Seba-SL/TP-Taller-de-Dise-o-de-Circuitos-Electr-nicos-TA138-/Checkpoints/Checkpoint 4/Informe CHK 4/informe.tex

\documentclass[]{article}

\usepackage{graphicx}
\usepackage[margin=1.5cm,top=1.5cm,bottom=1.5cm,a4paper]{geometry}
\usepackage{graphicx} % Required for inserting images
\usepackage{titlesec} % Required for customizing section titles
\usepackage[margin=1.5cm,top=1.5cm, bottom=1.5cm]{geometry} % Ajusta los márgenes aquí
\usepackage{multicol} % Required for multicols environment
\usepackage{parskip}
\usepackage{etoolbox}
\usepackage{tcolorbox}
\usepackage{float}
\usepackage{amsmath}
\usepackage{dingbat}
\usepackage{booktabs} 
\usepackage{caption}
\usepackage[utf8]{inputenc}
\usepackage[T1]{fontenc}
\usepackage{amssymb}
\usepackage[spanish]{babel}
\usepackage{multirow}
\usepackage{siunitx}
\usepackage{circuitikz}
\usepackage{pdflscape}
\usepackage{subcaption}
\usepackage{array}
\usepackage{tcolorbox}
\usepackage{xcolor}
\usepackage{pdfpages}
\usepackage{placeins}

\newif\ifcheckpoint
\checkpointfalse

% función que devuelve color según checkpoint
\newcommand{\checkpointcolor}[1]{%
	\ifcase#1
	yellow%
	\or blue%
	\or green%
	\or red%
	\or orange%
	\else gray%
	\fi
}
\newcommand{\checkpointstart}[1]{%
	\ifcheckpoint
	\edef\tempcolor{\checkpointcolor{#1}}%
	\begin{tcolorbox}[
		colback=\tempcolor!15,
		colframe=\tempcolor!60!black,
		boxrule=0pt,
		arc=0pt,
		width=\textwidth
		]
		\textbf{Inicio checkpoint #1}
	\end{tcolorbox}
	\fi
}

\newcommand{\checkpointend}[1]{%
	\ifcheckpoint
	\edef\tempcolor{\checkpointcolor{#1}}%
	\begin{tcolorbox}[
		colback=\tempcolor!15,
		colframe=\tempcolor!60!black,
		boxrule=0pt,
		arc=0pt,
		width=\textwidth
		]
		\textbf{Fin checkpoint #1}
	\end{tcolorbox}
	\fi
}

\usepackage{tikz}
\usetikzlibrary{arrows.meta, positioning}
\usetikzlibrary{babel}

\usepackage{csquotes}

\usepackage[
backend=biber,
style=apa,
citestyle=apa
]{biblatex}

\addbibresource{referencias.bib}

\begin{document}
	
	\begin{titlepage}
		
		\centering
		{}
		
		\centerline
		
		{\bfseries\LARGE Taller de Diseño de Circuitos Electrónicos   \par}
		
		{\bfseries\LARGE TA138  \par}
		\vspace{.5cm}
		{\scshape\Large Facultad de Ingenier\'ia Universidad de Buenos Aires \par}
		\vspace{1.5cm}
		%{\scshape\Huge Trabajo Pr\'actico \par}
		{\scshape\Huge Diseño de Fuente de Alimentación \par}
		\vspace{2cm}
		{\scshape\Large Checkpoint 4: Diseño y Validación de Conversor \textit{Buck} a Lazo Abierto\par}

		\vspace{2cm}
		
		\begin{tabular}{ p{4cm} p{2cm} p{4cm}}
			\textbf{Alumnos:} & \textbf{Padr\'on:} & \textbf{Mail:} \\
			Lazo, Sebastian Nahuel & 106213 &slazo@fi.uba.ar \\
			Flores, Ahmed Ali & 106238 & aaflores@fi.uba.ar  \\
			Mántaras, Ramiro  & 111510 &rmantaras@fi.uba.ar \\
			
		\end{tabular}

		\vspace{1cm}
		
		\begin{tabular}{ p{6cm} p{6cm} p{6cm}}
			\textbf{Docentes:}  
			\\Teóricas: Julio Zola & Tutor: Sergio Andres Quinteros  
		\end{tabular}
		
	\end{titlepage}

	\newpage

	\tableofcontents \label{Indice}
	\newpage
	\section{Introducción}
	
	En el checkpoint 4 se continúa con el desarrollo de una fuente de alimentación conmutada tipo \textit{buck} destinada a obtener una tensión de salida regulada de 9.5 V a partir de una fuente de alimentación de continua proveniente de una batería. El sistema debe operar de manera eficiente frente a variaciones de tensión de entrada comprendidas entre 12 V y 30 V, permitiendo su utilización en aplicaciones industriales y automotrices destinadas a la alimentación de microcontroladores, sensores y sistemas de comunicación.
	
	En etapas previas del proyecto se desarrolló y verificó el funcionamiento de la conversión de 9,5 V a 5 V, en el apéndice \ref{sec:etapa_previa} se agregaron mediciones extra pedidas y modificaciones de acuerdo a los errores encontrados en el checkpoint previo. En esta instancia se avanza sobre el diseño y validación de la etapa \textit{buck} en lazo abierto, incorporando aspectos vinculados tanto a la simulación funcional como a el diseño circuital del sistema.
	
	Asimismo, se aborda el diseño del circuito generador PWM utilizado para el control de conmutación, el análisis de las características físicas y constructivas del inductor diseñado, y el desarrollo del diseño PCB correspondiente a la fuente \textit{buck} en lazo abierto.
	
	\section{Objetivo}
	Los objetivos del presente checkpoint son:
	
	\begin{itemize}
		\item Verificar mediante simulaciones el correcto funcionamiento de la fuente buck en configuración de lazo abierto.
		
		\item Diseñar e implementar el circuito PWM encargado de generar la señal de conmutación del convertidor.
		
		\item Analizar y definir las características físicas del inductor diseñado para la etapa de potencia.
		
		\item Realizar el diseño PCB de la fuente buck en lazo abierto considerando criterios de implementación electrónica y distribución física.
		
		\item Integrar los distintos bloques desarrollados con el fin de avanzar hacia una implementación funcional del sistema de alimentación switching.
	\end{itemize}

	\section{Desarrollo}
	
	\subsection{Especificaciones del Regulador BUCK}
	El sistema deberá operar con una tensión de entrada comprendida entre \SI{12}{V} y \SI{30}{V} considerándose como tensión típica \SI{24}{V}, entregando una tensión regulada nominal de aproximadamente \SI{9.5}{V}. 
	
	Asimismo, la corriente de salida deberá encontrarse en el rango de \SI{750}{mA} a \SI{1.5}{A}, manteniendo una eficiencia comprendida entre el 85\% y el 95\%, dependiendo de las condiciones de operación.
	
	La frecuencia de conmutación seleccionada para el convertidor será del rango de 
	\SI{120}{kHz} hasta \SI{140}{kHz}.
	
	\renewcommand{\arraystretch}{1.3}
		\begin{table}[H]
		\centering
		\caption{Especificaciones del regulador BUCK}
		\label{tab:spec_buck}
		\begin{tabular}{|c|c|}
			\hline
			Parámetro & Valor \\  \hline \hline
			Tensión de entrada $V_{IN}$ & \SI{12}{V} -- \SI{30}{V} \\ \hline
			Tensión regulada $V_{REG}$ & \SI{9.5}{V} nominal \\ \hline
			Corriente de salida $I_{OUT}$ & \SI{750}{mA} -- \SI{1.5}{A} \\ \hline
			Eficiencia $\eta$ & 85\% -- 95\% \\ \hline
			Frecuencia de conmutación $f_{sw}$ & \SI{120}{kHz} -- \SI{140}{kHz} \\ \hline
		\end{tabular}
	\end{table}
	
	\subsubsection{Convertidor BUCK}
	
	En términos generales, un convertidor \textit{buck} se alimenta de una señal de entrada a a regular, por medio de dos transistores en conmutación, que generan una señal cuadrada que tiene como valor medio la tensión objetivo, la señal cuadrada generada es filtrada por un filtro LC, obteniendo de esta forma una tensión regulada con riple cuadrático. En la figura \ref{fig:buck_schematic}, se observa un circuito \textit{buck} inicial de diseño.
	
	\begin{figure}[H]
		\centering
		\resizebox{0.9\textwidth}{!}{
\begin{tikzpicture}[transform shape]
	% Paths, nodes and wires:
	\node[nigfetd, rotate=90](N1) at (11.77, 11){} node[anchor=south] at (N1.text){$Q_1$};
	\node[nigfetd](N2) at (14, 9.27){} node[anchor=west] at (N2.text){$Q_2$};
	\draw (18, 11) to[capacitor, l={$C_S$}] (18, 8);
	\draw (20, 11) to[american resistor, l={$R_S$}] (20, 8);
	\draw (14, 11) -- (14, 10);
	\draw (18, 8) |- (14, 8) -| (14, 8.46);
	\draw (18, 11) -- (20, 11);
	\draw (20, 8) -- (18, 8);
	\draw (12.039, 10.02) |- (11, 9.5);
	\draw (14, 8.5) -| (14, 8.46);
	\draw (13.02, 9) -| (11, 9);
	\draw (9, 8) to[capacitor, l={$C_E$}] (9, 11);
	\draw (9, 8) -- (14, 8);
	\draw (9, 11) -- (11, 11);
	\draw (12.54, 11) -- (14, 11);
	\draw (14, 11) to[cute inductor, l={$L$}] (18, 11);
	\draw (6, 11) to[battery, l={$V_E$}] (6, 8);
	\node[circ] at (9, 11){};
	\node[circ] at (9, 8){};
	\node[circ](N3) at (11, 9.5){} node[anchor=east] at (N3.text){$H_{ctrl}$};
	\node[circ](N4) at (11, 9){} node[anchor=east] at (N4.text){$L_{ctrl}$};
	\node[circ] at (14, 8){};
	\node[circ](N5) at (14, 11){} node[anchor=south] at (N5.text){$V_S$};
	\node[circ] at (18, 11){};
	\node[circ] at (18, 8){};
	\node[circ](N6) at (20, 11){} node[anchor=south] at (N6.text){$V_o$};
	\node[flowarrow] at (21.25, 11){};
	\draw (20, 11) -- (21, 11);
	\draw (9, 11) -- (6, 11);
	\draw (9, 8) |- (6, 8);
\end{tikzpicture}
		}
		\caption{Circuito \textit{buck}.}
		\label{fig:buck_schematic}
		
	\end{figure}

	Entendiendo la señal de control como una señal periódica cuadrada que alterna entre una tensión suficiente para colocar a los transistores en saturación (\textit{on}) y otra que los lleva a corte (\textit{off}), en dicha señal se define el tiempo $t_{ON}$ como el tiempo que dura la señal que permite la conducción en el transistor en un periodo T. Aquí a su vez se define el ciclo de trabajo D (duty cicle) como $ D = \frac{t_{ON}}{T}$. 
	
	\begin{figure}[H]
		\centering
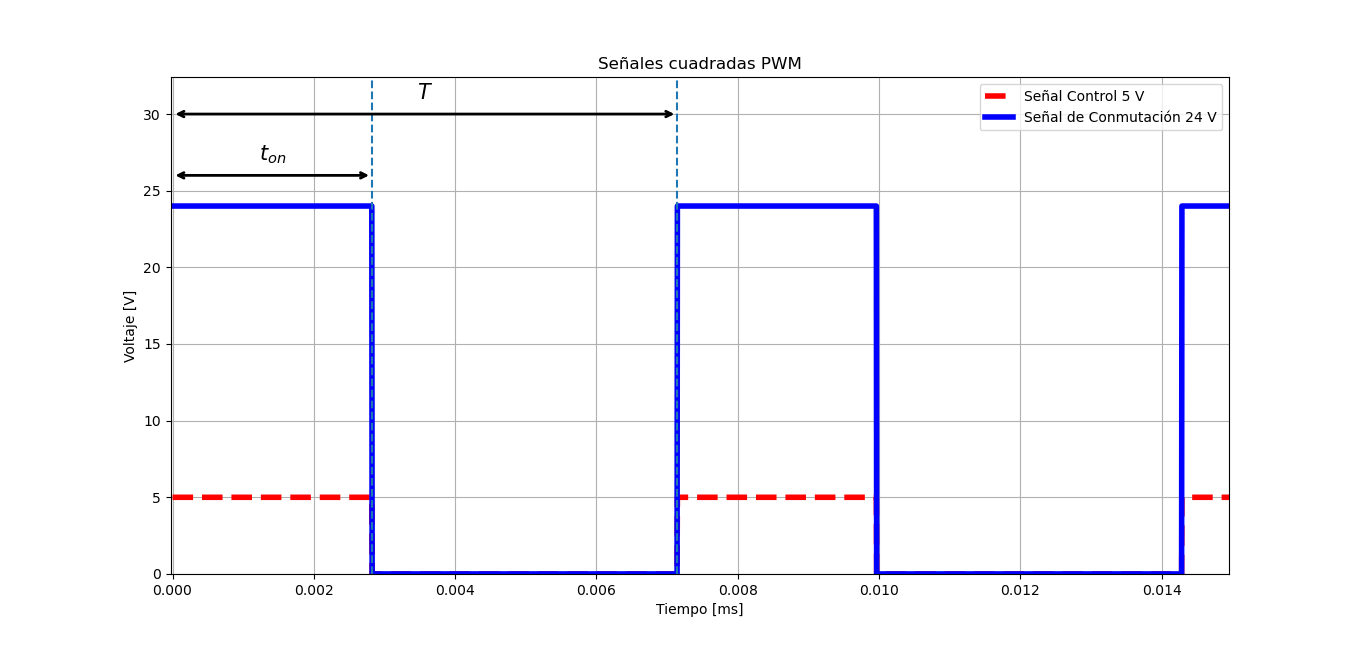
[picture p1: Checkpoints/Checkpoint 4/Informe CHK 4/img/buck/vcontrol.png]
		
		\caption{ Señal de control y señal conmutada lograda en el circuito buck.}
		\label{fig:vcontrol}
		\end{figure}

	Teniendo en cuenta que el transistor permite replicar la señal de control en el nodo que interconecta los transistores y el inductor, pero con una tensión cercana a la tensión de alimentación, dicha señal se define como señal de conmutación o \textit{switching} $V_s$. Tal como se ve en la figura \ref{fig:vcontrol}.

	De esta relación estimando las tensiones de saturación y de caida de tensión en directa del diodo utilizado, se puede dar con una primer aproximación de D. Aproximando la salida del regulador como la componente continua de la señal de conmutación, idealizando el filtro LC.

	\begin{equation}
		V_o \approx V_{s_{\text{prom}}}
		=
		\frac{1}{T}\int_0^T v_s(t)\,dt
	\end{equation}
	
	Considerando que durante el intervalo de conducción del transistor ($t_{on}$) la tensión aplicada al inductor es aproximadamente $(V_E - V_{SAT})$, y durante el intervalo restante ($T-t_{on}$) el diodo conduce imponiendo una tensión aproximada $-V_D$, la señal de conmutación puede modelarse como:
	
	\begin{equation}
		v_s(t)=
		\begin{cases}
			V_E - V_{SAT}, & 0<t<t_{on} \\
			-V_{SAT}, & t_{on}<t<T
		\end{cases}
	\end{equation}
	
	Por lo tanto, el valor promedio resulta:
	
	\begin{equation}
		V_o \approx
		\frac{1}{T}
		\left[
		\int_0^{t_{on}} (V_E - V_{SAT})\,dt
		+
		\int_{t_{on}}^T (-V_{SAT})\,dt
		\right]
	\end{equation}
	
	Resolviendo las integrales:
	
	\begin{equation}
		V_o \approx
		\frac{1}{T}
		\left[
		(V_E - V_{SAT})t_{on}
		-
		V_{SAT}(T-t_{on})
		\right]
	\end{equation}
	
	Reordenando:
	
	\begin{equation}
		V_o \approx
		\frac{t_{on}}{T}(V_E - V_{SAT})
		-
		\frac{T-t_{on}}{T}V_{SAT}
	\end{equation}
	
	Definiendo el ciclo de trabajo como:
	
	\begin{equation}
		D = \frac{t_{on}}{T}
	\end{equation}
	
	y teniendo en cuenta que:
	
	\begin{equation}
		1-D = \frac{T-t_{on}}{T}
	\end{equation}
	
	se obtiene finalmente:
	
	\begin{equation}
		V_o \approx D(V_E - V_{SAT}) - (1-D)V_{SAT}
	\end{equation}

	Aproximando las caídas de tensión de los transistores en conducción a cero:
	
	\begin{equation}
		V_{SAT} \approx 0
	\end{equation}
	
	la expresión obtenida previamente se simplifica a:
	
	\begin{equation}
		V_o \approx D \cdot V_E
	\end{equation}
	
	Despejando el ciclo de trabajo:
	
	\begin{equation}
		D \approx \frac{V_o}{V_E}
	\end{equation}
	
	Reemplazando con los valores de diseño:
	
	\begin{equation}
		D \approx \frac{9.5\,V}{24\,V}
	\end{equation}
	
	\begin{equation}
		D \approx 0.396
	\end{equation}
	
	Por lo tanto, el ciclo de trabajo requerido resulta aproximadamente:
	
	\begin{equation}
		D \approx 39.6\%
	\end{equation}

	El principio de funcionamiento del regulador se basa en la transferencia periódica de energía desde la fuente de entrada hacia la carga mediante la conmutación controlada de los dispositivos electrónicos de potencia. La tensión media de salida se regula variando el ciclo de trabajo $D$ de la señal PWM aplicada a las llaves de conmutación.

	Asimismo, se analizará el regulador operando en modo de conducción continua (CCM, \textit{Continuous Conduction Mode}), condición en la cual la corriente del inductor nunca se anula ni invierte su sentido. Bajo esta hipótesis, la corriente del inductor presenta una forma aproximadamente triangular con un valor medio distinto de cero, mientras que el capacitor forma una tensión integrando dicha tensión menos la corriente de salida, dado que la integral de una señal lineal que alterna entre pendiente positiva y negativa la tensión del capacitor sera una señal cuadrática tal como se observa en la figura \ref{fig:corrienteilriplevo}.
	
	A partir de estas consideraciones será posible determinar posteriormente los valores adecuados del inductor $L$ y del capacitor $C$, de forma tal de garantizar un funcionamiento estable en conducción continua y un rizado acotado en corriente y tensión.

	\begin{figure}[H]
	\centering
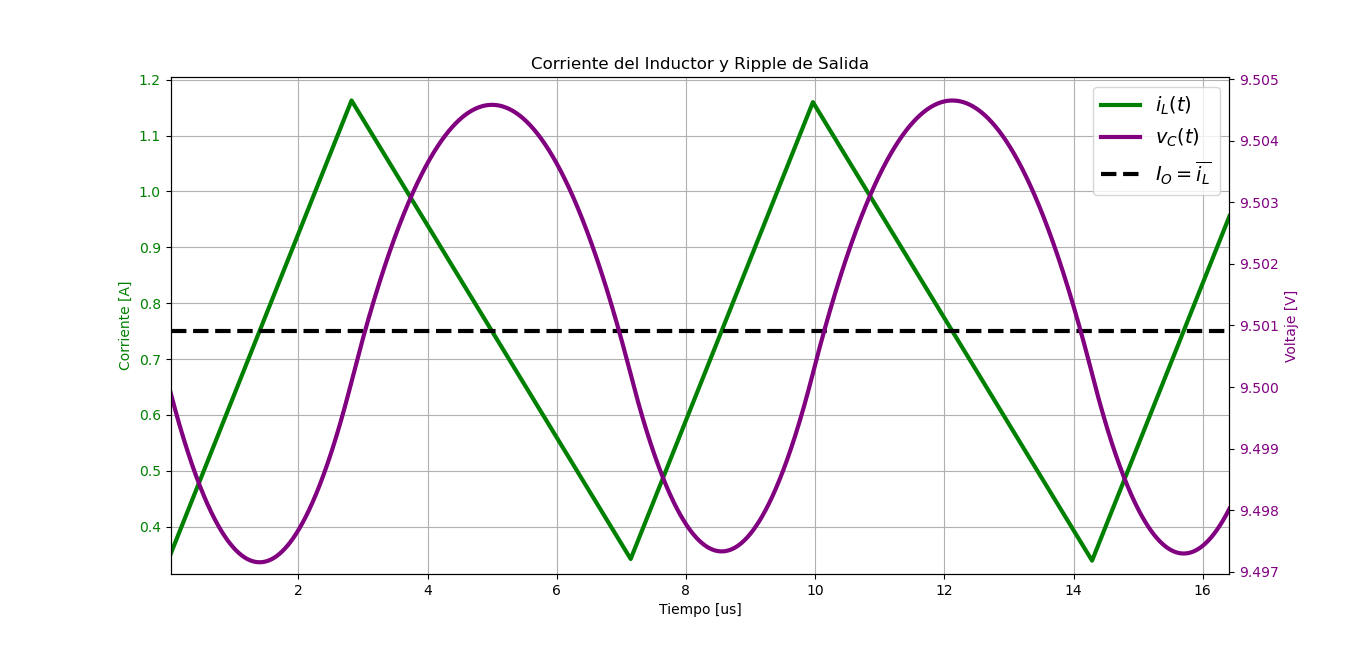
[picture p2: Checkpoints/Checkpoint 4/Informe CHK 4/img/buck/corriente_iL_riple_Vo.png]
	
	\caption{Forma de la señal de corriente en el inductor y tensión en el capacitor del regulador.}
	\label{fig:corrienteilriplevo}
	\end{figure}

	La corriente de salida se puede aproximar a la corriente media en el inductor, justamente para que la corriente no se vuelva discontinua la corriente de salida debe ser mayor a cero, es por eso que se fija un resistor de salida para que la corriente de salida no llegue a ser nula. 
	
	\begin{equation}
		I_O \approx \frac{I_{L\text{MAX}} + I_{L\text{MIN}}}{2}
	\end{equation}

	\subsection{Elección de elementos esenciales $L$ , $C_S$ , $C_E$ y $Q$}
	
	\subsubsection{Inductor $L$ y capacitor $C_S$}
	
	Teniendo en cuenta que para el ciclo \textit{off} la tensión de salida corresponde con aproximadamente la tensión en el inductor:
	
	\begin{equation}
		V_o \approx L \frac{d i_L }{dt} = L \frac{ {I_{min}} - {I_{max}} }{  T - t_{on}}
	\end{equation} 
	
	Despejando el valor de inductancia:
	
	\begin{equation}
		L \approx V_o  \frac{  T - t_{on}}{ {I_{min}} - {I_{max}} }
	\end{equation} 
	
	Sacando como factor común T de la expresión e ingresando D.

	\begin{equation}
	L \approx V_o  \frac{  T - t_{on}}{ {I_{min}} - {I_{max}} } =  V_o  T \frac{  (1 - \frac{t_{on}}{T})}{ {I_{min}} - {I_{max}} } 
	\end{equation} 

	\begin{equation}
		L \approx  V_o  T \frac{  1 - D} {   I_{min} - {I_{max}}    } 
	\end{equation} 
	
	Ahora sabiendo que $I_o = \frac{(I_{min} - I_{max})}{2}$ y despejando $ I_{min} = 2I_o - I_{max}$, se reemplaza:
	
	\begin{equation}
		L \approx  V_o \cdot T \frac{  1 - D} {   (2I_o - I_{max}) - {I_{max}}    } 
	\end{equation} 

	\begin{equation}
		L \approx  V_o \cdot T \frac{  1 - D} {   (2I_o - 2I_{max})   }  = V_o \cdot T \frac{  1 - D} {   2(I_o - I_{max})   }
	\end{equation} 

	\begin{equation}
		L \approx  V_o \cdot T \frac{  1 - D} {   (2I_o - 2I_{max})   }  = V_o  \frac{T}{2} \frac{  1 - D} {   (I_o - I_{max})   }
	\end{equation} 

	Reemplazando $T = \frac{1}{f}$ se obtiene finalmente la expresión:
	
	\begin{equation}
		L =
		\frac{1}{2f}
		\left(
		\frac{(1-D)V_S}{I_{L\text{MAX}} - I_o}
		\right)
	\end{equation}

	De esta forma se puede estimar un valor de inductancia 
	Partiendo de:
	
	\begin{equation}
		L = \frac{1}{2f}\,\frac{(1-D)V_o}{(I_{L\text{MAX}} - I_o)}
	\end{equation}
	
	y siendo para el modo crítico:
	
	\begin{equation}
		I_o = I_{o\text{MIN}}
	\end{equation}
	
	Resulta:
	
	\begin{equation}
		I_{L\text{MAX}} = 2I_{o\text{MIN}}
	\end{equation}
	
	\begin{equation}
		L = \frac{(1-D)V_o}{2f\,I_{o\text{MIN}}}
	\end{equation}
	
	Llamando \(R_{\text{MAX}}\) al valor máximo de \(R_c\):
	
	\begin{equation}
		R_{\text{MAX}} = \frac{V_o}{I_{o\text{MIN}}}
	\end{equation}
	
	se obtiene el valor crítico de \(L\) (\(L_{cr}\)) que permite continuar operando en modo continuo con una corriente de carga mínima o “carga mínima”:
	
	\begin{equation}
		L_{cr} = \frac{(1-D)R_{\text{MAX}}}{2f}
	\end{equation}
	
	Debe ser:
	
	\begin{equation}
		L > L_{cr}
	\end{equation}
	
	para operación en modo continuo.
	
	También puede encontrarse el valor crítico de la resistencia de carga que asegura el funcionamiento en modo continuo para un valor dado de \(L\):
	
	\begin{equation}
		R_{cr} = \frac{2fL}{(1-D)}
	\end{equation}
	
	Debe cumplirse:
	
	\begin{equation}
		R < R_{cr}
	\end{equation}
	
	para operación en modo continuo.
	
	Contemplando la frecuencia mayor brindada por las especificación con el objetivo de minimizar el riple en la salida, ya que el filtro pasa bajos LC atenuara mucho mas las frecuencias altas y también nos dará valores de L y C mas bajos para el mismo filtro.
	
	Reemplazando en las expresiones con los valores de frecuencia elegida $f = 140 \, kHz$, ciclo de trabajo $D = 0,395$, $I_{min} = 750 \, mA$, $I_{max} = 1,5 \,A$ y rimple de $\Delta V_o = 400 \, mV$, llegando a los valores críticos: 
	
	\renewcommand{\arraystretch}{1.5}
	\begin{table}[H]
		\centering
		\caption{Valores críticos para conservar la conducción continua}
		\renewcommand{\arraystretch}{1.5}
		\begin{tabular}{|c|c|c|}
			\hline
			\textbf{Parámetro crítico} & \textbf{Expresión utilizada} & \textbf{Condición para MCC} \\
			\hline
			
			Inductancia crítica \(L_{cr}\) &
			\(
			L_{cr}= \frac{(1-D)V_o}{2f\,I_{o\text{MIN}}}
			\)
			&
			\(
			L > L_{cr} \approx 27,37 \, \mu H
			\)
			\\
			
			\hline
			
			Resistencia crítica \(R_{cr}\) &
			\(
			R_{cr}=\dfrac{2fL}{(1-D)}
			\)
			&
			\(
			R < R_{cr} \approx 12,67\, \Omega
			\)
			\\
			
			\hline
			
			Capacitancia crítica \(C_{cr}\) &
			\(
			C_{cr}=\dfrac{1-D}{16Lf^2\left(\dfrac{\Delta V_o}{V_o}\right)}
			\)
			&
			\(
			C > C_{cr} \approx 3,34 \, uF
			\)
			\\
			
			\hline
			
			Corriente mínima de carga \(I_{o\text{MIN}}\) &
			\(
			I_{o\text{MIN}}=\dfrac{(1-D)V_s}{2fL}
			\)
			&
			\(
			I_o >= I_{o\text{MIN}} = 750 \, mA
			\)
			\\
			
			\hline
			
		\end{tabular}
		\label{tab:criticos_mcc}
	\end{table}

	Con los valores hallados en la tabla \ref{tab:criticos_mcc} se obtienen los limites para que el circuito trabaje en modo conducción continua, pero no serán los valores óptimos para regular la tensión, para asegurar que el riple sea minimo se considera un capacitor $100 \, \mu F$ y para que la corriente continua de salida tenga alguna utilidad se coloca un diodo led que indique que el regulador esta encendido para eso se debe calcular un resistor 
	
	\subsubsection{Transistores de conmutación}
	Para la elección de transistores de paso debe hacerce un balance entre resistencia equivalente en conducción $R_{ON}$, sus capacidades parásitas $C_{gs}$, $C_{gd}$ y $C_{ds}$ y el costo.
	El modelo elegido para la aplicación es el transistor N-MOS \textbf{IRF3205}, debido a su costo moderado

	\subsubsection{Frecuencia de oscilador}
	
	Como regla práctica, a fin de maximizar la eficiencia, el periodo mínimo del oscilador debe ser aproximadamente cien veces mayor que el tiempo de conmutación del transistor. Porque así el MOSFET pasa más del 99 \% del tiempo en estados ideales (encendido o apagado) y menos del 1 \% del tiempo en la región de transición donde disipa mucha potencia.

\begin{minipage}[c]{0.35\textwidth}
		\begin{figure}[H]
		\centering
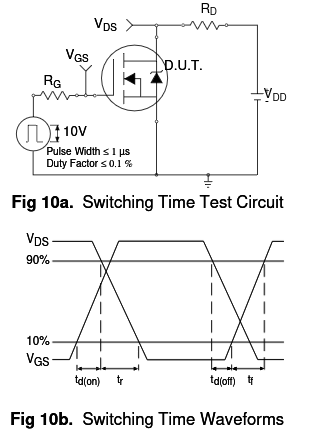
[picture p3: Checkpoints/Checkpoint 4/Informe CHK 4/img/buck/tiempo_conmutacionIRF3205.png]
		
		\caption{Formas de onda de tiempo de conmutación para el IRF3205.}
		\label{fig:tiempoconmutacionirf3205}
	\end{figure}
	
\end{minipage}
\hfill
\begin{minipage}[c]{0.60\textwidth}
	
	\begin{equation}
		T_{sw} = 100\cdot t_{sw}
	\end{equation}

	Cuando se aplica la tensión de entrada base, el transistor no se enciende inmediatamente. Al igual que la respuesta de frecuencia, los tiempos de conmutación de transistores se ven afectados por la capacitancia de la unión y el tiempo de tránsito de los electrones a través de las uniones. El tiempo entre la aplicación del impulso de entrada y el comienzo del flujo de corriente del drenaje se denomina el tiempo de retardo (td), incluso cuando el transistor comienza a encenderse, transcurre un tiempo finito antes de que el CI alcance su nivel máximo. Esto se conoce como el tiempo de subida ($t_{d_{on}}$) y de bajada $t_{d_{off}}$.

El tiempo de subida se especifica como el tiempo requerido para que el CI pase del 10\% al 90\% de su nivel máximo. 

Para el IRF3205 el tiempo de retardo de encendido ($t_{d_{on}}$) es de $14 \, ns$  y el tiempo en que se produce la caída de tensión entre el drain y source es de $t_r = 101 \,ns$ mientras que el tiempo de retardo de apagado ($t_{d_{off}}$) es de $ 50 \, ns$ y el tiempo en que se produce el cambio de tensión en $v_{ds}$ es de $t_f = 65 \, ns $ , por lo tanto se consideran los tiempos de encendidos y de apagado como:

\begin{itemize}
	\item $t_{on} =t_{d_{on}} + t_r =  115 \,ns$
	\item $t_{off} = t_{d_{off}} + t_f = 115 \,ns $	
\end{itemize}

Dando asi el tiempo de conmutación como $t_{sw} = 115 \, ns$

\end{minipage}

Por lo tanto el periodo de oscilación tiene que ser como mínimo T $ \geq   100 \cdot t_{sw} = 11,5 \, \mu s$, siendo así la frecuencia máxima para lograr una eficiencia 86,95 kHz. Por lo tanto al utilizar una frecuencia de 140 kHz se debe considerar una menor eficiencia.

	\begin{table}[H]
		\centering
		\caption{Componentes seleccionados para el convertidor Buck}
		\renewcommand{\arraystretch}{1.5}
		\begin{tabular}{|c|c|c|c|}
			\hline
			\textbf{Componente} & \textbf{Símbolo} & \textbf{Valor / Modelo} & \textbf{Observaciones} \\
			\hline
			
			Inductor de salida & \(L\) & $50 \mu H $&  \\
			\hline
			
			Capacitor de salida & \(C\) & $100 \mu F$ &  \\
			\hline
			
			Capacitor de entrada & \(C_{in}\) & $100 \mu F$ &  \\
			\hline
			
			MOSFET superior & \(Q_1\) & N-MOS IRF3205  &  \\
			\hline
			
			MOSFET inferior & \(Q_2\) & N-MOS IRF3205  &  \\
			\hline
			
			Frecuencia de conmutación & \(f_s\) & 140 kHz&  \\
			\hline
			
			Tensión de entrada & \(V_{in}\) & 24 V &  \\
			\hline
			
			Tensión de salida & \(V_o\) & 9,5 v  &  \\
			\hline
			
			Corriente máxima de salida & \(I_o\) & 1,5 A &  \\
			\hline
			
		\end{tabular}
		\label{tab:componentes_buck}
	\end{table}

	\subsection{Diseño verificado por simulación de la fuente buck a lazo abierto}

	Se simuló mediante el software Ltspice el comportamiento del circuito utilizando el esquematico de la captura \ref{fig:simulacionbucklazoabierto} y los diferentes modelos de componentes a lazo abierto, es decir sin utilizar la realimentación para el control de los transistores si no un generador de pruebas en el transistor que implementaría el $t_{on}$ y un diodo de rapida conmutación en reemplazo del transistor de tiempo $t_{off}$ . 
	
	\begin{figure}[H]
		\centering
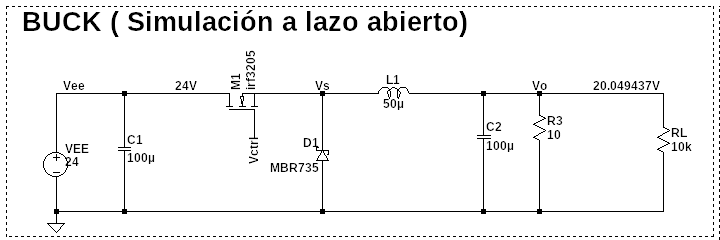
[picture p4: Checkpoints/Checkpoint 4/Informe CHK 4/img/buck/simulacion_buck_lazo_abierto.png]
		
		\caption{Captura esquemático de simulación en ltspice de circuito \textit{buck} a lazo abierto.}
		\label{fig:simulacionbucklazoabierto}
	\end{figure}

	Se puede verificar la correcta regulación luego de un transitorio, graficando los datos de tensión de salida extraidos de la simulación como se muestra en la Fig. \ref{fig:reguladorbucklazoabierto}.

	\begin{figure}[H]
		\centering
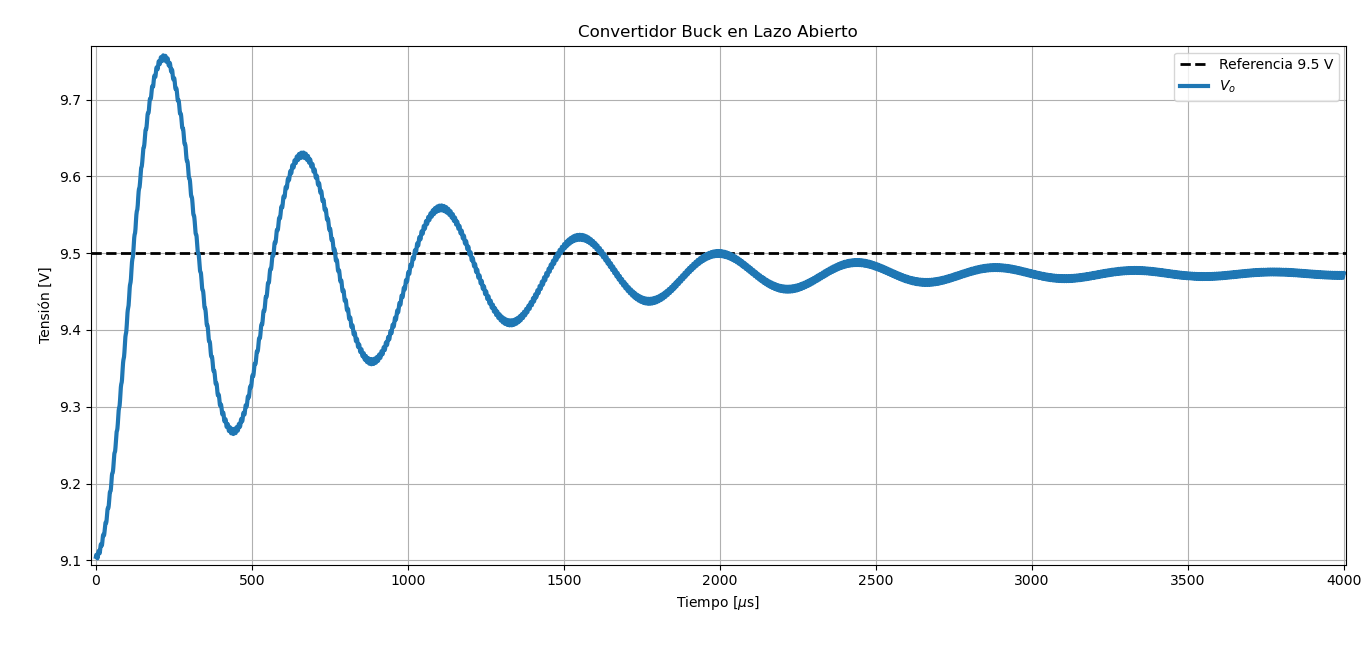
[picture p5: Simulación/BUCK/Datos/regulador_buck_Lazo_abierto.png]
		
		\caption{Datos de tensión de salida extraídos de la simulación del \textit{buck} a lazo abierto.}
		\label{fig:reguladorbucklazoabierto}
	\end{figure}

Mientras que en la Fig. \ref{fig:corrientesiliobucklazoabierto} se verifica que se encuentra trabajando en conducción continua.

\begin{figure}[H]
	\centering
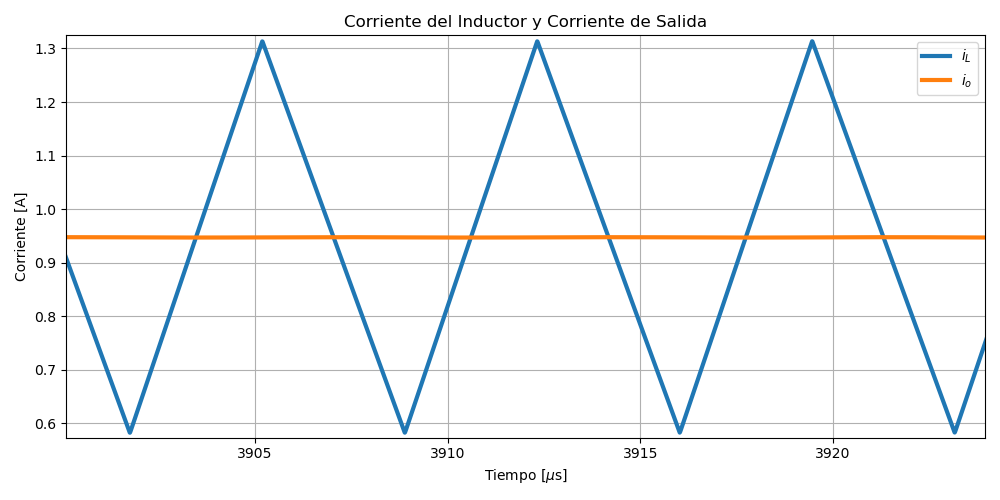
[picture p6: Checkpoints/Checkpoint 4/Informe CHK 4/img/buck/CorrientesIL_Io_buck_lazo_abierto.png]
	
	\caption{Corriente en el inductor y resistor de salida, datos extraídos de la simulación del \textit{buck} a lazo abierto.}
	\label{fig:corrientesiliobucklazoabierto}
\end{figure}

	\subsection{Diseño del lazo realimentador}
	
	Una vez verificado el diseño de la fuente conmutada, se debe diseñar un lazo capaz de regularla. Para cumplir con este requerimiento, se parte de la salida de la fuente (figura \ref{fig:buck_schematic}), y se genera una señal PWM capaz de controlar la conmutación de los transistores. En la figura \ref{fig:bloque_PWM} puede verse la estructura simplificada del lazo.

		\begin{figure}[H]
		\centering
		\begin{tikzpicture}[transform shape]
			% Paths, nodes and wires:
			\draw (9.99, 7.5) to[twoport] (11.99, 7.5);
			\draw (10.99, 7.98) to[american resistor, /tikz/circuitikz/bipoles/length=0.700cm] (10.99, 7);
			\node[plain amp, xscale=-1, yscale=-1] at (8.94, 7){};
			\node[circ](N1) at (12, 6.52){} node[anchor=west] at (N1.text){$v_{ref}$};
			\node[circ](N2) at (11.99, 7.49){} node[anchor=west] at (N2.text){$v_{o}$};
			\draw (10, 6.52) -| (12, 6.5);
			\node[nigfetd, xscale=0.5, yscale=0.5] at (4.48, 6.52){};
			\node[plain amp, xscale=-1, yscale=-1] at (6.43, 6.52){};
			\node[shape=rectangle, minimum width=1.465cm, minimum height=0.965cm] at (9, 7){} node[anchor=center, align=center, text width=1.077cm, inner sep=6pt] at (9, 7){\tiny Amplificador de error};
			\node[shape=rectangle, minimum width=1.465cm, minimum height=0.965cm] at (6.5, 6.5){} node[anchor=center, align=center, text width=1.077cm, inner sep=6pt] at (6.5, 6.5){\tiny Comparador PWM};
			\node[shape=rectangle, draw, line width=1pt, minimum width=0.965cm, minimum height=0.965cm] at (4.25, 6.5){};
			\draw (5.24, 6.52) -| (4.75, 6.5);
			\draw (8, 5) |- (7.62, 6.03);
			\draw (8.5, 4.5) |- (8, 4.5) -| (8, 5);
			\node[shape=rectangle, minimum width=1.945cm, minimum height=1.215cm] at (10.01, 4.375){} node[anchor=center, align=center, text width=1.557cm, inner sep=6pt] at (10.01, 4.375){\tiny Generador de señal triangular};
			\node[shape=rectangle, draw, line width=1pt, minimum width=1.945cm, minimum height=1.225cm] at (10.01, 4.38){};
			\draw (9, 4.5) -- (8.5, 4.5);
			\draw (9, 4.5) -| (9.02, 4.51);
			\node[shape=rectangle, minimum width=1.465cm, minimum height=0.965cm] at (11, 8.25){} node[anchor=center, align=center, text width=1.077cm, inner sep=6pt] at (11, 8.25){\small Escalado};
			\node[shape=rectangle, minimum width=1.465cm, minimum height=0.965cm] at (4.25, 7.5){} node[anchor=center, align=center, text width=1.077cm, inner sep=6pt] at (4.25, 7.5){\small Gate Driver};
			\node[shape=rectangle, draw, line width=1pt, minimum width=0.945cm, minimum height=0.965cm] at (4.26, 4.5){};
			\draw (4.26, 4) to[empty Schottky diode, /tikz/circuitikz/bipoles/length=0.840cm] (4.26, 5);
			\draw (4.26, 5) |- (4.25, 5.25);
			\draw (4.26, 4) |- (4.25, 3.75);
			\node[tlground] at (4.25, 3.75){};
			\node[circ](N3) at (4.26, 5.25){} node[anchor=south] at (N3.text){$V_{E}$};
			\draw (4.75, 4.5) -- (5, 4.5);
			\node[circ](N4) at (5, 4.5){} node[anchor=west] at (N4.text){$V_{5V}$};
			\draw (10, 5) |- (9.99, 5.25);
			\draw (10.01, 3.75) |- (10, 3.5);
			\node[tlground] at (10, 3.5){};
			\node[circ](N5) at (10, 5.25){} node[anchor=south] at (N5.text){$V_{5V}$};
			\draw (9, 7.75) |- (8.99, 8);
			\draw (9, 6.5) |- (8.99, 6.25);
			\node[tlground] at (8.99, 6.25){};
			\node[circ](N6) at (9, 8){} node[anchor=south] at (N6.text){$V_{5V}$};
			\draw (9, 7.75) -- (9, 7.5);
			\draw (6.51, 7.25) |- (6.5, 7.5);
			\draw (6.51, 6) |- (6.5, 5.75);
			\node[tlground] at (6.5, 5.75){};
			\node[circ](N7) at (6.51, 7.5){} node[anchor=south] at (N7.text){$V_{5V}$};
			\draw (6.51, 7.25) -- (6.51, 7);
			\draw (7.75, 7) |- (7.62, 7.01);
		\end{tikzpicture}
		\caption{Diagrama de bloques del lazo realimentador.}
		\label{fig:bloque_PWM}
	\end{figure}
	
	Se sensa la señal de salida y se obtiene el error respecto de una referencia. Luego, se compara el error con una señal triangular, cuyo objetivo es aumentar el duty si el error es negativo (tensión de salida baja) y disminuirlo si es positivo.
	
		\subsubsection{Escalador de señal de salida}
	
	Se busca comparar la señal de salida con una tensión de referencia más baja. Para ello debe escalarse $V_o$ de tal modo que, si $V_o$ tiene el valor deseado, $v_{med} = V_o \cdot escalado$. Se elige una combinación de resistores tal que $\SI{9.5}{V} \cdot escalado = v_{med} =\SI{2.5}{V} \to escalado = 0.263$. La figura \ref{fig:escalado} muestra su topología.
	
	\begin{figure}[H]
		\centering
		\begin{tikzpicture}[transform shape]
			% Paths, nodes and wires:
			\draw (8, 8) to[american resistor, /tikz/circuitikz/bipoles/length=0.840cm, l={$R_1$}] (8, 6);
			\draw (9, 8) to[american resistor, /tikz/circuitikz/bipoles/length=0.840cm, l={$R_2$}] (9, 6);
			\draw (8, 6) to[american resistor, /tikz/circuitikz/bipoles/length=0.840cm, l={$R_3$}] (8, 4.5);
			\node[ground] at (8, 4.5){};
			\draw (8, 6) -- (9, 6);
			\draw (9, 8) -- (8, 8);
			\draw (8, 8) -| (8, 8.5);
			\node[circ](N1) at (8, 8.5){} node[anchor=south] at (N1.text){$V_o$};
			\node[circ] at (8, 8){};
			\node[circ] at (8, 6){};
			\draw (8, 6) -- (7, 6);
			\node[flowarrow, xscale=-1, yscale=-1](N2) at (7, 6){} node[anchor=east] at ([xshift=-0.3cm]N2.text){$v_{sense}$};
		\end{tikzpicture}
		\caption{Bloque de escalado.}
		\label{fig:escalado}
	\end{figure}
	
	Se eligen dos resistores de valor $R_{1-2} = \SI{56}{\kilo\ohm}$ y otro de valor $R_3 = \SI{10}{\kilo\ohm}$:
	
	\begin{equation}
		escalado = \frac{R_3}{R_1 // R_2 + R_3} = 0.263
	\end{equation}
\subsubsection{Alimentación del lazo y tensión de referencia}
	Para el correcto funcionamiento del lazo, se busca que su tensión de alimentación sea independiente de la entrada $V_{E}$, por dos motivos: para proteger los comparadores y amplificadores de sobretensión, y para reducir el ruido del lazo. Asimismo, y con el objetivo de aumentar al máximo la excursión simétrica, se fija la tensión de referencia en la mitad de la tensión de alimentación.
	
	En la figura \ref{fig:regulador_431} puede verse el circuito de alimentación del lazo realimentador. Se implementa mediante el uso de un regulador ajustable \textbf{TL431} con el agregado de un transistor como fuente de corriente.
	
	Se busca, por limitación de los comparadores y amplificadores elegidos, una tensión de alimentación de \SI{5}{V}, y por ende una tensión de referencia de \SI{2.5}{V}
	
	\begin{figure}[H]
	\centering
	\begin{tikzpicture}[transform shape]
		% Paths, nodes and wires:
		\draw (6, 4.75) to[empty Schottky diode, l={$TL431$}] (6, 7.25);
		\draw (6, 8.25) to[american resistor, /tikz/circuitikz/bipoles/length=0.840cm, l={$R_1$}] (6, 9.75);
		\draw (8, 6) to[american resistor, /tikz/circuitikz/bipoles/length=0.840cm, l={$R_2$}] (8, 7.5);
		\draw (8, 4.5) to[american resistor, /tikz/circuitikz/bipoles/length=0.840cm, l={$R_3$}] (8, 6);
		\draw (10, 6) to[american resistor, /tikz/circuitikz/bipoles/length=0.840cm, l={$R_4$}] (10, 7.5);
		\draw (10, 4.5) to[american resistor, /tikz/circuitikz/bipoles/length=0.840cm, l={$R_5$}] (10, 6);
		\node[npn](N1) at (8, 8.27){} node[anchor=west] at (N1.text){$Q_1$};
		\draw (8, 9.04) -| (8, 10) |- (6, 10);
		\draw (6, 9.75) -| (6, 10);
		\draw (6, 8.25) -| (6, 7);
		\draw (7.16, 8.27) -| (6, 8.25);
		\draw (8, 7.5) -- (10, 7.5);
		\draw (10, 4.5) -- (6, 4.5);
		\draw (6, 4.5) -| (6, 4.75);
		\draw (8, 6) |- (6.25, 6);
		\draw (10, 6) -- (11, 6);
		\node[circ] at (6, 8.25){};
		\node[circ] at (8, 6){};
		\node[circ] at (10, 6){};
		\node[circ] at (8, 7.5){};
		\node[circ] at (8, 4.5){};
		\node[rground, xscale=-1, yscale=-1](N2) at (7, 10){} node[anchor=south] at ([yshift=0.32cm]N2.text){$V_E$};
		\node[circ](N3) at (11, 6){} node[anchor=west] at (N3.text){$V_{med}$};
		\draw (10, 7.5) -- (11, 7.5);
		\node[circ] at (10, 7.5){};
		\node[circ](N4) at (11, 7.5){} node[anchor=west] at (N4.text){$V_{5V}$};
		\node[tlground] at (8, 4){};
		\draw (8, 4) -| (8, 4.5);
		\node[circ] at (7, 10){};
	\end{tikzpicture}
	\caption{Esquemático de circuito de alimentación del lazo realimentador.}
	\label{fig:regulador_431}
\end{figure}
	
	El resistor $R_1$ es el responsable de suministrar corriente al integrado. Se debe asegurar que provea al menos \SI{1}{mA} para todo el rango de operación de la fuente. Para asegurar no desperdiciar energía, se fija un valor lo más alto posible:
	
	\begin{equation}
		I_{TL} = \frac{V_E - (V_{5V} + vbe_{on})}{R_1} = \frac{\SI{12}{V} - (\SI{5}{V} + \SI{0.7}{V})}{R_1} \to R_1 \approx \SI{5.6}{\kilo\ohm}.
	\end{equation}
	Y de este modo se asegura que, para tensiones de entrada más altas, no se superen los \SI{100}{mA}, la corriente admitida máxima.
	
	Las resistencias $R_{2-5}$ se fijan en \SI{10}{\kilo\ohm}. Su objetivo será fijar las tensiones de referencia para asegurar $V_{5V} = 5V$ y $V_{med} = 2,5V$. Su valor no debe ser demasiado chico para reducir el consumo pasivo, pero tampoco demasiado grande como para ser afectado fácilmente por el ruido electromagnético.
	
	Notar que $R_4$ y $R_5$ actúan de forma efectiva como divisor de tensión, pues la salida será la entrada de amplificadores y comparadores, de alta impedancia.
	
	\subsubsection{Generador de señal triangular}
	
	Para la generación de la señal triangular, se utiliza un comparador con histéresis en serie con un integrador. El circuito completo se muestra en la figura \ref{fig:triag}.
	
		\begin{figure}[H]
		\centering
		\begin{tikzpicture}[transform shape]
			% Paths, nodes and wires:
			\node[op amp](N1) at (9.19, 6.49){} node[anchor=center] at (N1.text){$TL082$};
			\node[op amp, yscale=-1](N2) at (14.19, 6.49){} node[anchor=center] at (N2.text){$LM319$};
			\draw (16.5, 8) to[american resistor, /tikz/circuitikz/bipoles/length=0.980cm, l={$R_{pu}$}] (16.5, 6.5);
			\draw (13, 6.98) to[american resistor, /tikz/circuitikz/bipoles/length=0.980cm, l_={$R_1$}] (11, 7);
			\draw (15.5, 8.5) to[american resistor, /tikz/circuitikz/bipoles/length=0.980cm, l={$R_2$}] (13, 8.5);
			\draw (13.5, 10) to[american resistor, /tikz/circuitikz/bipoles/length=0.980cm, l={$R_C$}] (12, 10);
			\draw (13, 7) -| (13, 8.5) -- (13.25, 8.5);
			\draw (15.38, 6.49) -| (17.5, 10) -- (13.5, 10);
			\draw (8, 8.25) to[capacitor, /tikz/circuitikz/bipoles/length=1.12cm, l={$C$}] (10, 8.25);
			\draw (10, 8.25) -| (11, 7);
			\draw (7, 8.25) -| (7, 10) -- (12, 10);
			\node[circ] at (11, 7){};
			\node[circ] at (7, 8.25){};
			\draw (8, 6.98) -| (7, 8.25);
			\draw (7, 8.25) -- (8, 8.25);
			\draw (15.5, 8.5) -| (15.5, 6.5);
			\draw (10.38, 6.49) -| (11, 7);
			\node[circ] at (13, 7){};
			\node[circ] at (15.5, 6.5){};
			\node[rground, xscale=-1, yscale=-1](N3) at (9.107, 7.029){} node[anchor=south] at ([yshift=0.33cm]N3.text){$V_{5V}$};
			\node[ground] at (9.107, 5.951){};
			\node[ground] at (14.107, 5.951){};
			\node[rground, xscale=-1, yscale=-1](N4) at (14.107, 7.029){} node[anchor=south] at ([yshift=0.33cm]N4.text){$V_{5V}$};
			\node[circ](N5) at (8, 6){} node[anchor=east] at (N5.text){$V_{med}$};
			\node[circ](N6) at (13, 6){} node[anchor=east] at (N6.text){$V_{med}$};
			\node[circ](N7) at (11.75, 8.25){} node[anchor=west] at (N7.text){$v_{triag}$};
			\node[rground, xscale=-1, yscale=-1](N8) at (16.5, 8){} node[anchor=south] at ([yshift=0.33cm]N8.text){$V_{5V}$};
			\node[circ] at (16.5, 6.5){};
			\draw (11, 8.25) -- (11.75, 8.25);
			\node[circ] at (11, 8.25){};
		\end{tikzpicture}
		\caption{Esquemático del generador de señal triangular.}
		\label{fig:triag}
	\end{figure}
	
	La elección de los integrados \textbf{TL082} y \textbf{LM319} se basa principalmente en la frecuencia de operación objetivo (tabla \ref{tab:spec_buck}), y en su capacidad para operar con fuente simple. Para ello se buscó un slew rate mayor que el requerido para la señal triangular (en este caso, los \SI{20}{V/\micro s} son ideales), y una velocidad de respuesta muy inferior a la requerida para generar la señal cuadrada.
	
	La elección de valores de los componentes de la figura \ref{fig:triag} se hace en base al siguiente criterio:
	
	\begin{itemize}
		\item Los resistores $R_1$ y $R_2$ definen la amplitud de la señal triangular, mediante el ajuste de los puntos de comparación del comparador con histéresis. Del análisis se deduce la siguiente fórmula:
		\begin{equation}
			V_{lim} = v_{med} \cdot \left( 1 \pm \frac{R_1}{R_2} \right)
		\end{equation}
		Teniendo en cuenta los márgenes (Output Voltage Swing) del \textbf{TL082}, la amplitud máxima será de $\approx \SI{2.6}{V}$. Como tal, se fija $R_1 = \SI{33}{\kilo\ohm}$ y $R_2 = \SI{100}{\kilo\ohm}$. La señal triangular se moverá entre los límites $\SI{1.67}{V} < v_{triag} < \SI{3.3}{V}$.
		
		\item La resistencia $R_{pu}$ es necesaria por ser el LM319 \textit{open-collector}. Se fija en $R_{pu} = \SI{1}{\kilo\hertz}$ para no consumir mucha corriente (\SI{5}{mA}), pero no afectar demasiado la carga y descarga de $C$.
		
		\item A continuación debe fijarse la frecuencia de operación. Se fija primero $C = \SI{1}{nF}$, pues es un valor válido para capacitores cerámicos (que funcionan correctamente en el rango $\sim \SI{100}{\kilo\hertz}$).
		
		Analizando la expresión característica de un amplificador integrador, se obtiene que los tiempos de crecimiento y decrecimiento están determinados por:
		\begin{equation}
			\Delta t_c = 2 \cdot \frac{R1}{R2} \cdot (R_C + R_{pu}) \cdot C
		\end{equation}
		\begin{equation}
			\Delta t_d = 2 \cdot \frac{R1}{R2} \cdot R_C \cdot C
		\end{equation}
		
		Se busca una frecuencia de operación de $\sim \SI{130}{\kilo\hertz} \to T = \Delta t_c + \Delta t_d \sim \SI{7.7}{\micro s}$.
		Se fija $R_{C} = \SI{4.7}{\kilo\ohm}$.
		
		\begin{equation}
			t_c = \SI{4.35}{\micro s}, \qquad \Delta t_d = \SI{3.7}{\micro s} \to f_s =\approx \SI{124}{\kilo\hertz}
		\end{equation}
		
		\textit{Observación:} el hecho de que la frecuencia no sea exactamente triangular no afecta de ninguna manera la generación de la señal PWM, solo alterará el movimiento de su fase.
		\textit{Observación:} La salida del generador de señal triangular deberá ser de alta impedancia.
	\end{itemize}
	
	\subsubsection{Amplificador de error y comparador PWM}
	
	Una vez diseñados los bloques que generan la señal triangular, la señal de sensado y la señal de referencia, se las deberá comparar para obtener una señal PWM modulada. Se colocan en serie un amplificador inversor, para amplificar el error al rango de la señal triangular, y luego se compara la salida con la señal triangular. El circuito final se ve en la figura \ref{fig:amp_error}.
	
	\begin{figure}[H]
		\centering
		\begin{tikzpicture}[transform shape]
			% Paths, nodes and wires:
			\node[op amp](N1) at (7.81, 8){} node[anchor=center] at (N1.text){$TL082$};
			\draw (11.5, 9.5) to[american resistor, l={$R_4$}] (14.5, 9.5);
			\draw (11.75, 8) to[american resistor, l={$R_3$}] (9, 8);
			\node[op amp, yscale=-1](N2) at (12.94, 7.51){} node[anchor=center] at (N2.text){$LM319$};
			\draw (6.5, 10) to[american resistor, l={$R_2$}] (9.25, 10);
			\draw (6.5, 8.5) to[american resistor, l={$R_1$}] (3.75, 8.5);
			\draw (11.5, 9.5) -| (11.5, 8);
			\draw (14.13, 7.51) -| (14.5, 9.5);
			\draw (14.5, 7.51) -| (16, 7.5);
			\draw (9.25, 10) -- (9.25, 8);
			\draw (6.5, 10) |- (6.62, 8.49);
			\node[circ] at (11.5, 8){};
			\node[circ] at (14.5, 7.5){};
			\node[circ] at (9.25, 8){};
			\node[circ] at (6.5, 8.49){};
			\node[circ](N3) at (16, 7.5){} node[anchor=west] at ([xshift=-0.02cm]N3.text){$PWM$};
			\node[inputarrow](N4) at (6.62, 7.51){} node[anchor=east] at ([xshift=-0.07cm]N4.text){$v_{med}$};
			\node[inputarrow](N5) at (3, 8.5){} node[anchor=east] at ([xshift=-0.09cm]N5.text){$v_{sense}$};
			\node[inputarrow](N6) at (11.75, 7.02){} node[anchor=east] at ([xshift=-0.07cm]N6.text){$v_{triag}$};
			\node[ground] at (7.727, 7.461){};
			\node[ground] at (12.857, 6.971){};
			\node[rground, xscale=-1, yscale=-1](N7) at (7.727, 8.539){} node[anchor=south] at ([yshift=0.32cm]N7.text){$V_{5V}$};
			\node[rground, xscale=-1, yscale=-1](N8) at (12.857, 8.049){} node[anchor=south] at ([yshift=0.32cm]N8.text){$V_{5V}$};
			\draw (15.25, 9.5) to[american resistor, l={$R_{pu}$}] (15.25, 7.5);
			\node[rground, xscale=-1, yscale=-1](N9) at (15.25, 9.5){} node[anchor=south] at ([yshift=0.32cm]N9.text){$V_{5V}$};
			\node[circ] at (15.25, 7.5){};
			\draw (3.75, 7) to[empty ZZener diode, /tikz/circuitikz/bipoles/length=0.980cm, l={$D_1$}] (3.75, 8.5);
			\draw (3, 8.5) -- (3.75, 8.5);
			\node[circ] at (3.75, 8.5){};
			\node[tlground] at (3.75, 7){};
		\end{tikzpicture}
		\caption{Esquemático del amplificador de error y comparador PWM.}
		\label{fig:amp_error}
	\end{figure}
	
	La elección de los valores sigue el siguiente criterio:
	\begin{itemize}
		\item Se coloca un diodo Zener con $V_z = \SI{5.2}{V}$ para proteger la entrada de sobrepicos de tensión ocasionados por el transitorio de la fuente switching, para proteger al lazo realimentador.
		
		\item Para el amplificador inversor, se busca que, para el rango de regulación máximo, el valor del error se encuentre justo en el límite del valor pico de la señal triangular. Se fija este rango como $\pm \SI{1}{V}$ respecto del valor de $V_o$ esperado. Para encontrar el valor de $A_v = R_2 / R_1$, se debe evaluar considerando el escalado:
		
		\begin{equation}
			\SI{1.5}{V} \cdot escalado \cdot A_v = \SI{0.8}{V} \to A_v \approx 3.
		\end{equation}
		
		Se fija, con este propósito, $R_1 = \SI{10}{\kilo\ohm}$ y $R_2 = \SI{33}{\kilo\ohm}$.
		
		\item Los resistores del comparador con histéresis cumplen la función de hacer la transición entre estados del PWM limpia, y por lo tanto la histéresis será muy pequeña y tendrá valor $R_3/R_4$. Se fijan valores $R_3 = \SI{1}{\kilo\ohm}$ y $R_4 = \SI{10}{\kilo\ohm}$ para una histéresis del 10\%. Debido a que el error estacionario debe ser 0, su valor no afecta en gran medida al consumo pasivo de corriente.
		
		\item El valor del resistor $R_{pu}$ se fija en $R_{pu} = \SI{10}{\kilo\ohm}$. De este modo la corriente de consumo pasivo será $\sim \SI{500}{\micro\ampere}$. Dado que la entrada del gate driver es de alta impedancia, este valor no es crítico para el funcionamiento.
	\end{itemize}
	
	\subsection{Elección y diseño del \textit{Gate Driver}}
	Para el manejo de los transistores de conmutación, se utiliza un \textit{gate driver} que asegure la conmutación de la fuente de forma segura. Dado que se trata de una fuente sincrónica, además de implementar un control por \textit{High-Side}, deberá tenerse en cuenta el tiempo muerto.
	
	Por simplicidad, se elige el driver \textbf{IR2111}. Este módulo tiene integrado ambos controles (\textit{High-Side} y \textit{Low-Side}), además del control del tiempo muerto.
	
	El circuito de control tiene la forma de la figura \ref{fig:gatedriver}.
	
	\begin{figure}[H]
		\centering
		\begin{tikzpicture}[transform shape]
			% Paths, nodes and wires:
			\draw (8.5, 11) to[full Schottky diode, /tikz/circuitikz/bipoles/length=0.840cm, l={$D$}] (11, 11);
			\node[shape=rectangle, draw, line width=1pt, minimum width=1.465cm, minimum height=1.965cm] at (9.75, 9.25){};
			\draw (11.75, 11) to[capacitor, /tikz/circuitikz/bipoles/length=0.840cm, l={$C$}] (11.75, 9);
			\draw (11, 11) -- (11.75, 11);
			\draw (10.5, 10) -| (11, 11);
			\draw (10.5, 8.5) -- (12.5, 8.5);
			\draw (10.5, 9) -- (11.75, 9) -- (12.5, 9);
			\draw (10.5, 9.5) -- (12.5, 9.5);
			\node[circ] at (11, 11){};
			\node[circ] at (11.75, 9){};
			\draw (8.5, 11) -| (8.5, 9.75) -- (9, 9.75);
			\draw (9, 9) -- (7.75, 9);
			\draw (9, 8.5) -- (8.5, 8.5) -| (8.5, 8.25);
			\node[tlground] at (8.5, 8.25){};
			\node[trarrow](N1) at (7.638, 9){} node[anchor=east] at (N1.text){$PWM$};
			\node[trarrow](N2) at (12.5, 8.5){} node[anchor=west] at (N2.text){$L_{ctrl}$};
			\node[trarrow](N3) at (12.5, 9){} node[anchor=west] at (N3.text){$V_s$};
			\node[trarrow](N4) at (12.5, 9.5){} node[anchor=west] at (N4.text){$H_{ctrl}$};
			\node[shape=rectangle, minimum width=0.34cm, minimum height=0.34cm] at (9.063, 9.75){} node[anchor=center, align=center, text width=-0.048cm, inner sep=6pt] at (9.063, 9.75){\small $V_{cc}$};
			\node[shape=rectangle, minimum width=0.34cm, minimum height=0.34cm] at (9.062, 8.5){} node[anchor=center, align=center, text width=-0.048cm, inner sep=6pt] at (9.062, 8.5){\small GND};
			\node[shape=rectangle, minimum width=0.402cm, minimum height=0.34cm] at (9.125, 9){} node[anchor=center, align=center, text width=0.014cm, inner sep=6pt] at (9.125, 9){\small IN};
			\node[shape=rectangle, minimum width=0.34cm, minimum height=0.34cm] at (10, 9.937){} node[anchor=center, align=center, text width=-0.048cm, inner sep=6pt] at (10, 9.937){\small $V_B$};
			\node[shape=rectangle, minimum width=0.34cm, minimum height=0.34cm] at (10, 9.437){} node[anchor=center, align=center, text width=-0.048cm, inner sep=6pt] at (10, 9.437){\small $H_o$};
			\node[shape=rectangle, minimum width=0.34cm, minimum height=0.34cm] at (10, 8.5){} node[anchor=center, align=center, text width=-0.048cm, inner sep=6pt] at (10, 8.5){\small $L_o$};
			\node[shape=rectangle, minimum width=0.34cm, minimum height=0.34cm] at (10, 9){} node[anchor=center, align=center, text width=-0.048cm, inner sep=6pt] at (10, 9){\small $V_s$};
			\node[shape=rectangle, minimum width=1.59cm, minimum height=0.527cm] at (9.625, 8.031){} node[anchor=north west, align=left, text width=1.202cm, inner sep=6pt] at (8.813, 8.312){IR2111};
		\end{tikzpicture}
		\caption{Esquemático del \textit{gate-driver}.}
		\label{fig:gatedriver}
	\end{figure}
	
	\subsection{Simulaciones del lazo de realimentación}
	
	Se realizan diferentes simulaciones sobre el archivo de la figura \ref{fig:sim_pwm}. Será de interés la triangular resultante, la señal pwm generada y su interacción con el valor medido. Para la medición a lazo abierto, se simula una entrada senoidal de valor medio \SI{9.5}{V}, con una amplitud de \SI{1.5}{V}.
	
	La señal triangular resultante puede verse en la figura \ref{fig:sim_triag}, y su interacción con la señal de salida PWM puede verse en la figura \ref{fig:sim_pwm2}.
	
		\begin{figure}[H]
		\centering
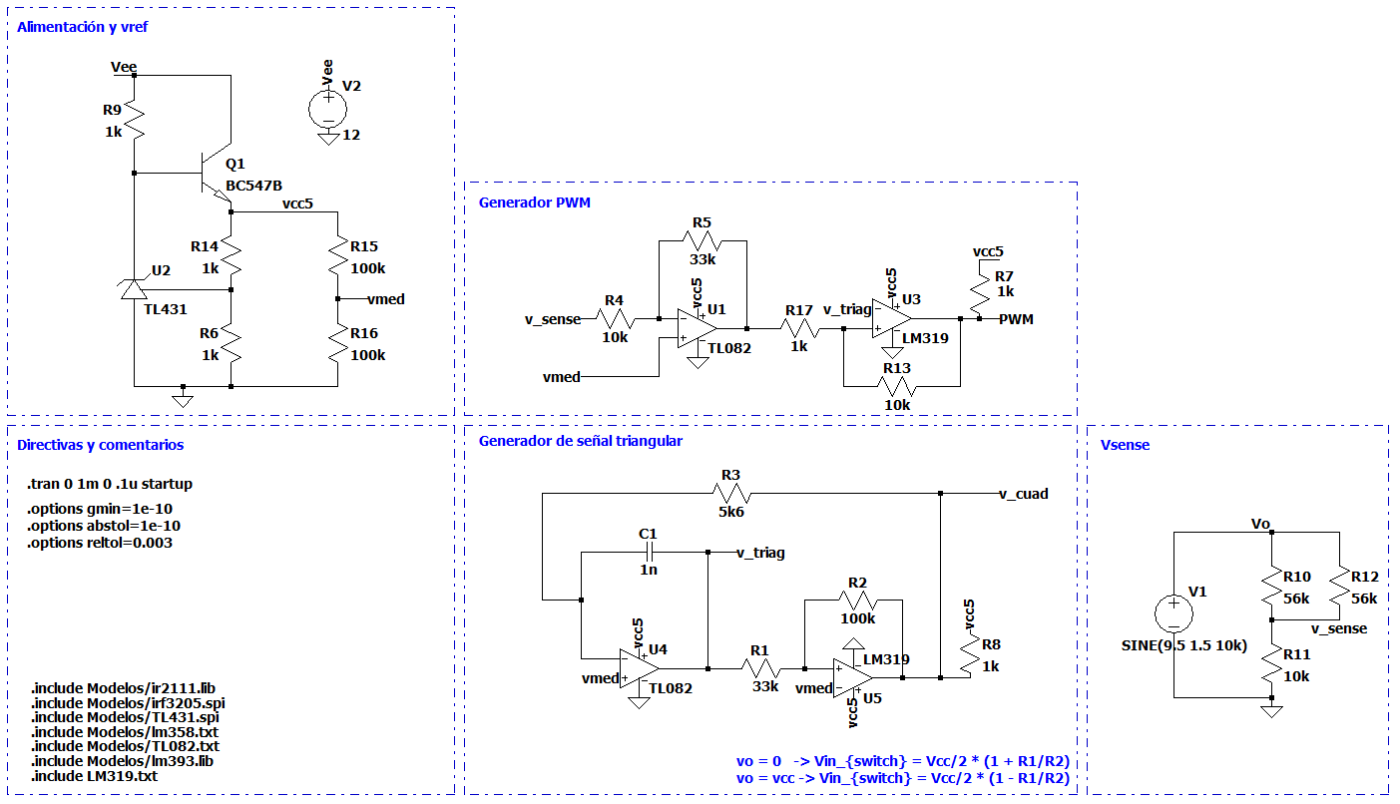
[picture p7: Checkpoints/Checkpoint 4/Informe CHK 4/img/BUCK/simulacion_pwm_lazo_abierto.png]
		
		\caption{Archivo de simulación del circuito PWM a lazo abierto.}
		\label{fig:sim_pwm}
	\end{figure}
	
	\begin{figure}[H]
		\centering
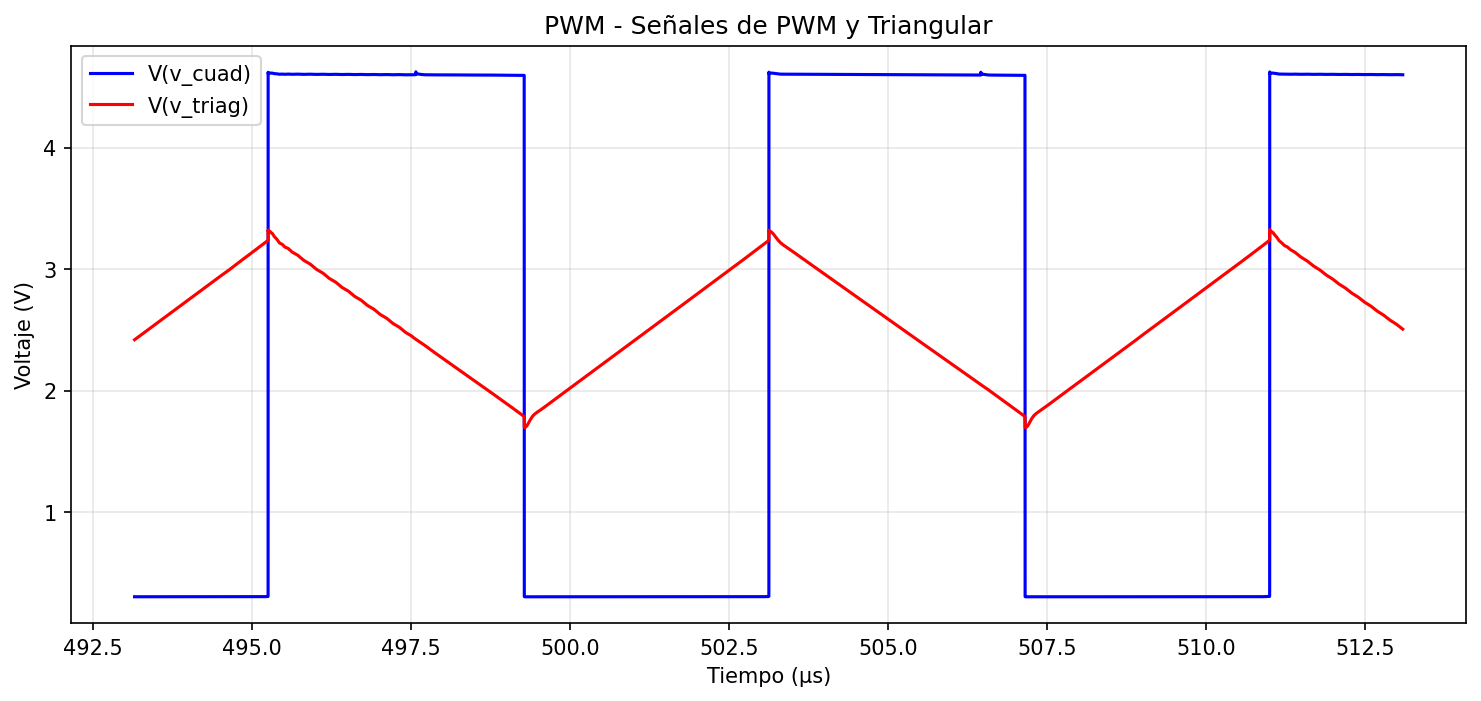
[picture p8: Simulación/BUCK/Datos/grafico_pwm.png]
		
		\caption{Señal triangular simulada.}
		\label{fig:sim_triag}
	\end{figure}
	
		\begin{figure}[H]
		\centering
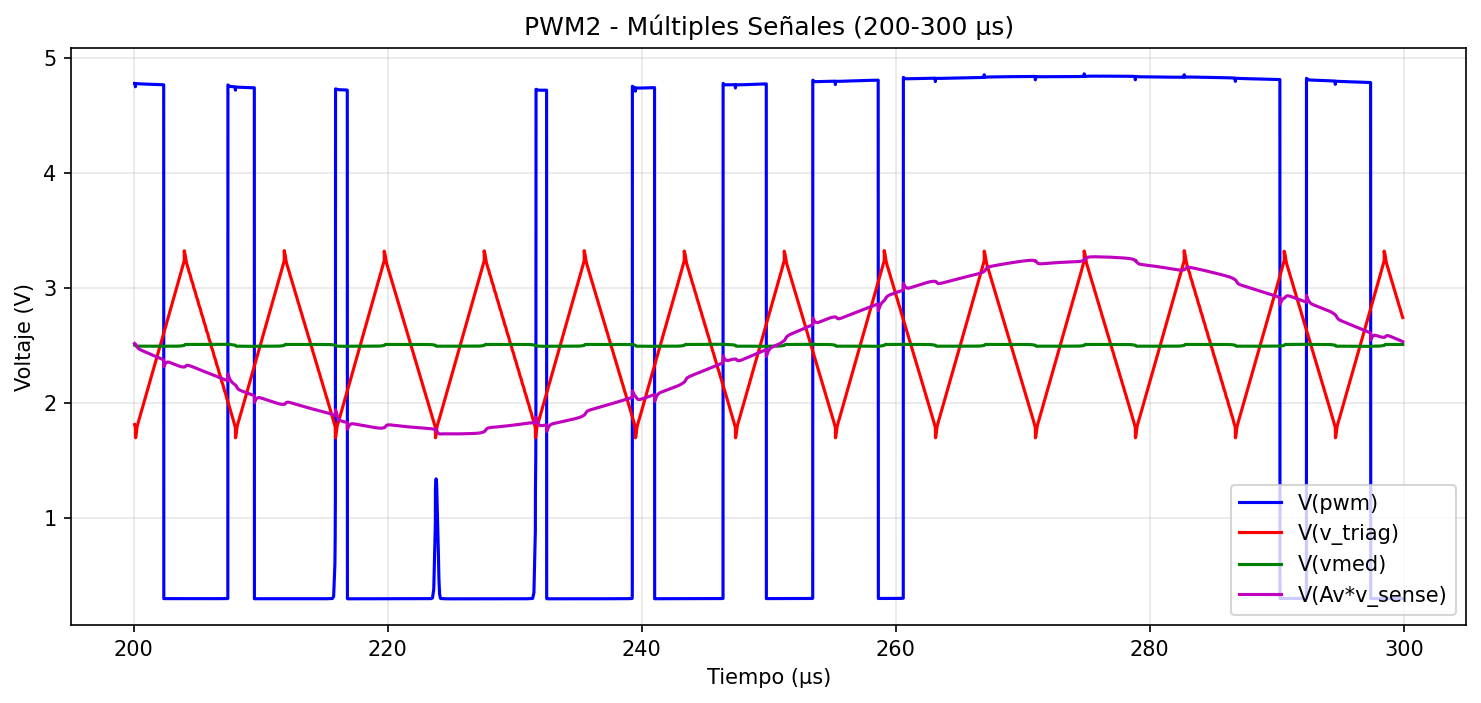
[picture p9: Simulación/BUCK/Datos/grafico_pwm2.png]
		
		\caption{Señal PWM resultante.}
		\label{fig:sim_pwm2}
	\end{figure}
	
	Se observa que el comportamiento es coherente con los resultados calculados, con la salvedad de la frecuencia de oscilación, que es un poco más alta $f_s = \SI{128}{\kilo\hertz}$.
	\subsection{Implementación de circuito PWM (PCB)}

	Se implementa el circuito en placa impresa. Notar que se deja espacio para el cálculo e implementación de la compensación del lazo realimentador (ver $C_4$ y $C_2$ en la figura \ref{sec:apendice_PCB}), para el futuro cierre del lazo. Se realizo un diseño simple faz a modo prototipo con ciertas conexiones cableadas en la capa superior y \textit{jumpers} para testeo como se aprecia en la figura \ref{fig:pwmpcb}, luego se implemento mediante transferencia térmica y corrosión de cobre sobrante de la placa con el uso de percloruro férrico obteniendo la placa Fig. \ref{fig:pcbpwmplaca}.
		
	\begin{figure}[H]
		\centering
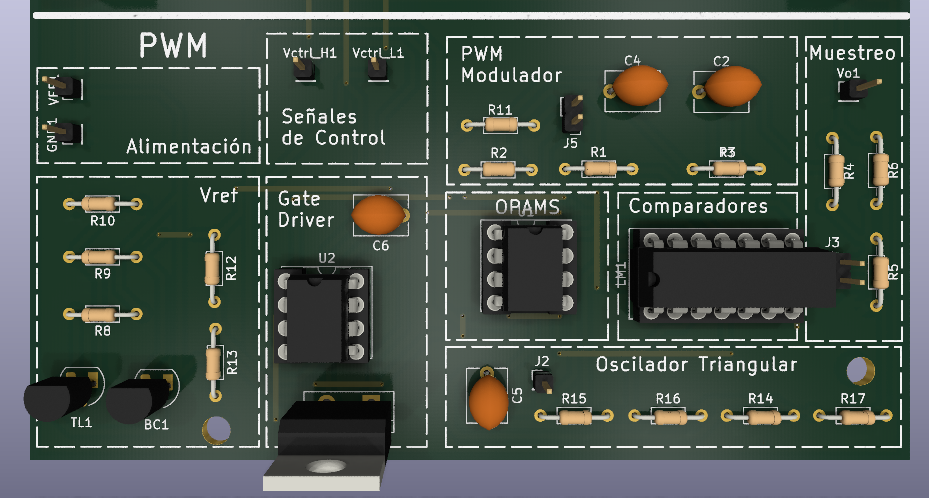
[picture p10: Checkpoints/Checkpoint 4/Informe CHK 4/img/buck/pwm_pcb.png]
		
		\caption{Modelo 3D del PWM en circuito impreso.}
		\label{fig:pwmpcb}
	\end{figure}
	
	\begin{figure}[H]
		\centering
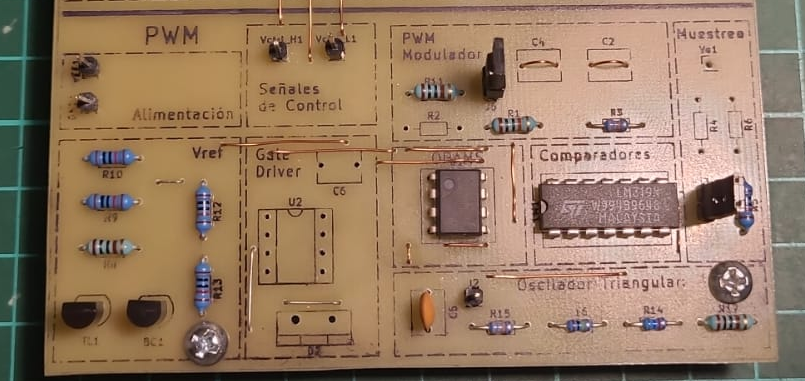
[picture p11: Checkpoints/Checkpoint 4/Informe CHK 4/img/buck/pcb_pwm_placa.png]
		
		\caption{Placa terminada y montada.}
		\label{fig:pcbpwmplaca}
	\end{figure}

	\subsubsection{Mediciones de la placa}

	Ya en el laboratorio se verifica el funcionamiento del PWM, alimentando el circuito con fuentes de laboratorio y utilizando un osciloscopio para observar y medir la señal como se puede ver en la figura \ref{fig:bancopruebaspwm}. Para verificar la modulación del ancho de pulso se coloco una fuente a la terminal de muestreo y se vario la tensión levemente.
	
	\begin{figure}[H]
		\centering
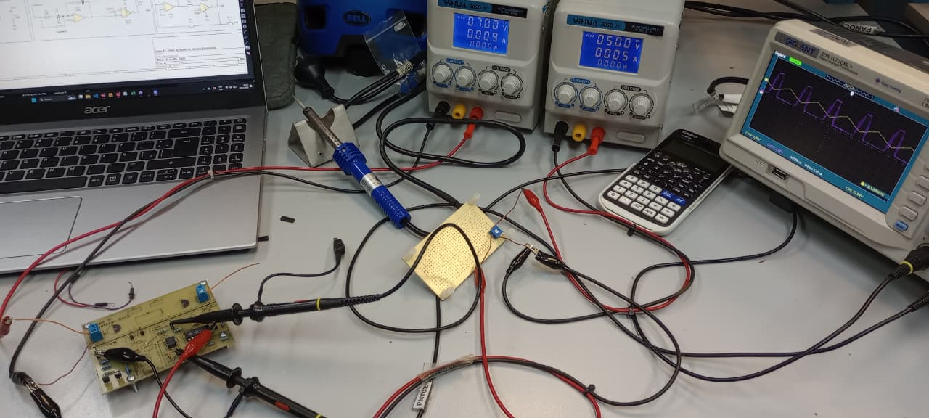
[picture p12: Checkpoints/Checkpoint 4/Informe CHK 4/img/buck/banco_pruebas_pwm.png]
		
		\caption{Banco de pruebas.}
		\label{fig:bancopruebaspwm}
	\end{figure}

	Se puede observar la señal triangular y el pulso modulado en la figura \ref{fig:capturasoscpwm}
	
	\begin{figure}[H]
		\centering
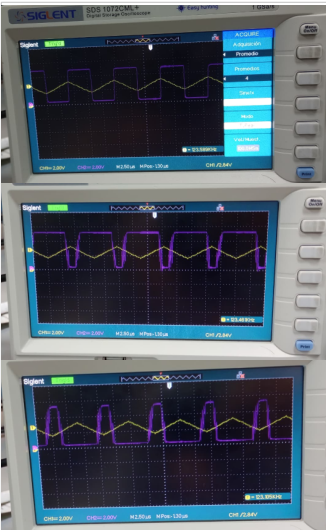
[picture p13: Checkpoints/Checkpoint 4/Informe CHK 4/img/buck/capturas_osc_pwm.png]
		
		\caption{Capturas del osciloscopio midiendo el pulso modulado y la señal triangular del oscilador.}
		\label{fig:capturasoscpwm}
	\end{figure}
	
	Notar que, según el esquemático de la imagen \ref{sec:apendice_PCB}, el comparador con histéresis de la imagen \ref{fig:amp_error} no se encuentra implementado. Esto hace el flanco de conmutación muy ruidoso, debido a la naturaleza también ruidosa de la señal de entrada $v_{sense}$.
		
	\subsection{Características físicas del inductor diseñado}
	
Especificaciones:

\begin{itemize}
	\item $L = \SI{50}{\micro\henry}$: Inductancia requerida.
	\item $I_{L,\mathrm{DC}} = \SI{750}{\milli\ampere}$: Corriente media del inductor.
	\item $f_{SW} = \SI{140}{\kilo\hertz}$: Frecuencia de conmutación.
	\item $I_{L,\mathrm{MAX}} = \SI{1.5}{\ampere}$: Corriente máxima del inductor.
	\item $P_{CU,\mathrm{MAX}} = \SI{1}{\watt}$: Pérdidas máximas permitidas en el cobre.
\end{itemize}

A partir de las especificaciones del diseño, se utilizaron los métodos de Erickson y Tacca para el dimensionamiento del inductor. Para ello, se desarrolló un código en Python que permite obtener parámetros de diseño tales como:

\begin{itemize}
	\item Material del núcleo.
	\item Tipo de núcleo.
	\item Entrehierro necesario.
	\item Número de vueltas.
	\item Tipo de alambre.
\end{itemize}

El método implementado se encuentra limitado al uso de núcleos del tipo EE. Sin embargo, también es posible realizar diseños utilizando otros tipos de núcleos, como toroides o solenoides, mediante procedimientos de cálculo equivalentes.

\subsection*{Método de Erickson}

El procedimiento de diseño empleado consta de las siguientes etapas:

\begin{enumerate}
	
	\item Cálculo de la resistencia máxima admisible del conductor:
	$R_{cu,\mathrm{max}}$ [$\si{\ohm}$].
	\begin{align*}
		\boxed{R_{cu,\mathrm{max}} = \SI{1.77}{\ohm}}
	\end{align*}
	
	\item Selección del material del núcleo en función de la frecuencia de conmutación.
	
	Dado que la frecuencia de conmutación es
	\begin{align*}
		f_{SW} = \SI{140}{\kilo\hertz}
	\end{align*}
	
	se selecciona un material de ferrita tipo N87, adecuado para aplicaciones de electrónica de potencia en este rango de frecuencias.
	\begin{align*}
		\boxed{\text{Material} = \mathrm{N87}}
	\end{align*}
	
	\item Cálculo de la constante geométrica mínima requerida del núcleo:
	$K_g$ [$\si{\centi\meter^5}$].
	\begin{align*}
		\boxed{K_{g,\mathrm{min}} = \SI{0.0183e-3}{\centi\meter^5}}
	\end{align*}
	
	Se selecciona un núcleo tipo EE16, cuya constante geométrica satisface la condición requerida:
	\begin{align*}
		\boxed{\text{Tipo de núcleo} = \mathrm{EE16}}
		\qquad
		\boxed{K_g = \SI{2.02e-3}{\centi\meter^5}}
	\end{align*}
	
	\begin{figure}[H]
		\centering
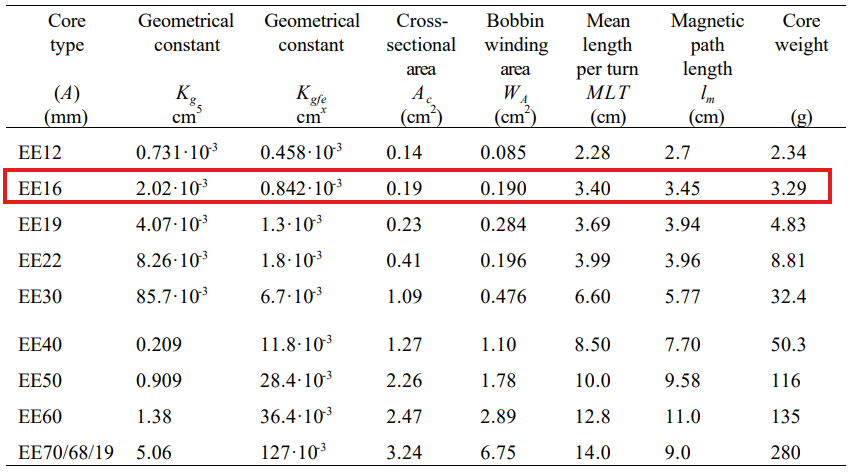
[picture p14: Checkpoints/Checkpoint 4/Informe CHK 4/img/diseño_inductor/tipos-de-nucleos.png]
		
		\caption{Tipos de núcleos}
		\label{fig:tipos-de-nucleo}
	\end{figure}
	
	\item Cálculo del entrehierro requerido:
	$l_g$ [$\si{\meter}$].
	\begin{align*}
		\boxed{l_g = \SI{8.267e-5}{\meter}}
	\end{align*}
	
	\item Cálculo del número de vueltas.
	\begin{align*}
		\boxed{n_l = 13.15 \approx 13}
	\end{align*}
	
	\item Cálculo de la sección máxima permitida para el conductor:
	$A_w$ [$\si{\centi\meter^2}$].
	\begin{align*}
		\boxed{A_{w,\mathrm{max}} = \SI{4.82e-3}{\centi\meter^2}}
	\end{align*}
	
	Se selecciona un conductor AWG20, cuya sección transversal cumple con el requisito establecido:
	\begin{align*}
		\boxed{\text{Tipo de alambre} = \mathrm{AWG20}}
		\qquad
		\boxed{A_w = \SI{3.243e-3}{\centi\meter^2}}
	\end{align*}
	
	\begin{figure}[H]
		\centering
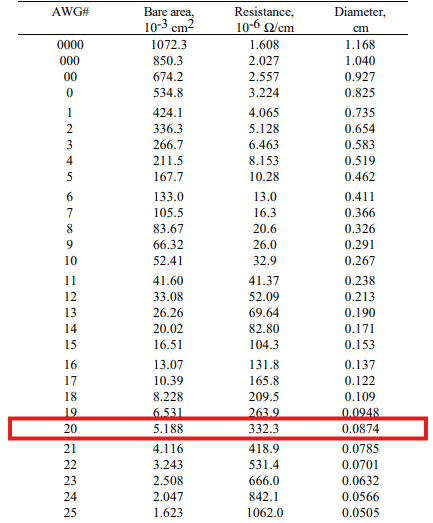
[picture p15: Checkpoints/Checkpoint 4/Informe CHK 4/img/diseño_inductor/tipos-de-alambre.png]
		
		\caption{Tipos de alambre de cobre}
		\label{fig:tipos-de-alambre}
	\end{figure}
	
	\item Verificación de la resistencia del conductor.
	\begin{align*}
		\boxed{
			R_{cu} = \SI{0.0234}{\ohm}
			<
			R_{cu,\mathrm{max}} = \SI{1.77}{\ohm}
		}
	\end{align*}
	
	Por lo tanto, la condición de pérdidas en cobre se satisface.
	
	\item Verificación de la densidad de corriente.
	\begin{align*}
		\boxed{
			\sigma_{I_L}
			=
			\SI{4.625}{\ampere\per\milli\meter^2}
			<
			\sigma_{I_{L,\mathrm{max}}}
			=
			\SI{5}{\ampere\per\milli\meter^2}
		}
	\end{align*}
	
	Por lo tanto, la densidad de corriente se encuentra dentro de los límites admisibles.
	
	\item Verificación de saturación del núcleo.
	\begin{align*}
		\boxed{B = \SI{0.31}{\milli\tesla} < B_{\max} = \SI{300}{\milli\tesla}}
	\end{align*}
	
	El núcleo elegido no entra en saturación. Cumple esta condición.
	
	\item Verificación del efecto pelicular.
	\begin{align*}
		\boxed{\delta = \SI{0.02}{\centi\meter}}
		\qquad
		\boxed{\dfrac{d_{AWG20}}{2} = \SI{0.035}{\centi\meter}}
	\end{align*}
	
	Dado que
	\[
	\delta < \frac{d_{AWG20}}{2}
	\]
	
	el efecto pelicular no puede despreciarse para el conductor seleccionado.
	
\end{enumerate}

Resumiendo, el diseño del inductor nos queda de la siguiente forma:

\begin{table}[H]
	\centering
	\renewcommand{\arraystretch}{1.3}
	\begin{tabular}{|l|c|}
		\hline
		\multicolumn{2}{|c|}{\textbf{Diseño del Inductor}} \\
		\hline
		\textbf{Parámetro} & \textbf{Valor} \\
		\hline
		Tipo de material & N87 \\
		\hline
		Tipo de núcleo & EE16 \\
		\hline
		Entrehierro (gap) & $l_g=\SI{0.082}{\milli\meter}$ \\
		\hline
		Número de vueltas & $n_l=13$ \\
		\hline
		Tipo de alambre & AWG\#20 \\
		\hline
	\end{tabular}
	\caption{Parámetros de diseño del inductor de $L=\SI{50}{\micro\henry}$}
	\label{tab:diseno_inductor}
\end{table}

\begin{table}[H]
	\centering
	\renewcommand{\arraystretch}{1.3}
	\begin{tabular}{|p{4cm}|p{4cm}|p{3cm}|c|}
		\hline
		\textbf{Verificación} &
		\textbf{Valores} &
		\textbf{Condición} &
		\textbf{Resultado} \\
		\hline
		
		Resistencia del cobre &
		$R_{CU}=\SI{0.023}{\ohm}$
		
		$R_{CU,\max}=\SI{1.77}{\ohm}$ &
		$R_{CU}<R_{CU,\max}$ &
		Cumple \\
		\hline
		
		Densidad de corriente &
		$\Sigma_{I_L}=\SI{4.62}{\ampere\per\milli\meter^2}$
		
		$\Sigma_{I_{L,\max}}=\SI{5}{\ampere\per\milli\meter^2}$ &
		$\Sigma_{I_L}<\Sigma_{I_{L,\max}}$ &
		Cumple \\
		\hline
		
		Saturación del núcleo &
		$B=\SI{0.31}{\milli\tesla}$
		
		$B_{\max}=\SI{300}{\milli\tesla}$ &
		$B<B_{\max}$ &
		Cumple \\
		\hline
		
		Efecto pelicular &
		$\delta=\SI{0.02}{\centi\meter}$
		
		$\dfrac{d_{AWG20}}{2}=\SI{0.035}{\centi\meter}$ &
		$\delta>\dfrac{d}{2}$ &
		No cumple \\
		\hline
		
	\end{tabular}
	\caption{Verificaciones de diseño del inductor}
	\label{tab:verificaciones_inductor}
\end{table}

Se observa que la última condición no se cumple, por lo que el conductor seleccionado presenta efecto pelicular. Una posible solución consistiría en utilizar un alambre de menor diámetro, de manera que la profundidad de penetración sea mayor que el radio del conductor y el efecto pelicular pueda despreciarse. Sin embargo, al reducir el diámetro del alambre también disminuye su sección transversal, lo que incrementa la densidad de corriente y podría llevar a superar el límite de diseño establecido.

Otra alternativa consiste en emplear un conductor multifilar, compuesto por pequeños hilos de cobre conectadas en paralelo. De esta manera, cada hilo puede cumplir individualmente con la condición de profundidad de penetración, reduciendo las pérdidas asociadas al efecto pelicular sin incrementar significativamente la densidad de corriente total del conductor.

Cabe destacar que los resultados obtenidos corresponden a un diseño teórico o ideal del inductor. En la práctica, el diseño final se encuentra condicionado por la disponibilidad de materiales y componentes en el mercado. Por este motivo, suele ser necesario adaptar los parámetros calculados a los materiales que pueden conseguirse en el mercado.
	
	\subsection{Diseño PCB de la buck en lazo abierto}
	
	Se diseño el circuito \textit{buck} de forma que se pueda utilizar a lazo abierto modularizando la placa, en la figura \ref{fig:bucksolopcb} se puede observar el modelo en tres dimensiones del sector de la placa correspondiente al circuito \textit{buck}. 
	
	\begin{figure}[H]
		\centering
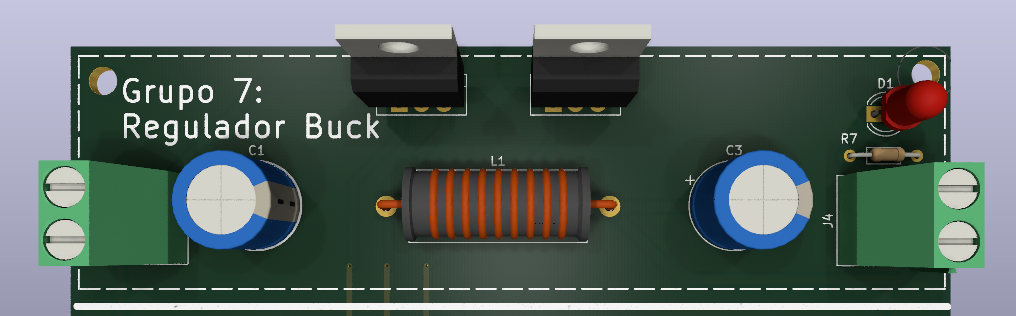
[picture p16: Checkpoints/Checkpoint 4/Informe CHK 4/img/buck/buck_solo_pcb.png]
		
		\caption{Diseño del PCB del circuito buck.}
		\label{fig:bucksolopcb}
	\end{figure}

	\subsection{Diseño PCB Completo}
	
	\begin{figure}[H]
		\centering
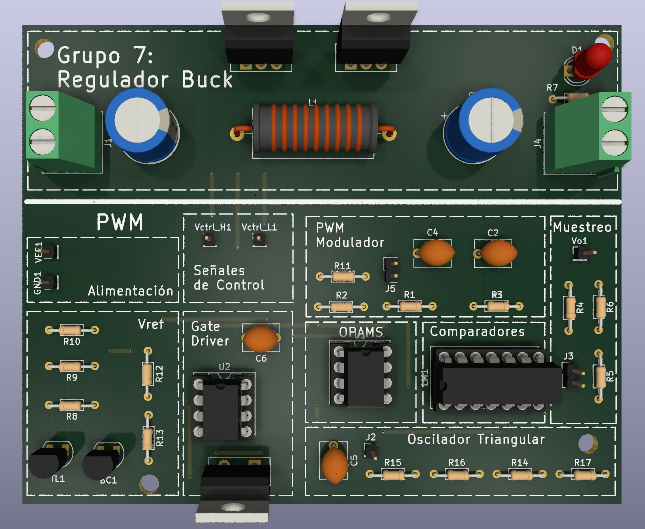
[picture p17: Checkpoints/Checkpoint 4/Informe CHK 4/img/buck/PCB_frente.png]
		
		\caption{}
		\label{fig:pcbfrente}
	\end{figure}

\begin{figure}[H]
	\centering
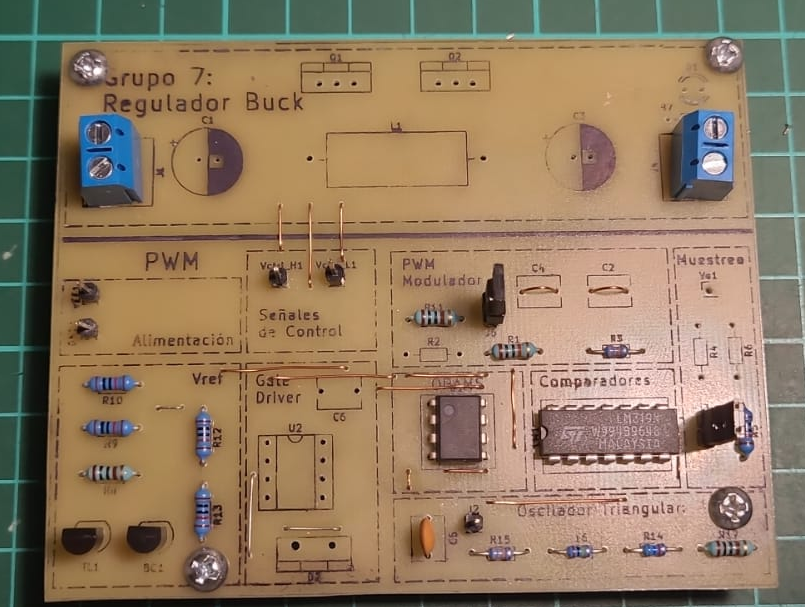
[picture p18: Checkpoints/Checkpoint 4/Informe CHK 4/img/buck/pcb_BUCK.png]
	
	\caption{}
	\label{fig:pcbbuck}
\end{figure}

\begin{table}[H]
	\centering
	\caption{Estadísticas de la PCB}
	\label{tab:estadisticas_pcb}
		
		\begin{tabular}{|l|c|}
		\hline
		\textbf{Parámetro} & \textbf{Valor} \\
		\hline
		
		\multicolumn{2}{|c|}{\textbf{Componentes}} \\
		\hline
		THT & 38 \\
		SMD & 0 \\
		No especificado & 0 \\
		Total de componentes & 38 \\
		\hline
		
		\multicolumn{2}{|c|}{\textbf{Pads}} \\
		\hline
		Agujeros pasantes & 93 \\
		SMD & 0 \\
		Conector & 5 \\
		Total de pads & 93 \\
		\hline
		
		\multicolumn{2}{|c|}{\textbf{Placa}} \\
		\hline
		Dimensiones & $100 \times 80 \,\mathrm{mm}$ \\
		Área & $8000 \,\mathrm{mm}^2$ \\
		Área de cobre frontal & $467.218 \,\mathrm{mm}^2$ \\
		Área de cobre trasera & $6481.32 \,\mathrm{mm}^2$ \\
		Margen mínimo de pista & $1.0 \,\mathrm{mm}$ \\
		Ancho mínimo de pista & $0.2 \,\mathrm{mm}$ \\
		Diámetro mínimo de taladro & $0.7 \,\mathrm{mm}$ \\
		Espesor de la placa & $1.6 \,\mathrm{mm}$ \\
		Área de huellas frontal & $1714.185 \,\mathrm{mm}^2$ \\
		Densidad de huellas frontal & $21.43\%$ \\
		Área de huellas posterior & $313.202 \,\mathrm{mm}^2$ \\
		Densidad de huellas posterior & $3.92\%$ \\
		\hline
	\end{tabular}
	\end{table}

\begin{table}[H]
	\centering
	\caption{Presupuesto estimado de componentes}
	\label{tab:presupuesto_componentes}
	
	\begin{tabular}{|c|l|c|c|}
		\hline
		\textbf{Ítem} & \textbf{Componente} & \textbf{Cantidad} & \textbf{Observaciones} \\
		\hline
		
		1  & BC546                          & 1  & Transistor NPN TO-92 \\
		2  & Capacitor electrolítico 100\,uF & 2  & Radial \\
		3  & Capacitor 10\,uF               & 1  & Cerámico/disco \\
		4  & Capacitor 1\,nF                & 2  & Cerámico \\
		5  & Capacitor 10\,nF               & 1  & Cerámico \\
		6  & LED indicador                  & 1  & 4\,mm \\
		7  & Diodo Schottky MBR735          & 1  & TO-220 \\
		8  & Pin header 1x1                 & 4  & Señales/GND \\
		9  & Bornera 2 vías                 & 2  & Entrada y salida \\
		10 & Inductor 50\,uH                & 1  & Potencia \\
		11 & LM319                          & 2  & Comparador DIP-8 \\
		12 & IRF540N                        & 2  & MOSFET canal N \\
		13 & Resistencia 10\,k$\Omega$      & 3  & 1/4 W \\
		14 & Resistencia 1\,k$\Omega$       & 4  & 1/4 W \\
		15 & Resistencia 33\,k$\Omega$      & 1  & 1/4 W \\
		16 & Resistencia 100\,k$\Omega$     & 3  & 1/4 W \\
		17 & Resistencia 5.6\,k$\Omega$     & 1  & 1/4 W \\
		18 & Resistencia 22\,k$\Omega$      & 1  & 1/4 W \\
		19 & Resistencia 100\,$\Omega$      & 1  & 1/4 W \\
		20 & Resistencia 30\,k$\Omega$      & 1  & 1/4 W \\
		21 & TL082                          & 2  & Amplificador operacional DIP-8 \\
		22 & TL431                          & 1  & Referencia programable \\
		23 & IR2111                         & 1  & Driver half-bridge \\
		\hline
		
		\multicolumn{2}{|r|}{\textbf{Total de componentes}} & \textbf{38} & \\
		\hline
		
	\end{tabular}
\end{table}
	
	\section{Conclusiones}
	
	Se pudo asegurar el funcionamiento del lazo de realimentación, mediante simulaciones y mediciones. Mientras que el funcionamiento de la fuente a lazo abierto se verificó por simulación.
	
	Para el funcionamiento íntegro de la fuente switching, resta la fabricación del bobinado y la compensación del lazo realimentador.
	
	Asimismo, se deben agregar algunas instancias de protección, tanto para la fuente como para la carga, y de este modo asegurar la calidad de la fuente en su estado final.

	{\footnotesize
		\printbibliography
	}

	\newpage
	\appendix

\includepdf[
pages=1,
angle=90,
fitpaper=true,
pagecommand={\section{Apéndice I: PCB}\label{sec:apendice_PCB}\subsection{Esquematico.}}
]{img/buck/esquematico_buck.pdf}

\let\clearpage\relax

\includepdf[
pages=1,
pagecommand={\subsection{Pistas}}
]{img/buck/pistas_buck.pdf}

\end{document}
