Seba-SL/TP-Taller-de-Dise-o-de-Circuitos-Electr-nicos-TA138-/Checkpoints/Checkpoint 4/Informe CHK 4/build/informe.pdf

### Taller de Diseño de Circuitos Electrónicos

TA138

Facultad de Ingeniería Universidad de Buenos Aires

# Diseño de Fuente de Alimentación

Checkpoint 2: Compensación de lazos y análisis térmico.

Alumnos: | Padrón: | Mail:
Lazo, Sebastian Nahuel | 106213 | slazo@.uba.ar
Flores, Ahmed Ali | 106238 | aaores@.uba.ar
Mántaras, Ramiro | 111510 | rmantaras@.uba.ar

Docentes:
Teóricas: Julio Zola | Tutor: Sergio Andres Quinteros

## Índice

1. Objetivo | 2
2. Desarrollo | 2
3. Simulaciones | 15
4. Conclusiones | 23
A. Apéndice I: Simulaciones | 24
B. Apéndice II: Esquemáticos | 25
C. Apéndice III: PCB | 26

Inicio checkpoint 1

## 1. Objetivo

Se propone el diseño e implementación de un sistema electrónico capaz de generar una tensión regulada de 5 V a partir de una fuente de alimentación proveniente de una batería cuya tensión puede variar en un amplio rango comprendido entre 12 V y 30 V. Además de garantizar una salida estable, el sistema debe ser energéticamente eciente, ya que en aplicaciones reales la eciencia de conversión es un aspecto fundamental para reducir pérdidas de potencia, calentamiento y consumo energético.

El diseño resultante tiene como objetivo combinar alta eciencia energética, estabilidad de la tensión de salida y conabilidad operativa, características fundamentales en sistemas de alimentación destinados a cargas como micro-procesadores, sensores y transceptores de comunicación, tanto para aplicaciones automotrices como industriales.

En total, el dispositivo debe contar con las siguientes especicaciones:

Característica | Símbolo | Condiciones de prueba | Min. | Tip. | Max. | Unidades

Especicaciones Generales

Rango de operación tensión de entrada | VIN | | 12 | 24 | 30 | V
VIN UVLO arranque | VIN_UVLO_START | VIN creciendo | | | | V
VIN UVLO apagado | VIN_UVLO_STOP | VIN decreciendo | | | | V
VIN UVLO histéresis | VIN_UVLO_HYST | | | | | V
Corriente de alimentación inactivo | IQ | VIN=12V | | | | mA
| IQ_Sleep | ENABLE=0 | | | | mA

Cuadro 1: Especicaciones Generales.

## 2. Desarrollo

La construcción del dispositivo se divide en dos secciones:

Fuente Switching: Encargada de regular la tensión de forma eciente desde la fuente de energía hacia el regulador lineal.

Regulador Lineal: Sacrica eciencia a cambio de precisión y control. Interactúa de forma directa con la carga.

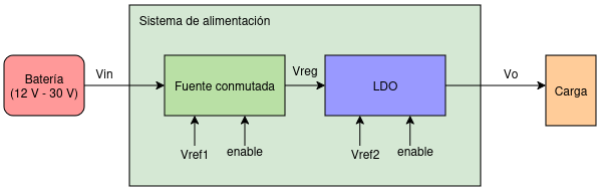
[picture p19: figure]

Figura 1: Esquema general del dispositivo.

2.1. Fuente de alimentación conmutada
2.2. Regulador de baja caída (LDO,Low Dropout Regulator)
2.2.1. Especicaciones e implementación

El propósito de esta etapa es regular la tensión de salida de la fuente conmutada de forma precisa, sacricando la eciencia. Se espera de esta etapa las especicaciones de la tabla 2.

Característica | Símbolo | Condiciones de prueba | Min. | Tip. | Max. | Unidades

Especicaciones regulador lineal Vo

Vo exactitud y re-gulación de carga | Vo | 100 mA < Iout < 1,5 A V REG = 9,5 V | 4,9 | 5 | 5,1 | V
Vo rango de capaci-dad de carga | COUT(Vo) | | 1,0 | 2,2 | 15,0 | µF
Io corriente límite | ILIM(Vo) | | | 1,5 | | A
Corriente de fold-back | IFBK | | | 400 | | mA
Vo startup time | t(start) | C = 2,2 µF, I = 100 mA | | | | ms
| t(start) | C = 2,2 µF, I = 100 mA | | | | ms

Cuadro 2: Especicaciones del regulador lineal LDO.

Para la implementación, se utilizará un transistor de paso, responsable de disipar la potencia de recorte, realimentado por tensión y corriente, de acuerdo a la gura 2.

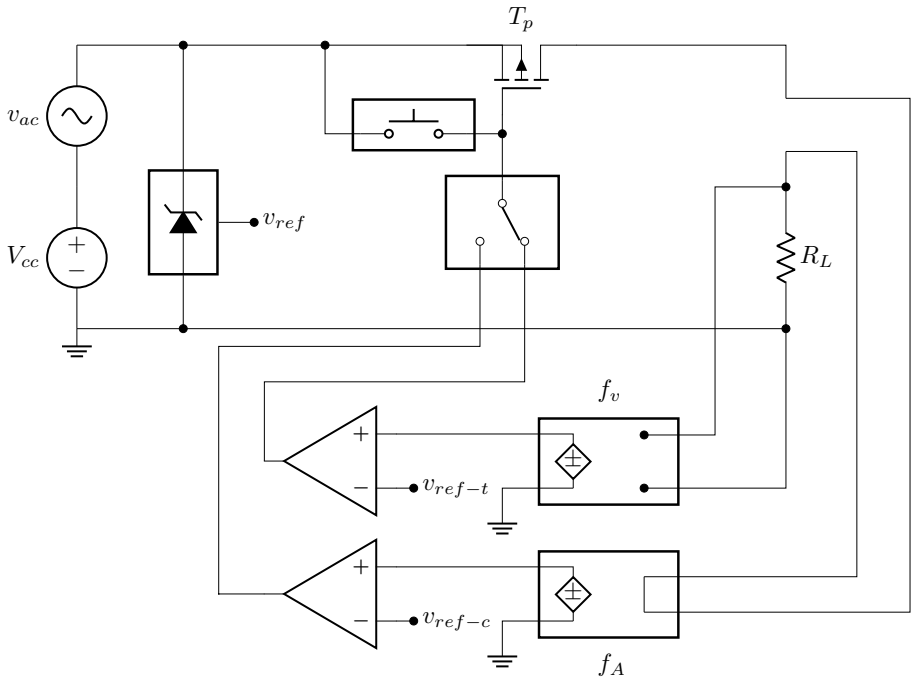
[picture p20: figure]
vac; vref; vref−t; vref−c

Figura 2: Circuito simplicado del circuito regulador LDO.

2.2.2. El transistor de paso (Tipo MOS)

La elección del transistor de paso es el primer paso de diseño, y para su elección deben tenerse en cuenta los siguientes puntos:

Canal

El canal del transistor determinará sobre dónde se efectúa el control.

vs | vd
vg | vg
vd | vs

Figura 3: Transitor de paso tipo MOS canal N y canal P.

Se conoce que la eciencia de un transistor canal N es superior a la que exhibe un canal P. Sin embargo, no necesa-riamente esto lo hace una elección atractiva para la implementación.
En este caso, al tratarse de una fuente controlada LDO, se espera que la alimentación de la fuente sea tan solo VDO mayor a Vo para que comience a regular, y por ende se espera que el circuito de control opere con tensiones menores o lo más cercanas posibles a Vo.

En este caso, de la observación de la gura 3, se observa que para el control efectivo del transistor canal N, vg deberá ser al menos vo + Vth para polarizarlo en modo triodo y poder hacer un control de tensión y corriente. Esto implica que el circuito de control requerirá al menos de una tensión de alimentación de vo + Vth. Esto signica VDO > Vth. Para valores comerciales, esto signica más de 4 V.

En consecuencia, el canal debe ser P, para simplicar el circuito y hacer posible un VDO < 1 V.

Modelo

La elección del modelo, en este caso, no es complicada debido a la escasa oferta de transistores PMOS disponibles, que a su vez cuentan con un modelo de spice para su fácil simulación.

Fundamental es que las tensiones y corrientes de operación se encuentren en el rango operativo del regulador, es decir

VDSmax = 32 V IDSmax = 1,5 A.

Además, debe operar dentro de la zona de operación segura SOA.

Con estas cosas en mente, se escoge el modelo IRF4905. Es un transistor que no sobredimensiona en gran medida la capacidad del regulador, normalmente pensado para switching pero aun así apto para la tarea.

Una de las complicaciones de elegir este tipo de canal es que ∥Vth∥ puede tomar valores de hasta vo + VDO sin afectar en gran medida el diseño circuital, pero los valores comerciales rondan Vth ≈ 4 V. Esto puede perjudicar VDO, pues Vth ≈ Vreg, sin embargo, es un compromiso de diseño que debe hacerse, pues no hay modelos de fácil acceso con otro valor Vth.

2.2.3. Lazo de Tensión

Cuando se tiene como objetivo estabilizar un valor de tensión es necesario utilizar un sistema con realimentación negativa, que muestree la señal de salida y ante cambios en la misma, se sume a la señal de control un incremento opuesto al cambio. Como primer aproximación tenemos el esquema de la gura 4, allí se observa que la señal de control viene dada por la salida de un operacional: Vctrl = ao(V

+ − V

−) = ao(V Ref − VF ) , dicha señal de controla un transistor de paso el cual brinda la corriente necesaria para obtener la tensión que se busca establecer, dicha tensión de salida Vo se muestreara mediante un divisor resistivo formado de tal modo que idealmente Vo

R1
R1+R2

= Vo · f.

−

+ VRef

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
Vref−t
Vctrl

Figura 4: Diagrama simplicado del lazo regulador de tensión.

Siendo ao la ganancia del operacional y siguiendo el esquema, se puede llegar a la siguiente condición de utilidad:

Vo = ao(VRef − f · Vo) | (1)

A =

Vo

VRef

=

ao(VRef − f · Vo)

VRef

(2)

A =

Vo

VRef

= ao − ao · f · A | (3)
A + ao · f · A = ao | (4)
A(1 + ao · f) = ao | (5)

A =

ao
(1 + ao · f)

(6)

Si se cumple que ao · f ≫ 1

A =

1
f

=

R4 + R5
R5

(7)

De esta forma la tensión de salida se puede regular mediante los resistores.

V o = A · VRef | (8)

En nuestro caso Vo = 5 V , de allí debemos encontrar valores de resistencias y de tensión de referencia adecuados.

Finalmente, se diseña el amplicador diferencial. El diseño nal puede verse en la gura 5.

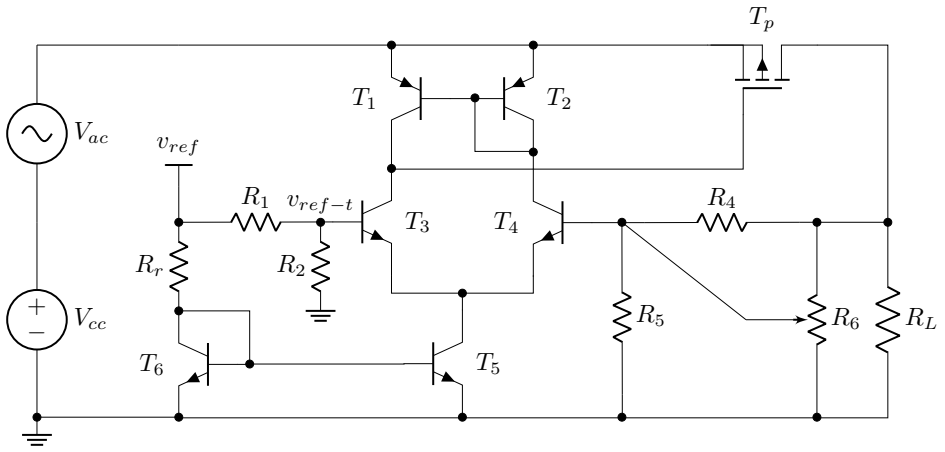
[picture p21: figure]
vref; Vcc; Vac; vref−t

Figura 5: Diseño nal de lazo de tensión.

Rápidamente, las ecuaciones que denen la ganancia de la etapa son las siguientes:

Avd = gm3/4(

ro1/2
4
) | (9)

Avc =

gm4 · 1/gm2
1 + 2gm3 · ro5

(10)

Es fácil de ver que, para resistencias ro > 100 kΩ, siempre se dará ao ≫ 1.

Algunas consideraciones de diseño:

Rango de rechazo de modo común
Se espera un rango de rechazo de modo común de

RTMC⁺ = Vcc − vbeon − vceon + vbeon ≈ Vcc − 0,3 V

RTMC⁻ = 0V + vceon + vbeon ≈ 1 V.

Notar que esto limita el valor de VDO ≥ 0,3 V.

Fuentes de corriente
El amplicador diferencial cuenta con una fuente de corriente espejo como carga activa, y una fuente de corriente espejo simple que regula la alimentación general. La implementación de cargas activas es fundamental tanto para conservar un rango de rechazo de modo común aceptable como para mejorar enormemente la ganancia ao y el rechazo de modo común RRMC.

Alimentación del par diferencial
La alimentación puede colocarse directamente sobre vcc, pues las variaciones se ven reejadas a la entrada como tension común.

Elección de transistores
Se utilizan los modelos BC547 y BC557, por ser modelos aptos para la operación con los valores de tensión de trabajo y tener alta ganancia, ideal para los pares diferenciales.

Mejora de VDO
La tensión de referencia vref deberá ser lo más baja posible para asegurar una tensión VDO lo más chica posible. Esto se debe a que, para una Vth = 4 V y una tensión de alimentación Vcc ∼ 5 V, se corre el riesgo de subir demasiado la tensión vce5 = vreg − vbeon por encima de Vcc − Vth, saturando el par diferencial. Para una tensión de referencia de Vreg−t = 2,5 V la mínima alcanzable con un TL431 , la tensión vce5 ≈ 1,8 V. Esto limita nuevamente la tensión VDO = (vce5 + Vth) − Vreg = 800 mV.
Para solucionar este problema, se usa el divisor resistivo R1 = R2, para obtner una vref−t = 1,25 V.

Esto sólo es válido pues, según el modelo pi, la resistencia vista hacia la base del transistor T3 ≈ rπ +βro(T5). O, visto de otra forma, la corriente de base ib3 ≪ vref /(R1 + R2).

Elección de Rr
Se ja Rr en un valor estándar que aporte una corriente de operación normal ∼ 1 mA. En este caso Rr = 1 kΩ, esto da una corriente de operación de 1,8 mA para una tensión de referencia Vref = 2,5 V, lo que es 900 mA para cada transistor del par diferencial.

Agregado de R6 El agregado de R6 tiene como propósito la sencilla modicación de fv =

R5
R5+R6

, de forma lineal.
Esto lo hace modicando ambos valores de resistencia simultáneamente. Notar que si se colocara sobre R5 o R6, se corre el riesgo de variar enormemente fv con pequeñas variaciones mecánicas.
2.2.4. Tensión de referencia VRef

Para obtener una tensión de referencia se utiliza un circuito basado en un diodo zener en polarización inversa, el cual ja una tensión de acuerdo a la conguración de un divisor resistivo. En este caso se optó por el circuito integrado TL431, el cuál es un regulador de derivación ajustables de tres terminales, con estabilidad térmica especicada en rangos de temperatura aplicables para aplicaciones automotrices y comerciales. La tensión de salida puede ajustarse a cualquier valor entre 2,5 V y 36 V, con dos resistencias externas tal como se observa en el diagrama de la gura 6.

R2

R1

T L431

T1

Rs

Vcc

Vref

Figura 6: Diagrama simplicado del circuito de tensión de referencia para regular tensión.

El transistor T1 sirve a la función de entregar corriente, manteniendo la tensión de referencia ja. Este elemento es fundamental para alimentar las fuentes de corriente de los pares diferenciales del lazo de tensión (gura 5) y del lazo de corriente.

De la hoja de datos, se obtiene la siguiente fórmula para esta topología:

Vref = 2,5 V ·

1 +

R1
R2
(11)

Se busca la menor tensión de referencia posible, entonces se puede asignar R1 = 0 para obtener una tensión de 2,5 V.

La resistencia Rs cumple la función de limitador de corriente, pues

IT L431 =

Vcc − (Vref + vbeon)
Rs
, | (12)

como tal, se utiliza una resistencia Rs = 2,2 kΩ → IT L431 = 2,86 mA. Esto permite que, al variar la entrada fuera de los valores de operación normales Vcc = 9,5 V, el dispositivo siga regulando correctamente: Vcc = 6 V → IT L431 = 1,3 mA, pero que no consuma corriente excesiva.

2.2.5. Lazo de Corriente

Ya conociendo una regulación básica de tensión, la regulación de corriente requiere un muestreo de la misma, el cual se da al medir la tensión en un resistor de bajo valor de resistencia colocado en serie con la carga. Luego se utiliza un amplicador para lograr obtener la muestra de tensión sin afectar la carga y se realimenta negativamente, a menor tensión menor corriente sobre la carga, tal como muestra la gura 7.

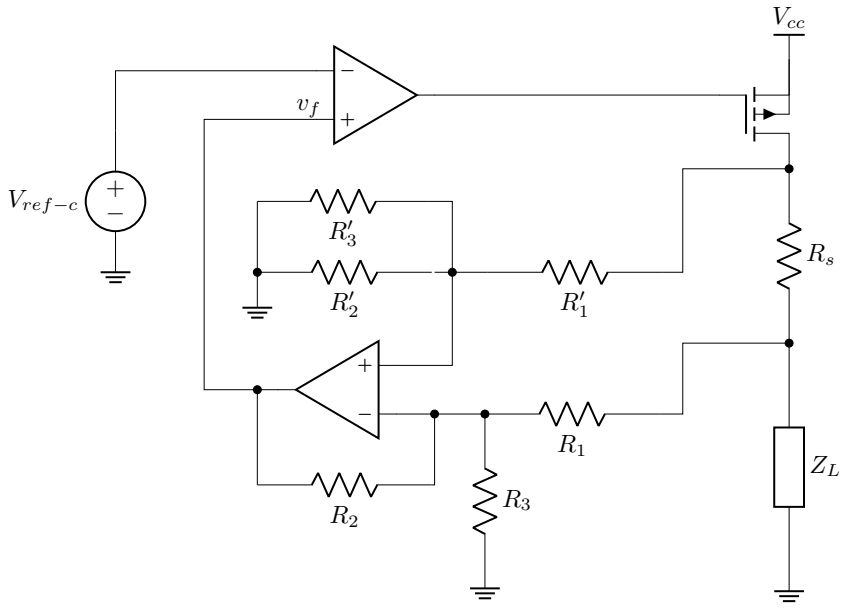
[picture p22: figure]
+ Vref−c; Vcc

Figura 7: Diagrama simplicado del circuito regulador de corriente.

A su vez, se puede lograr limitar la corriente estableciendo un máximo de corriente con el objetivo de proteger la carga de sobre corrientes. Esto se puede establecer dentro de la misma regulación de corriente estableciendo una tensión de referencia que contenga información de la corriente máxima. De allí denotamos VRef−c la tensión de referencia que establece la corriente máxima y VRef−t la tensión de referencia que establece la tensión de salida objetivo.

El objetivo de este circuito es aplicar una protección tipo foldback. Esto quiere decir que una vez se alcanza la máxima corriente otorgable por la fuente, Imax1,5 A, si se sigue reduciendo la carga, entonces la corriente otorgada seguirá disminuyendo. Esto proteje tanto al regulador como a la carga.

Para la implementación de este tipo de fuente, sin embargo, hace falta algo más que una simple referencia, pues la corriente objetivo varía con la salida de tensión, creando una relación I-V lineal.

La elección de resistores se hace en función al compromiso VDO-Efectividad del lazo. En este caso, se asigna Rs = 0,2 Ω. Para una corriente máxima, generará una caída de tensión de VRs = 0,3 V, es decir, VDOmax = 0,3 V.

Antes de continuar, es importante observar que, si bien el diferencial de tensión generado por Rs es muy pequeño, ambos terminales se encuentran muy cercados a V = Vreg. Al alimentar al amplicador, se estará muy cerca de exceder el rango de tensión de modo común RTMC. Para solucionar este problema, se agrega un nuevo divisor resistivo a la entrada del amplicador.

Como se quiere tener control sobre el valor nal de VRs, se realimenta para obtener

vf = (Io · Rs) ·

R2
R1

(13)

Se busca una tensión vf para corriente máxima vfmax < Vreg. A tal efecto se asignan (R2 = 6,8 kΩ, R1 = 1 kΩ) → vfmax = 2,04 V. Es importante que este valor sea bajo para que el par diferencial no sature en tensiones de alimentación Vcc ≈ 5 V, del mismo modo que se hace con vref−t.

Finalmente, el amplicador de control se encargará de asegurar ao · f ≫ 1. Notar que, si I

↑
o → v

↑
f → v

↑
g → I

↓
o

, cerrando
el lazo de realimentación negativa. El valor de Io se estabilizará cuando Vref−c = vf .

Adicionalmente, se debe elegir el modelo de amplicador a utilizar. En este caso se emplea el LM358 (o LM348) por su alimentación simple y operación con bajas tensiones de alimentación.

Para el diseño amplicador diferencial nal, se utiliza la misma topología del lazo de tensión, de la gura 5, con carga activa y fuente espejo.

2.2.6. Tensión de referencia VRef−c

Este circuito genera una referencia modicada que se usa para implementar limitación de corriente tipo foldback. La idea es que el límite de corriente dependa de la tensión de salida Vo

Cuando la salida cae (por ejemplo en un cortocircuito), el circuito reduce aún más la corriente permitida, protegiendo al transistor de paso y la carga.

Para conseguir este tipo de comportamiento, es necesaria una referencia variable, de la siguiente forma:

vref−c = αvref + βvo. | (14)

Comportamiento que puede obtenerse fácilmente con un circuito amplicador sumador, como el de la gura 8. Es necesario agregar circuitos seguidores ya que las fuentes de referencia no son de baja impedancia.

Esto dota al lazo de una parte ja, que determina la corriente mínima absoluta, y una parte variable, que determinará cómo excursiona la referencia a partir de este punto.

En nuestro caso, se esperará una corriente mínima IF BCK = 400 mA y una máxima de Imax = 1,5 A.

Para la corriente mínima, se espera una salida de tensión nula,

vref−c = αvref = vfmin = IF BCK · Rs ·

R2
R1

→ 544 mV,

entonces,

α = 0,218 =

Rα2

Rα1 + Rα2

. | (15)

Del mismo modo, para la corriente máxima, se esperará que vo = Vreg. Como tal

vref−c = αvref + βvo = vfmax = Imax · Rs ·

R2
R1

→ 2,04 V,

que dene

β = 0,3 =

Rβ2
Rβ1 + Rβ2
. | (16)

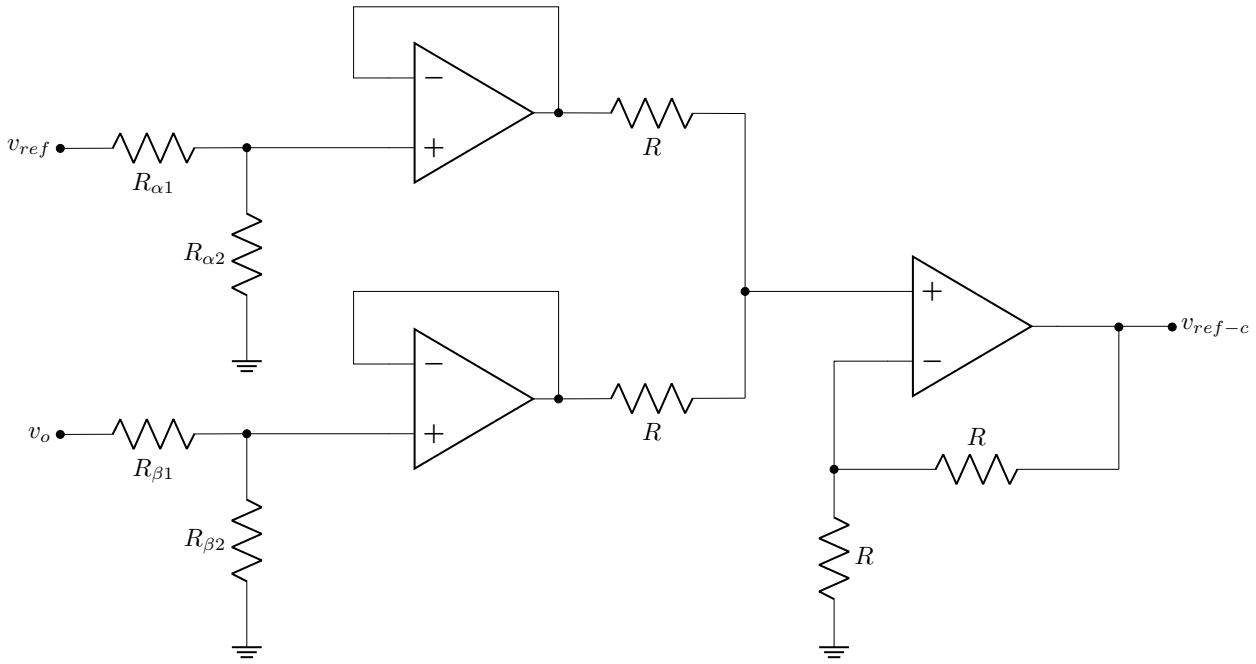
[picture p23: figure]
vref; vref−c

Figura 8: Diagrama simplicado del circuito de tensión de referencia para regular corriente.

2.2.7. Llave electrónica

Sin embargo estas dos implementaciones no podrían actuar en simultáneo, es por eso que se debe implementar un conmutador que establezca el accionamiento de uno de los reguladores según las condiciones lo requieran. Esta idea se presenta de forma simplicada en el diagrama 9.

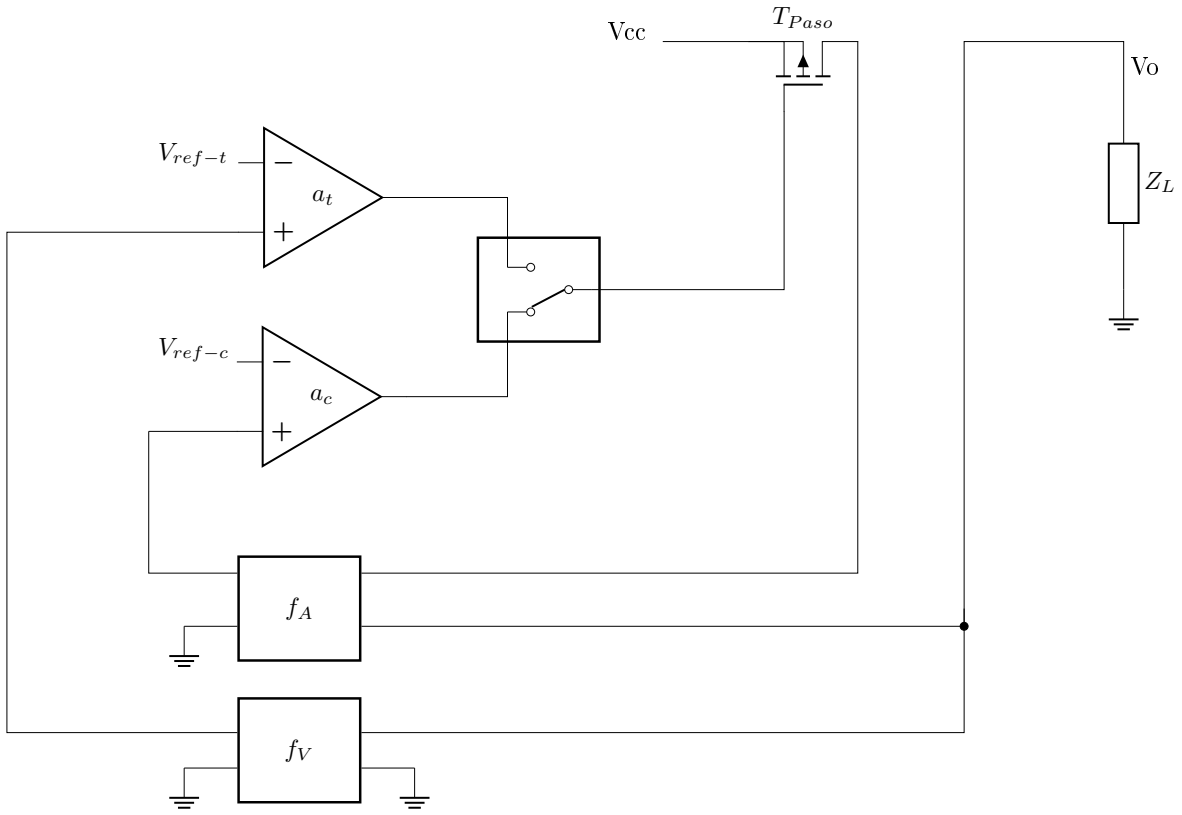
[picture p24: figure]
TP aso; Vcc; Vref−t; Vref−c

Figura 9: Diagrama simplicado del circuito regulador de corriente y tensión con conmutador.

Deben combinarse ambas señales de control, pero solo la más dominante, es decir, la que más limite al transistor de paso, será la que controle.

En este caso, ya que el transistor P-MOS reduce su corriente al aumentar vg, se esperará que el lazo dominante sea aquél con mayor tensión a la salida.

Una forma de obtener este resultado es utilizando el circuito de la gura 10.

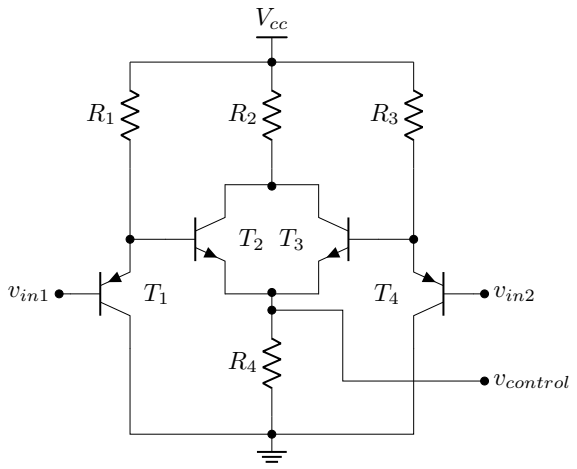
[picture p25: figure]
Vcc; vin2; vcontrol; vin1

Figura 10: Circuito llave electrónica implementado

Su función es la misma que la de dos diodos con cátodo común, pero con una caída de tensión mínima, al poner dos junturas en serie, es decir,

vcontrol = max {vin1, vin2} . | (17)

La polarización de este circuito es sencilla. Se espera a la entrada una tensión nominal de Vcc = 9,5 V, por ende

Ic1/4 ≈

Vcc − vbeon

R1/3

, | (18)

y para valores de lazo de control esperables de ∼ 5 V, se puede obtener una corriente de polarización

Ic1/4 ≈ 1 mA → R1/3 = 10 kΩ. | (19)

Para los resistores R2/4, se buscará polarizar fuertemente el transistor que conduce, para ello, se busca una corriente alta IR4. Nuevamente, para valores de control vcontrol ≈ 5 V, se obtiene

IR4 ≈ 2 mA → R4 = 10 kΩ, | (20)

pero la caída sobre R2 no debe ser tan alta, para admitir mayor excursión de Vcc, por ello se elije un resistor más chico R2 = 1 kΩ.

2.2.8. Limitador de corriente shunt

El último módulo por analizar es el regulador de corriente shunt. La función que cumple es actuar rápidamente ante variaciones rápidas en la carga, y es especialmente importante para esta implementación, pues el regulador foldback es lento.

La implementación se ve en la gura 11, y su funcionamiento es muy sencillo. Cuando Io · Rs ≈ vbeon, el transistor T2 comienza a conducir y eventualmente satura, lo que toma corriente de la base de T1, que a su vez comienza a conducir, y esto acerca vctrl a vcc.

El resultado nal es que, para Io · Rs ≈ 0,7 V, vgs tiende a reducirse, limitando la corriente de salida.

Para nuestro valor de Rs, Iomax ≈ 3,3 A, aunque en las simulaciones se verá un valor menor, lo cuál es aun mejor (gura 23).

Es importante tener en cuenta que el transistor de paso deberá poder soportar, como máximo, Pmax = (9,5 V − 5 V) · 3,3 A = 14,85W, durante cortos períodos de tiempo. El modelo elegido puede hacerlo.

Fin checkpoint 1

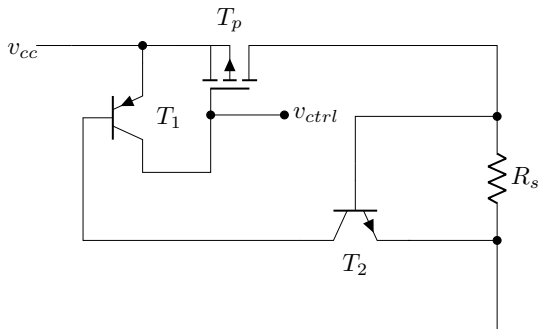
[picture p26: figure]
vctrl; vcc

Figura 11: Implementación nal del regulador shunt.

Inicio checkpoint 2

2.2.9. Compensación de lazos

Para nalizar el anállisis de diseño circuital de esta etapa, se debe evaluar su comportamiento en frecuencia. Para ello, se debe evaluar el peso de los nodos al circular por cada lazo de realimentación, procurando que se cumplan dos condiciones de diseño fundamentales:

|T(jω)| < 1 ∠T(jω) > 30◦
(21)

Estos dos parámetros, el margen de ganancia y el el margen de fase, respectivamente, garantizan que para una señal de frecuencia fh

|T(jω)| = 1, la ganancia de lazo nunca se invertirá, provocando una realimentación negativa.

Debido a que la ganancia de lazo se puede aproximar a un sistema de primer orden, si existe un polo dominante, entonces se puede asegurar que no habrá ningun caso en que el circuito oscile.

Nuestro análisis, entonces, se dividirá en dos partes: la compensación del lazo de tensión, con ganancia Tv, y la compensación del lazo de corriente, con ganancia TA, partiendo de los grácos obtenidos en la sección ??.(Ganancias de Lazo sin compensación), las guras 18 y 20.

Lazo de tensión:

El circuito de lazo de tensión completo incluye el divisor resistivo de ajuste, el amplicador diferencial y la llave electrónica. Teniendo en cuenta el modelo pi para pequeña señal, y la reexión de Miller, se identican los nodos potencialmente dominantes de la gura 12. Notar que la llave electrónica se transforma en dos colectores comunes en serie, con ganancia |Av| ≈ 1.

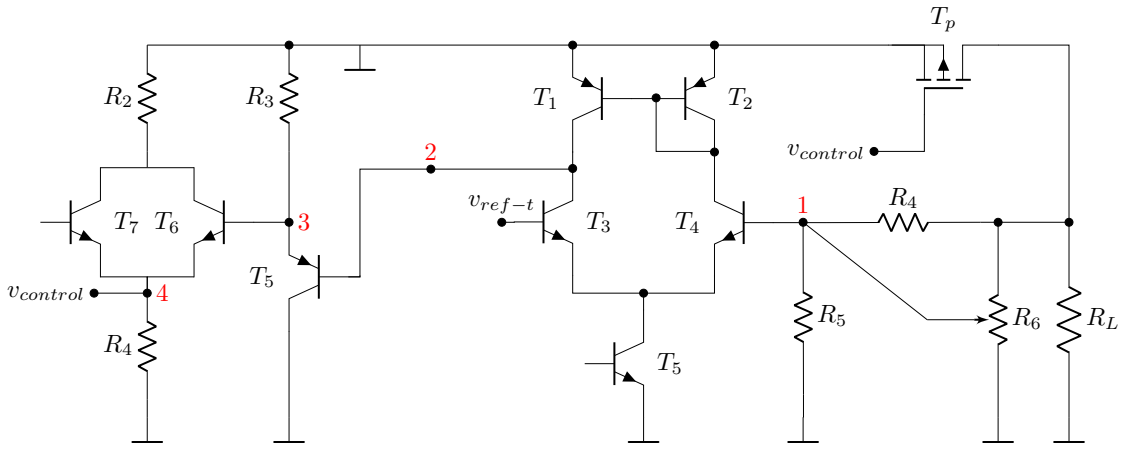
[picture p27: figure]
vref−t; vcontrol

Figura 12: Nodos potencialmente dominantes del lazo de tensión.

Dadas las capacidades Cπ ≈ 10 pF y Cµ ≈ 1,7 pF, extraídas de las hojas de datos, se analizan los nodos cualitativamente para buscar, de haber, un nodo dominante:

1:
Sobre el nodo 1 hay dos capacidades parásitas, C

∗
π y C

∗
µ

, ambas reejadas según Miller:

C

∗ = CA−B · (1 −

vb
va
) | (22)

Al tratarse T4 de un emisor común fuertemente realimentado por T5, con una resistencia de colector equivalente muy chica ≈ 1/gm, se espera que la tensión de colector sea menor que la de base, conservando C

∗
µ ≈ Cµ. Para C
| ∗ π , se
observa una conguración colector común, con ganancia 0 < |Av| < 1. Esto resulta en la casi anulación de la misma C

∗
π → 0.

Como resultado, se espera una frecuencia de corte muy alta, despreciable para el análisis.

2:
En el nodo 2 participan cuatro capacidades, C

∗
π5

, Cµ5, C

∗
µ3 y C

∗
µ1

C

∗
π5

se encuentra entre los nodos b y c de un seguidor, por lo tanto C

∗
π5 → 0. C

∗
µ3 y C

∗
µ1
| se encuentran en conguración
emisor común invertido, por ende, |Av| = 0 → C

∗
µ = Cµ.

Es necesario analizar la resistencia asociada al circuito RC equivalente del nodo 2. Hay tres en paralelo: rb3 ≈ (rπ3 + βR3), roc3 → ∞ y roc1 ≈ ro1, con un valor máximo de 100 kΩ para la corriente de polarización calculada.

El resultado es una constante de tiempo asociada de

τ2 ≈ (3 · 1,7 pF) · (100 kΩ//200 kΩ) = 340 ns → f2 ≈ 468 kHz

3:
En el nodo 3 participan tres capacidades, C

∗
π6

, C

∗
µ6 y C

∗
π5

C

∗
π5

se encuentra en conguración seguidor inveritido, por ello |Av| → 1 y C

∗
π5 → 0. C

∗
π6
| se encuentra en conguración
seguidor realimentado, se espera que la capacidad C

∗
π3 → 0. Finalmente, C

∗
µ6
| se encuentra en conguración emisor
común realimentado, con ganancia |Av| ≈ gm3·R2
1+gm3·R4 ≈ 0,01.

La resistencia sociada al nodo será R3, por ser ambas resistencias rb3 y rb4 muy superiores.

El resultado es una constante de tiempo asociada de

τ3 ≈ (1,7 pF) · (10 kΩ) = 17 ns → f2 ≈ 9 MHz

4:
Finalmente, el nodo 4 tiene cuatro capacidades parásitas asociadas: C

∗
π6

, C

∗
π7

, Cπtp y C

∗
µtp.

C

∗
π6 = C

∗
π7 por simetría de circuito, y se encuentran en conguración seguidor invertido, por lo que tienden a ser nulas.

Cπtp = 3400 pF y Cµtp = 1400 pF se obtienen de la datasheet del transistor de paso. Para reejar Cµtp, se tiene en cuenta que la conguración es source común sin realimentación, y por ende la ganancia dependerá de RL, y será alta.

La resistencia asociada al nodo será R4//(rπ6 + R3)/β//(rπ7 + R3)/β, y la estimaremos (de forma muy aproximada) como R4//R3/2 = 3,3 kΩ.

La constante temporal mínima será, entonces:

τ4 = (3,4 nF + 1,4 nF) · (3,3 kΩ) = 16 µs → f4min = 10 kHz.

Este resultado es congruente con lo simulado en la imagen 18. Se concluye que el nodo 4 es dominante, pues se encontrará al menos una década por encima del siguiente polo.

2.3. Analisis termico

Por el transistor de paso, en el peor de los casis, va a tener una caida de VSD = VCC − VO = 9,5V − 5V = 4,5V , y va a circular una corriente maxima de IL = 1,5A, llegando a tener una PC,MAX = 6,75W. Por ende es necesario realizar un analisis térmico y ver si requiere agregar un disipador en dicho transistor de paso:

Los siguientes datos fueron obtenidos del datasheet y de nuestro circuito:

Rjc = 0,75 ◦CW⁻¹

Rcs = 0,5

◦CW⁻¹

Rja = 62 ◦CW⁻¹

Ta = 50 ◦C

Tj,MAX = 175 ◦C

Pc,MAX = 6,75W

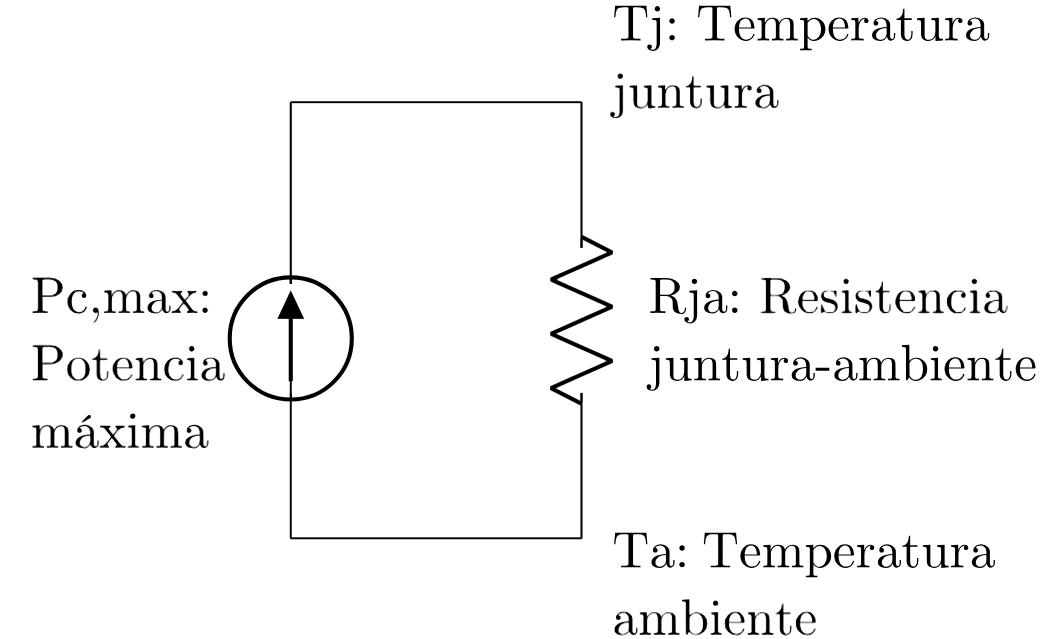
[picture p28: figure]

Figura 13: Modelo térmico sin Rsa

Primero se analizamos si la temperatura máxima que lle-ga Tj , sin el disipador, supera a la temperatura de juntura máxima permitida:

Tj = Tja + Ta
Tj = PC,MAX · Rja + Ta
Tj = 419 ◦C + 50 ◦C
Tj = 469 ◦C
Tj = 469 ◦C ≫ Tj,MAX = 175 ◦C | (23)

Se observa que si no hay un disipador, la temperatura de la juntura supera la máxima permitida.

Ahora se analiza que Rsa máxima es necesaria tal que la temperatura de juntura no supere la máxima permitida.

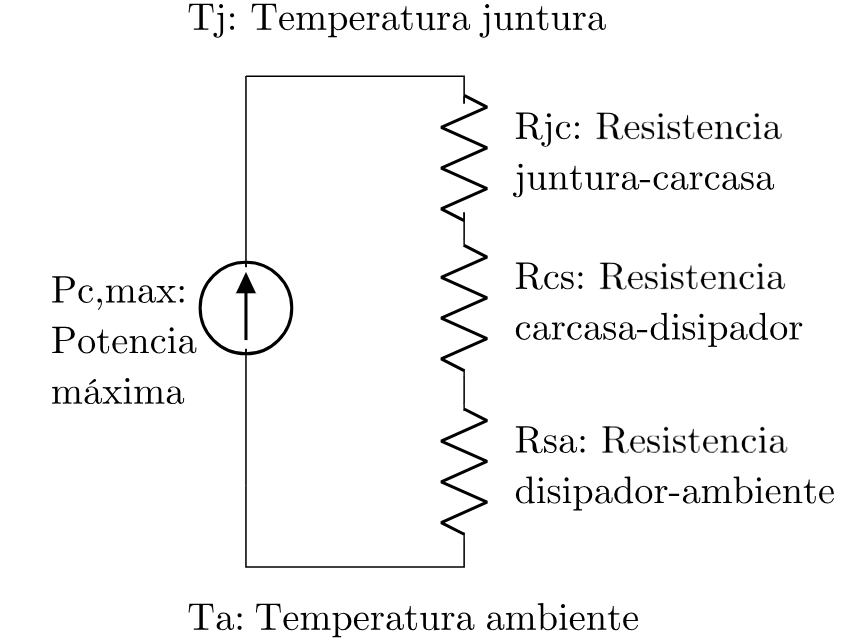
[picture p29: figure]

Figura 14: Modelo térmico con Rsa

Rtotal = Rjc + Rcs + Rsa,MAX

Tj,MAX − Ta

PC,MAX

= Rjc + Rcs + Rsa,MAX

Rsa,MAX =

Tj,MAX − Ta

PC,MAX

− Rjc − Rcs

Rsa,MAX = 17,3

◦CW⁻¹

Rsa ≤ Rsa,MAX = 17,3

◦CW⁻¹
(24)

Se debe elegir un disipador con un Rsa que cumpla esta condicion para que el transistor de paso no se queme.

Se elige el siguiente disipador:

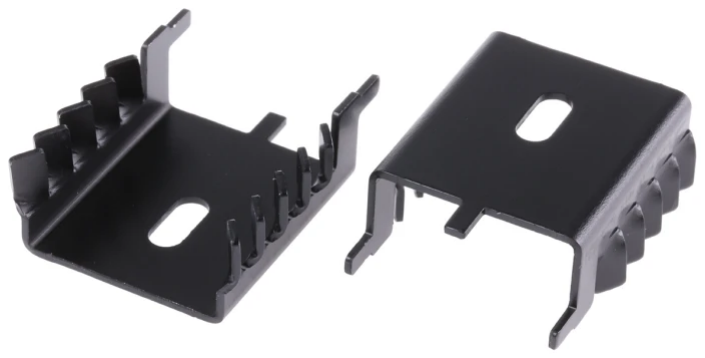
[picture p30: figure]

Figura 15: Disipador

Se selecciona un disipador del fabricante AAVID Thermalloy, diseñado para encapsulados tipo TO-220. Este disipador presenta dimensiones (35 mm Ö 12.3 mm Ö 29 mm).

La elección de este disipador se justica debido a que su resistencia térmica cumple con la condición de diseño requerida:

Rsa = 13 ◦CW⁻¹ < Rsa,MAX = 17,3

◦CW⁻¹
(25)

Por lo tanto, el dispositivo garantiza que la temperatura de juntura del transistor se mantenga dentro de los límites seguros de operación.

2.3.1. Consideraciones de fabricación PCB

Todo diseño presenta desafíos; en este caso, al desarrollar el circuito impreso, el objetivo principal es maximizar el rendimiento, garantizar la robustez y lograr una implementación compacta en una placa adecuada.

Debe poseer un tamaño adecuado para su integración en el sistema completo y contemplar tecnologías que ofrezcan la mejor relación entre rendimiento y costo. El uso de estándares y normas, como la IPC-2222 para placas rígidas, sirve como guía durante el proceso de diseño. Tanto el esquemático como las huellas de los componentes, los modelos 3D y el diseño de la PCB fueron desarrollados utilizando el software KiCad.

Arquitectura general

Una PCB de dos capas (top y bottom), orientada a simplicidad de fabricación y bajo costo.

Selección de materiales y encapsulados Para la placa se utilizó material FR-4 como sustrato de espesor 1,6mm, debido a su disponibilidad, bajo costo y adecuadas propiedades dieléctricas para aplicaciones de baja y media frecuencia. Es un compuesto laminado de tela de bra de vidrio tejida con un aglutinante de resina epoxi, reconocido por ser ignífugo (cumple con la norma UL94V-0), mecánicamente resistente, con excelente aislamiento eléctrico y alta estabilidad dimensional. Dicho sustrato tendrá sobre sus supercies las pistas mediante un laminado de cobre.

Cuadro 3: Límites máximos de temperatura de operación según clase (estandar IPC-2222).

NEMA | IPC-4101 | Espesor dieléctrico (mín) | Temperatura (máx)
FR-4 | 21/24/25/27 | 0.1 mm | 120 ◦C
FR-4 | 21/24/25/27 | 0.4 mm | 130 ◦C

Se seleccionaron los siguientes encapsulados para cada tipo de componente:

TO-92: transistores bipolares discretos y regulador zener programable TL431.

TO-220: transistor PMOS IRF4905.

DIP-8: amplicadores operacionales LM324.

Cabe resaltar que el uso de componentes integrados, como el LM324 que incorpora cuatro amplicadores operacionales en un mismo encapsulado, permite reducir el área de la placa. Asimismo se evitara la selección de encapsulados con pines no conectados (NC, No Internal Connection), como en el caso del TL431, lo cual contribuye a un diseño más eciente. Como mejora se podrían considerar componentes de montaje supercial.

Selección de huellas y modelos 3D

Ancho de pistas El dimensionamiento de las pistas se realizó en función de la corriente máxima esperada (1.5 A) y el aumento de temperatura permitido. Para ello se consideraron normas empíricas asegurando que:

Las pistas de potencia (entrada y salida del LDO) poseen mayor ancho para reducir caída de tensión y disipación.

Las pistas de señal se diseñaron más delgadas, priorizando densidad de ruteo.

La masa o tensión de referencia se implementó mediante rellenos de estaño, intentando maximizar su continuidad.

Disposición de componentes Para este sistema de regulación de tensión con nes académicos se propuso como desafío una placa con una disposición de componentes que respete la modularización del circuito y priorice la identicación de los bloques.

Consideraciones térmicas Se contempló la disipación de potencia del regulador:

Se aumentó el área de cobre asociada al encapsulado para mejorar la disipación térmica.

En la versión multicapa, el plano de masa contribuye a la distribución del calor.

Separación y reglas de diseño Se respetaron distancias mínimas entre pistas según el nivel de tensión del circuito, evitando riesgos de cortocircuito o corrientes parasitas. Asimismo, se denieron reglas de diseño (DRC) acordes al proceso de fabricación.

Fin checkpoint 2

2.3.2. Mejoras:

Aunque el regulador lineal satisface las especicaciones de la tabla 2, hay algunas mejoras que pueden realizarse al circuito para mejorar aun más su desempeño:

Mejora de rechazo al ruido: Se observó que el rechazo al ripple de altas frecuencias (100 kHz) no es bueno (ver gura 21). Algunos elementos que favorecen este comportamiento es la alimentación de varios módulos pertenecientes a lazos de realimentación con la fuente de entrada Vcc. Si se hiciera una relación de compromiso y se limitara Vccmax, podría alimentarse los lazos con fuentes controladas estables.

Adicionalmente, la tensión de control Vgs se ve referida a la fuente de tensión, por lo que, por muy estable que sea vg, seguirá habiendo uctuaciones. Esta es una limitación importante del transistor de paso canal P. Una forma de contrarestarlo sería hacer la respuesta de los lazos más rápida.

Lazo de corriente: El lazo de corriente contiene un máximo de tres etapas amplicadoras, y 5 en total. La implementación más rudimentaria de regulación foldback utiliza tan solo un transistor y tres resistencias. Buscar un modo de reducir la circuitería haría el circuito más rápido, eciente y simple. Una ventaja de mantener la conguración actual es la precisión de regulación estacionaria.

Par darlington: Utilizar un par darlington en los pares diferenciales aumenta enormemente la resistencia Rdif f , así como la ganancia Ad, por mejorar el valor de gm.

## 3. Simulaciones

3.1. Simulaciones del regulador lineal LDO
3.1.1. Modo estático

Para vericar el diseño se realizan simulación en el software LtSpice utilizando los modelos necesarios y las conexiones detalladas en el apéndice A en la captura de la gura 22.

En particular, se evaluaron distintos aspectos fundamentales del desempeño del regulador LDO. En primer lugar, se evaluó la hipótesis ao.f ≫ 1 para ambos lazos. Luego se analizó la estabilización de la tensión de salida frente a variaciones temporales de la tensión de entrada y la regulación de línea, que caracteriza la capacidad del regulador para mantener constante la tensión de salida ante cambios en la tensión de entrada. Asimismo, se evaluó la regulación de carga, analizando la variación de la tensión de salida frente a cambios en la corriente demandada por la carga.

Adicionalmente, se calculó la eciencia del regulador, denida como la relación entre la potencia entregada a la carga y la potencia suministrada por la fuente de entrada. Este análisis permite estimar el rendimiento energético del circuito y las pérdidas asociadas al elemento de paso del regulador.

Se presentan los resultados obtenidos para cada uno de estos casos.

Ganancias de lazo: Se observó para ambos lazos que el componente ao es, escencialmente, el amplicador diferencial al nal de cada uno sumado al circuito source común generado por el PMOS. A continuación, se rompe el lazo y se simula la amplitud de salida, del otro lado del lazo, para obtener valor numérico de |Tt| y |Tc|.

Para tal efecto, se utiliza una estructura como la de la gura 16 para conservar el circuito de contínua, pero romper el lazo en señal.

−

+ vp

L
C

vo

Figura 16: Circuito de prueba para cortar lazo.

Lazo de tensión:
Se anulan ambos lazos de corriente (shunt y foldback), aunque no se encuentren operativos para la resistencia de carga RL = 100 Ω elegida, y se coloca la estructura de la gura 16. Adicionalmente, se agregan las resistencias vistas desde cada lado del lazo para que, en señal, el corte sea limpio. Esto implica colocar una resistencia

Req ≈ 1 kΩ//(3 kΩ + 100 kΩ) | (26)

del lado del generador de señal. Debido a la alta impedancia de la resistencia vista desde la base del transistor del par diferencial, no es necesario agregar más. En la gura 17 puede verse el circuito de medición.

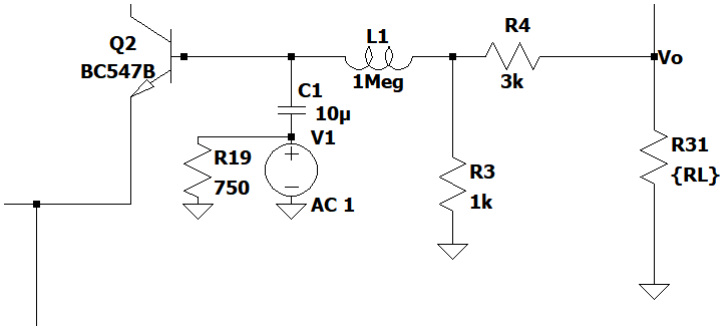
[picture p31: figure]

Figura 17: Circuito utilizado para la medición de Tv.

El resultado es un gráco de Bode como el de la gura 18. Que da una ganancia para bajas frecuencias Tv = 86 dB. Esto es suciente para asegurar ao.fv ≫ 1.

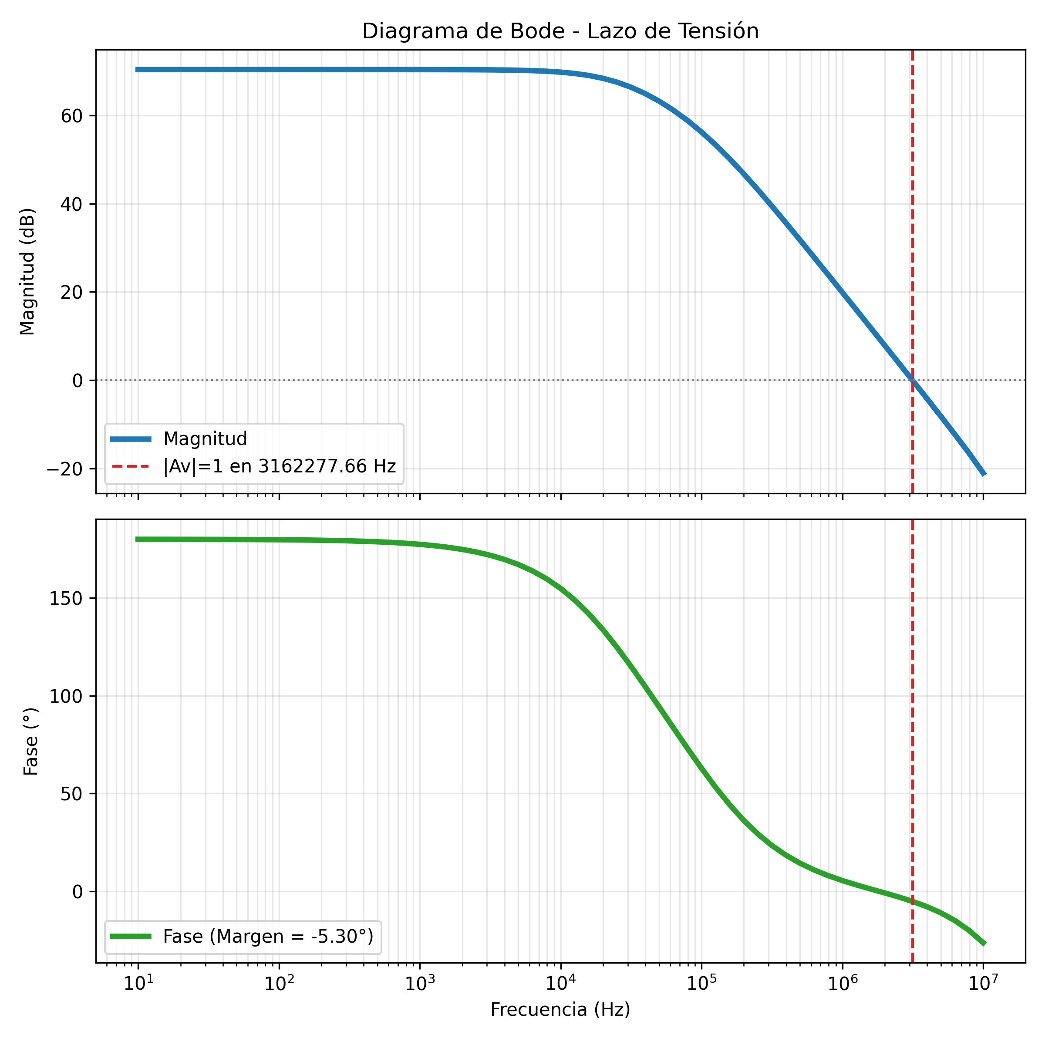
[picture p32: figure]

Figura 18: Bode resultante de la medición de Tv. Notar el polo en f ∼ 10 kΩ.

En este gráco queda en evidencia el por qué de la oscilación para la regulación de línea (21), pues la frecuencia de ruido ∼ 100 kHz seguramente se encuentre en un punto con ganancia |T| > 1 y fase negativa, produciendo realimentación positiva y oscilaciones.

Lazo de corriente:
En este caso, se realiza el procedimiento inverso. Se anula el lazo de tensión y shunt, y se corta el lazo de corriente en un punto de alta impedancia, como la base del transistor de paso. En este caso se escoge una resistencia de carga RL = 2,5 Ω para no obtener corrientes ni muy bajas ni excesivas. Se inserta una resistencia reejada de
Req ≈ 10 kΩ | (27)

del lado del generador de señal, proveniente de la llave de control. Debido a la alta impedancia de la resistencia vista desde la base del transistor de paso, no es necesario agregar más elementos reejados. En la gura 19 puede verse el circuito de medición.

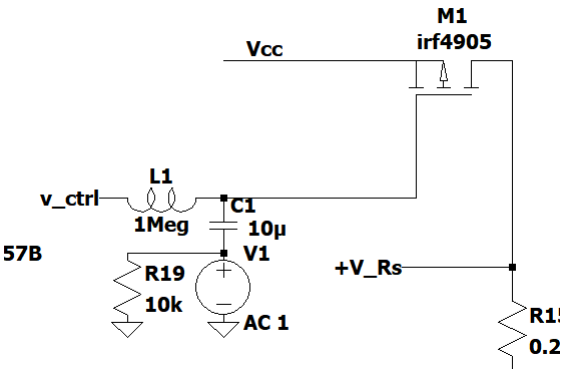
[picture p33: figure]

Figura 19: Circuito utilizado para la medición de TA.

El resultado es un gráco de Bode como el de la gura 20. Que da una ganancia para bajas frecuencias TA = 67 dB. Esto es suciente para asegurar ao.fA ≫ 1.

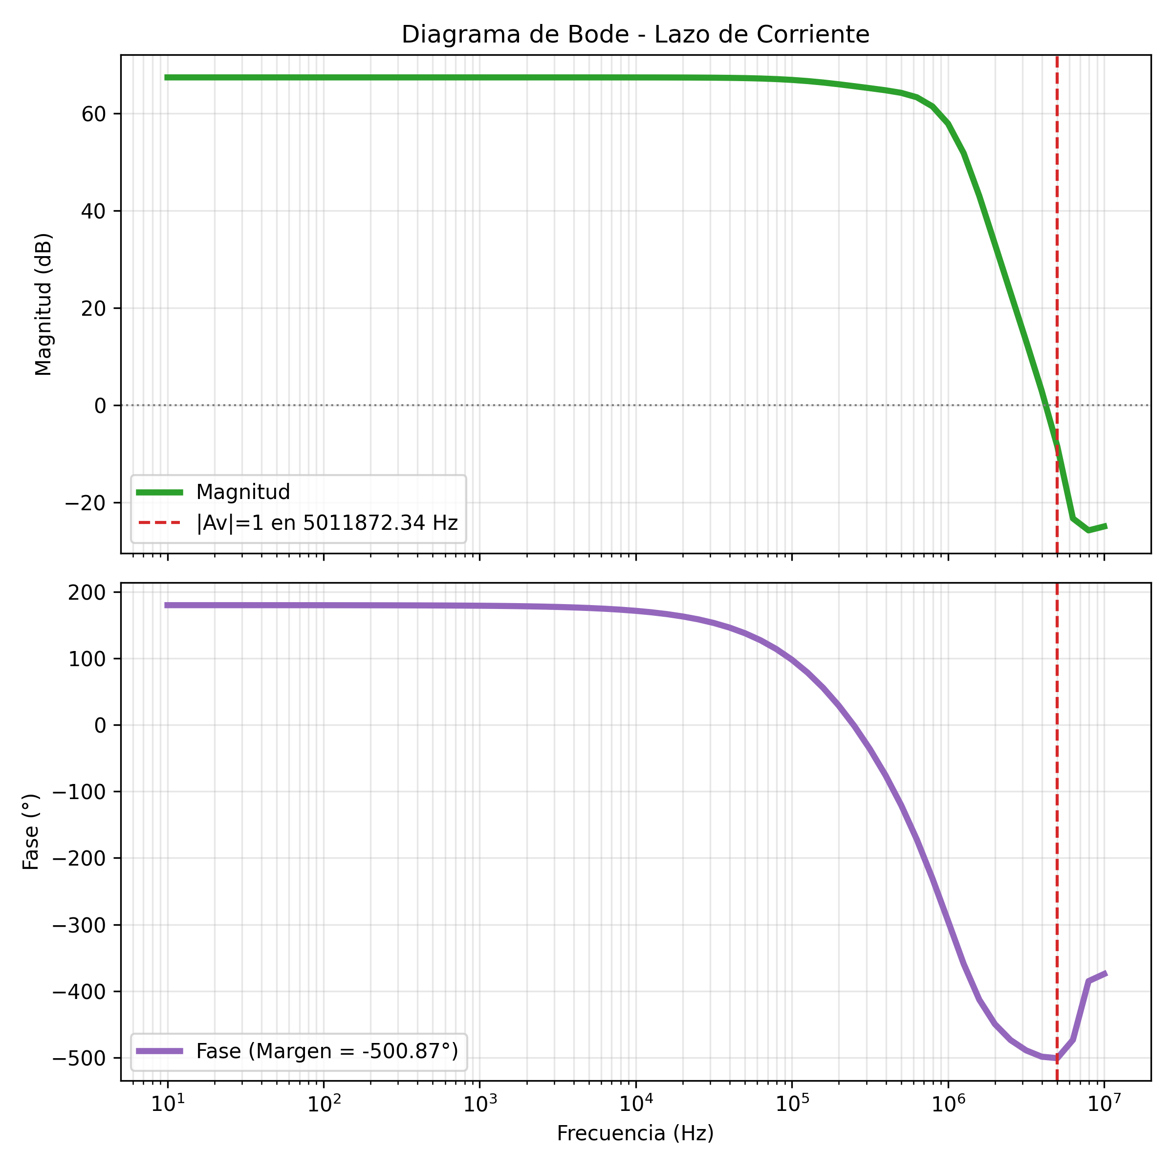
[picture p34: figure]

Figura 20: Bode resultante de la medición de TA. Notar el polo en 10 kΩ < f < 100 kΩ.

Estabilización de tensión: En la simulación temporal se verica la estabilización de tensión con respecto a la V cc prevista, utilizando un valor de carga dentro dentro de la zona de regulación estimada, logrando así constatar como se reduce el riple. Se simula tomando un valor de carga dentro del rango de regulación y se toman los valores de tensión en función del tiempo, para el análisis se comparan las componentes alternas de cada señal eliminando el valor medio de ambas, tal como se obvserva en el gráco de la gura 21.

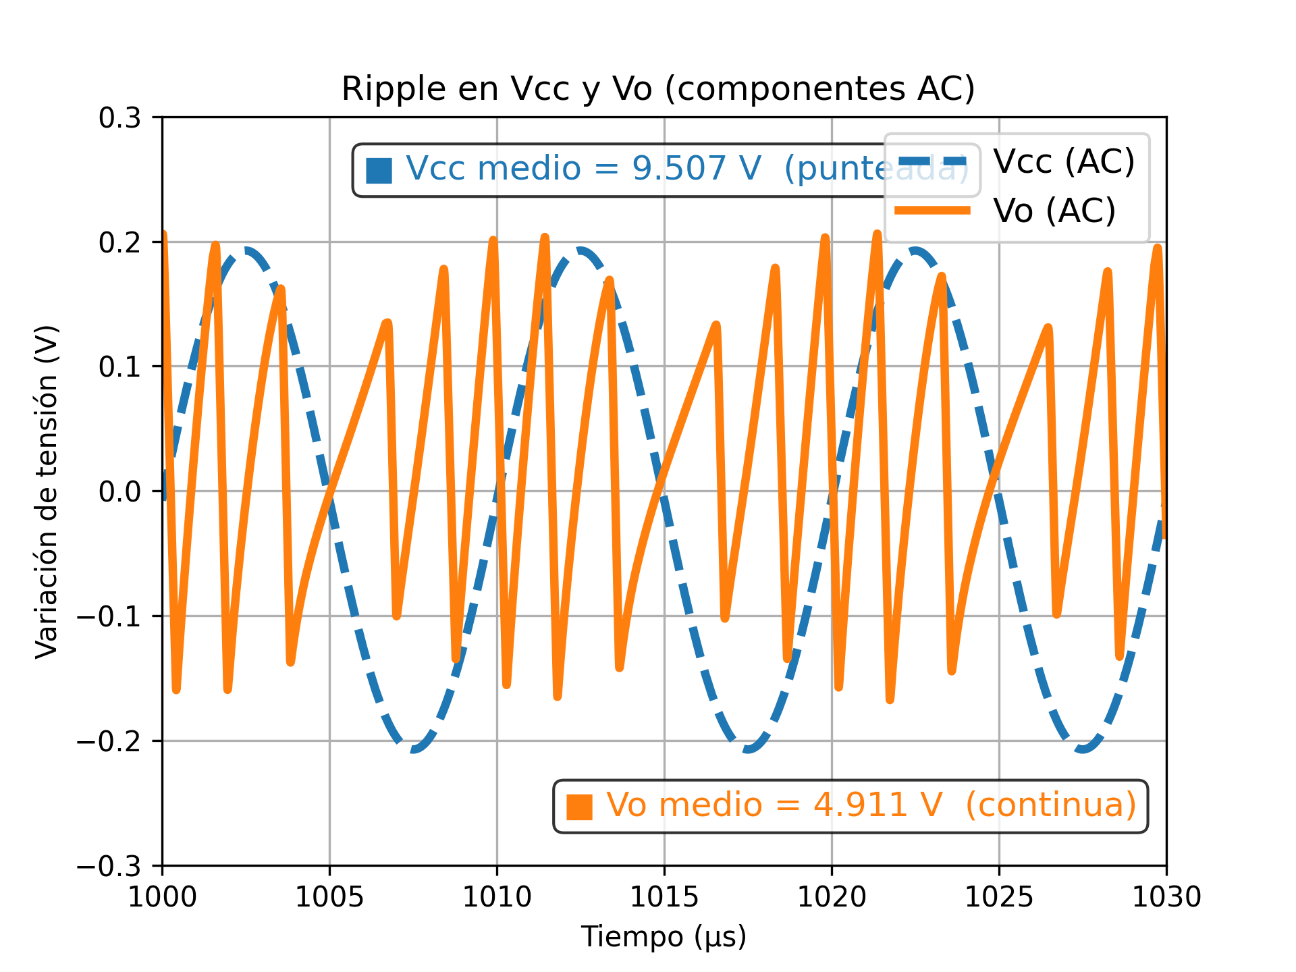
[picture p35: figure]

Figura 21: Gráco de la simulación temporal con ruido a la entrada Vpp = 0,4 V, f = 100 kH.

Regulación de Linea: La regulación de línea describe la capacidad del regulador para mantener constante la tensión de salida frente a variaciones en la tensión de entrada VCC .

Para caracterizar este comportamiento, se realiza un barrido de la tensión de entrada y se gráca la tensión de salida VO en función de VCC , para una carga ja de RL = 10 kΩ.

Zona de regulación: Para valores sucientemente altos de VCC , el regulador opera en condiciones normales y la tensión de salida permanece aproximadamente constante e igual al valor nominal. En esta región, el lazo de realimentación compensa las variaciones de entrada.

Zona de dropout: A medida que VCC disminuye, se alcanza un punto en el cual el regulador no puede mantener la tensión de salida constante. Esto ocurre cuando el transistor de paso entra en saturación (o pierde margen de control), y la salida comienza a seguir a la entrada.

Transición: El punto de transición entre ambas regiones indica el inicio de la condición de dropout.

A partir de esta curva, es posible estimar la tensión de dropout como la diferencia entre la tensión de entrada y la tensión de salida en el punto donde el regulador deja de mantener la regulación:

Vdropout = VCCmin − VO ≈ 320 mV

En consecuencia, la curva de regulación de línea no sólo permite evaluar la estabilidad de la salida frente a perturba-ciones en la entrada, sino también identicar el margen mínimo de operación del regulador.

En la gura 22 puede verse la curva de salida en función de la entrada para 0 V < Vcc < 24 V y en mayor precisión la zona de Dropout. De la simulación se obtiene

Regulacion de Linea = 447,68

µV
V
, | (28)

con un pequeño oset Vof f set = 90 mV, resultante de Vref − t = 1,242 V ̸= 1,25 V, fácilmente corregible mediante el preset implementado.

Además, se ve que la tensión de dropout tiene valor 100 mV < VDO < 320 mV, con su valor máximo alcanzado cuando Vcc = 5,27 V. (Esto ocurre porque, debido al oset de vref−t, el valor de regulación no es 5 V exactamente).

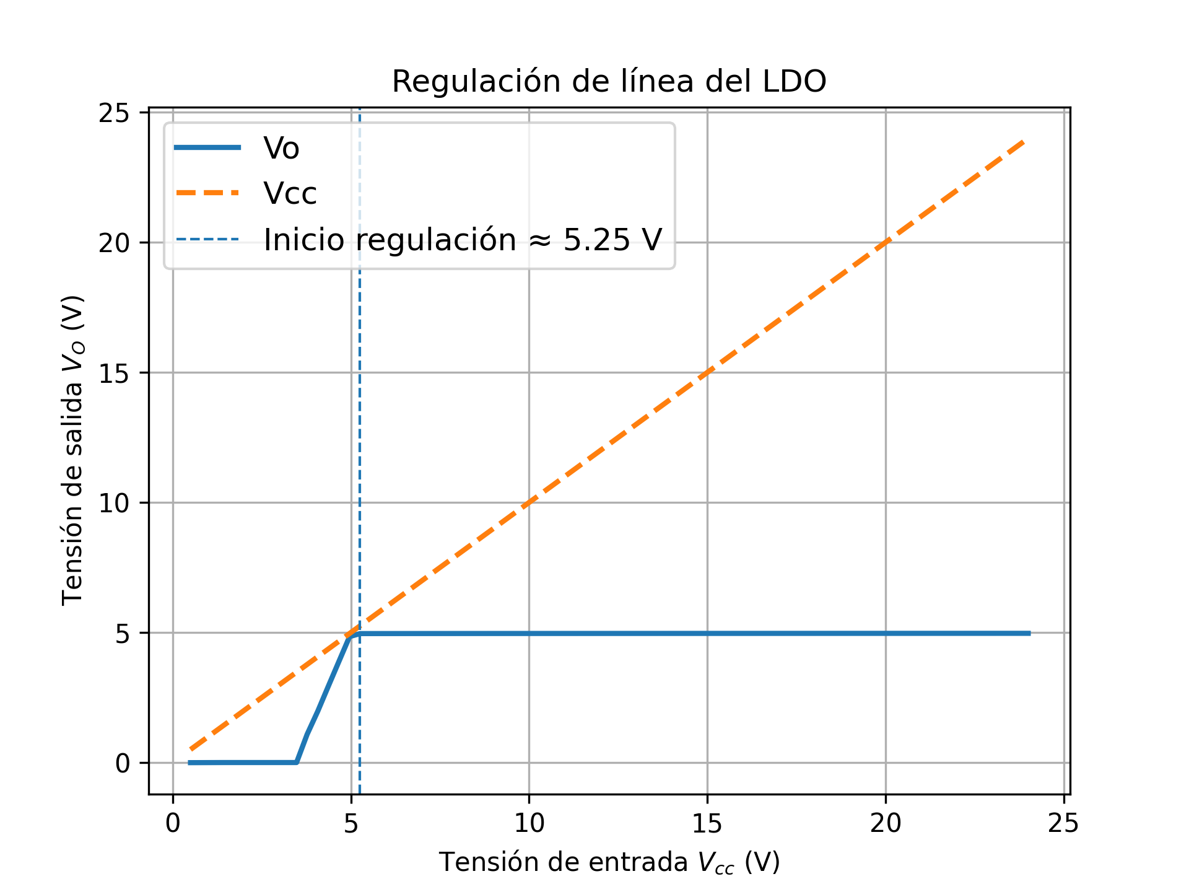
[picture p36: figure]
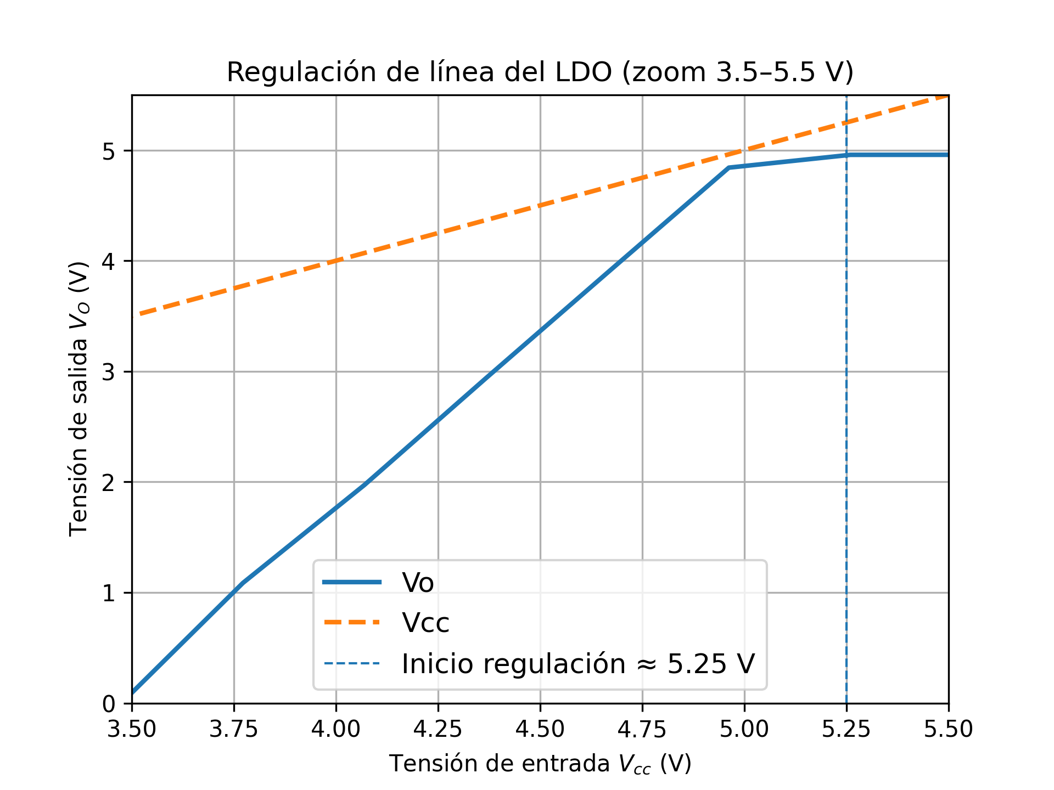
[picture p37: figure]

(a) Regulación de línea para 0 V < Vcc < 24 V. | (b) Zoom para 3,5 V < Vcc < 5,5 V.

Figura 22: Gráco de los datos de simulación de línea.

Regulación de carga: La regulación de carga puede analizarse evaluando la variación de la tensión de salida VO frente a cambios en la resistencia de carga RL. Esto se analiza insertando una fuente de corriente a la salida, para una Vcc = 9,5 V constante, y desconectando el lazo de corriente.

Para ello, se realiza un barrido del valor de RL y se observa la respuesta del regulador.

Altos valores de RL: Corresponden a condiciones de baja corriente de carga. En esta región, el regulador mantiene la tensión de salida cercana a su valor nominal.

Disminución de RL: A medida que la resistencia de carga disminuye, la corriente demandada aumenta. Idealmente, el regulador debería mantener VO constante.

Comportamiento real: En la práctica, se observa una leve caída de la tensión de salida debido a la resistencia de salida nita del regulador y a las limitaciones del transistor de paso.

Este análisis permite evaluar la capacidad del regulador para sostener la tensión de salida frente a variaciones en la carga, aunque resulta menos directo que el análisis en función de la corriente.

En la gura 23 puede verse la gráca resultante. Notar que, al poseer un lazo de corriente shunt aún activo, modicar la corriente de entrada directamente provoca una abrupta caída de tensión para Io > 2,25 A. Aun así, para la zona de control propia del lazo de tensión, pueden obtenerse resultados:

∆V
∆I

= −1, 36

mV
A
= RT | (29)

Notar que RT es negativa por disminuir Vo al aumentar Io.

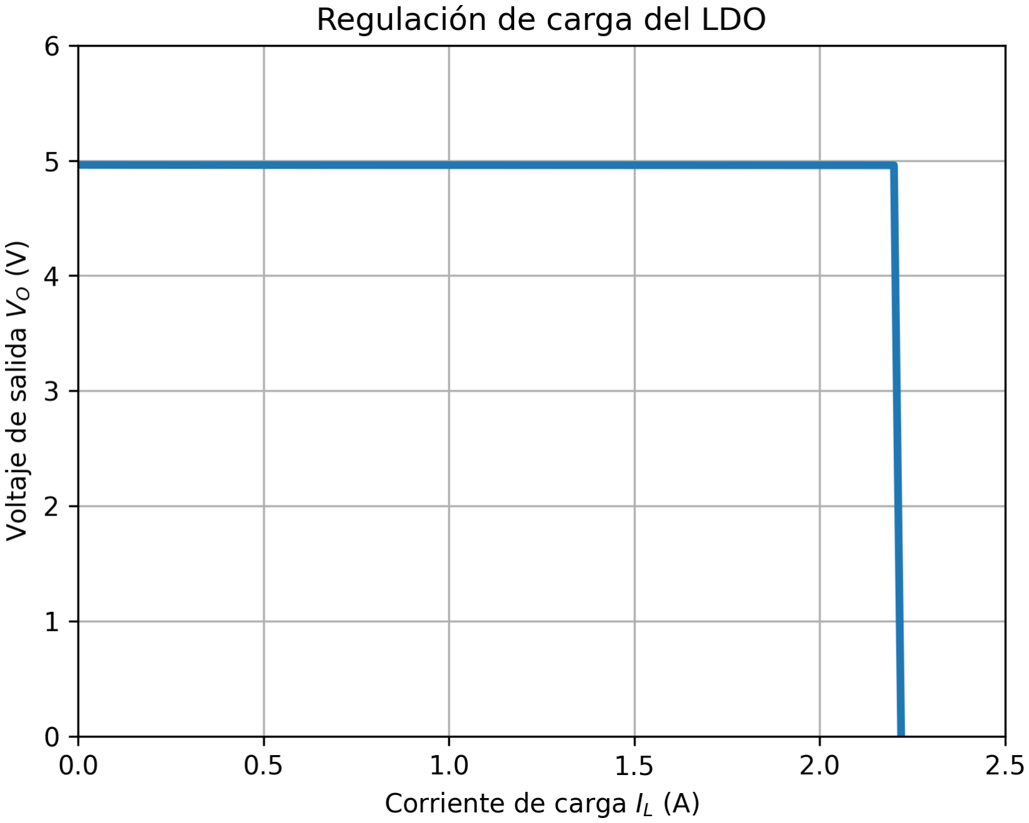
[picture p38: figure]

Figura 23: Regulación de carga del regulador lineal.

Vo en función de IL: Este gráco muestra de forma cualitativa la curva característica de la fuente de tensión resultante, es decir, la gráca Vo/IL (gura 24), mediante la variación del valor resistivo de la carga RL.

Se observa que la tensión es constante para valores RL > 3,3 Ω, y al cortocircuitar más la carga comienza a caer hacia Vo = 0 V, siguiendo la curva de corriente Io = 400mA +

1,1 A
5 V · Vo.

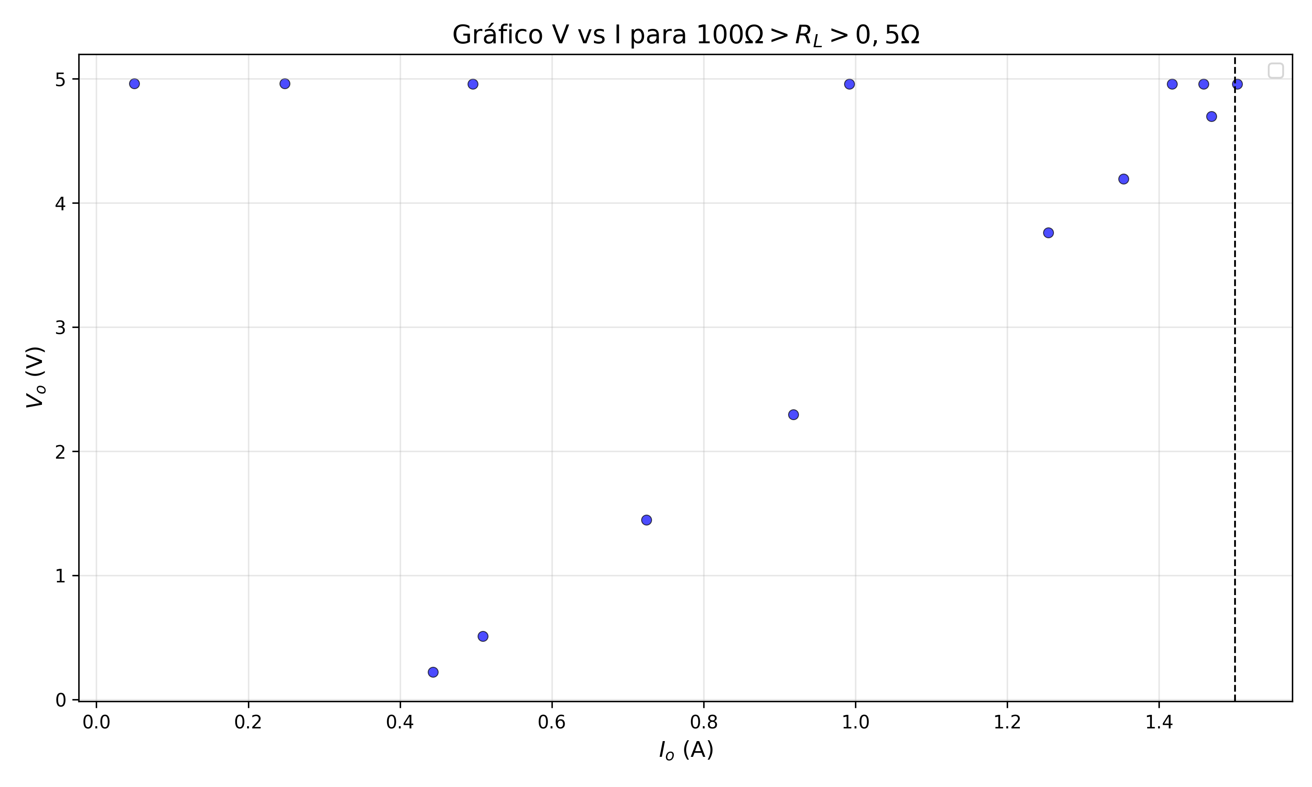
[picture p39: figure]

Figura 24: Curva de salida característica estática regulador LDO.

Eciencia: Para medir la eciencia del circuito, se ingresan diferentes valores de tensión de entrada Vcc y se evalúa la potencia de entregada y la potencia sobre la carga, para una RL = 100 Ω. El resultado se observa en la guar 25.

Como es de esperar para un regulador lineal, la eciencia no es buena, y es fuertemente dependiente de la tensión de entrada. Esto se debe a que el transistor de paso disipa la potencia no útil:

PT paso = (Vcc − Vreg) ∗ (Vreg/RL) | (30)

Como tal, se espera una eciencia máxima para valores Vcc cercanos a Vreg y resistencias de carga RL bajas. Al aumentar RL, la eciencia aumenta hasta el punto donde la corriente que circula por el circuito de control se hace comparable con la que circula por RL.

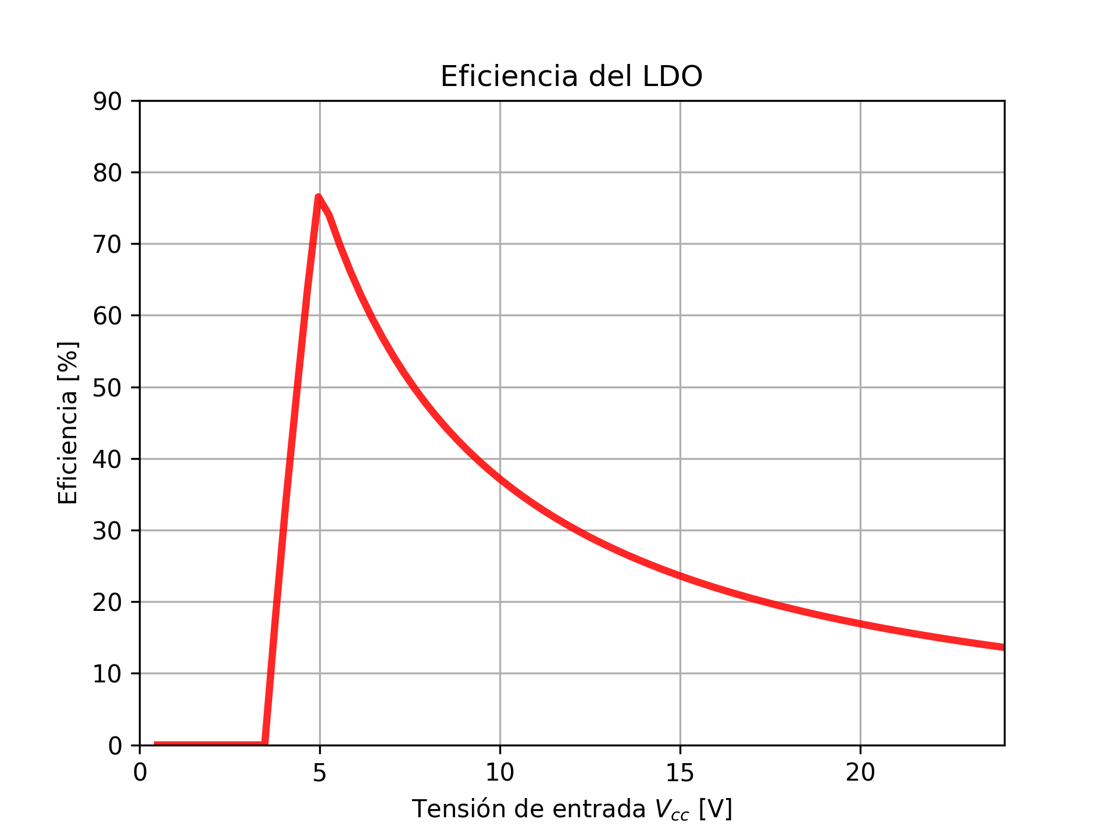
[picture p40: figure]

Figura 25: Eciencia del regulador para 0 V < Vcc < 24 V.

3.1.2. Modo Dinámico
3.2. Simulaciones de fuente switching

aaa

## 4. Conclusiones

4.1. Regulador Lineal LDO

El regulador lineal diseñado cumple con las especicaciones de la tabla 2, sin embargo, no es ideal:

El rechazo de ripple de la fuente de alimentación no es bueno, y prácticamente permite el paso de toda la oscilación de entrada. Este punto debe ser analizado con mayor detalle al realizar la compensación del circuito.

El lazo de corriente es lento, ya que cuenta con muchas etapas.

Asimismo, cuenta con algunas virtudes:

La regulación de línea es excelente, así como la regulación de carga.

La eciencia es muy buena para tratarse de un regulador lineal, sobre todo para resistencias de carga bajas.

El valor de VDO es muy bueno.

Se concluye que el regulador es apto para la aplicación en este proyecto, pero se deberán tener precauciones durante el diseño de la etapa switching, o en su defecto se deberá robustecer el diseño.

Algunas reexiones adicionales:

El limitador de corriente shunt actúa mas rápido"que el limitador por foldback hecho con amplicadores operacionales, ya que estos últimos suelen ser "lentos".Esto permite que ante un corto (RL muy baja), no se dispare una elevada corriente y actúe primero el limitador de corriente.

Un transistor de paso hecho con un PMOS presenta una tensión de Drop Out baja, este tipo de circuitos se los conoce como Low Drop Out.

Utilizar cargas activas en los amplicadores diferenciales presentan una mejor RRMC.

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

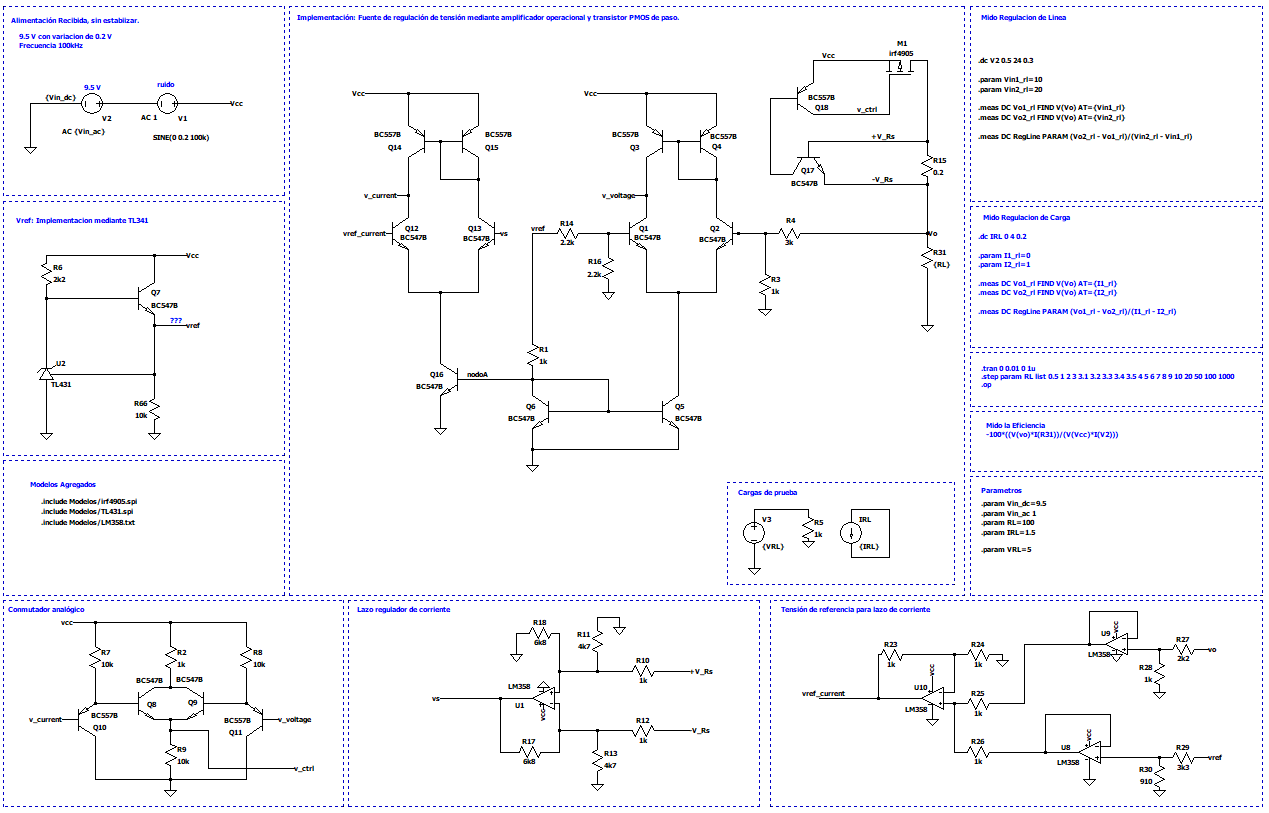
[picture p41: figure]

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

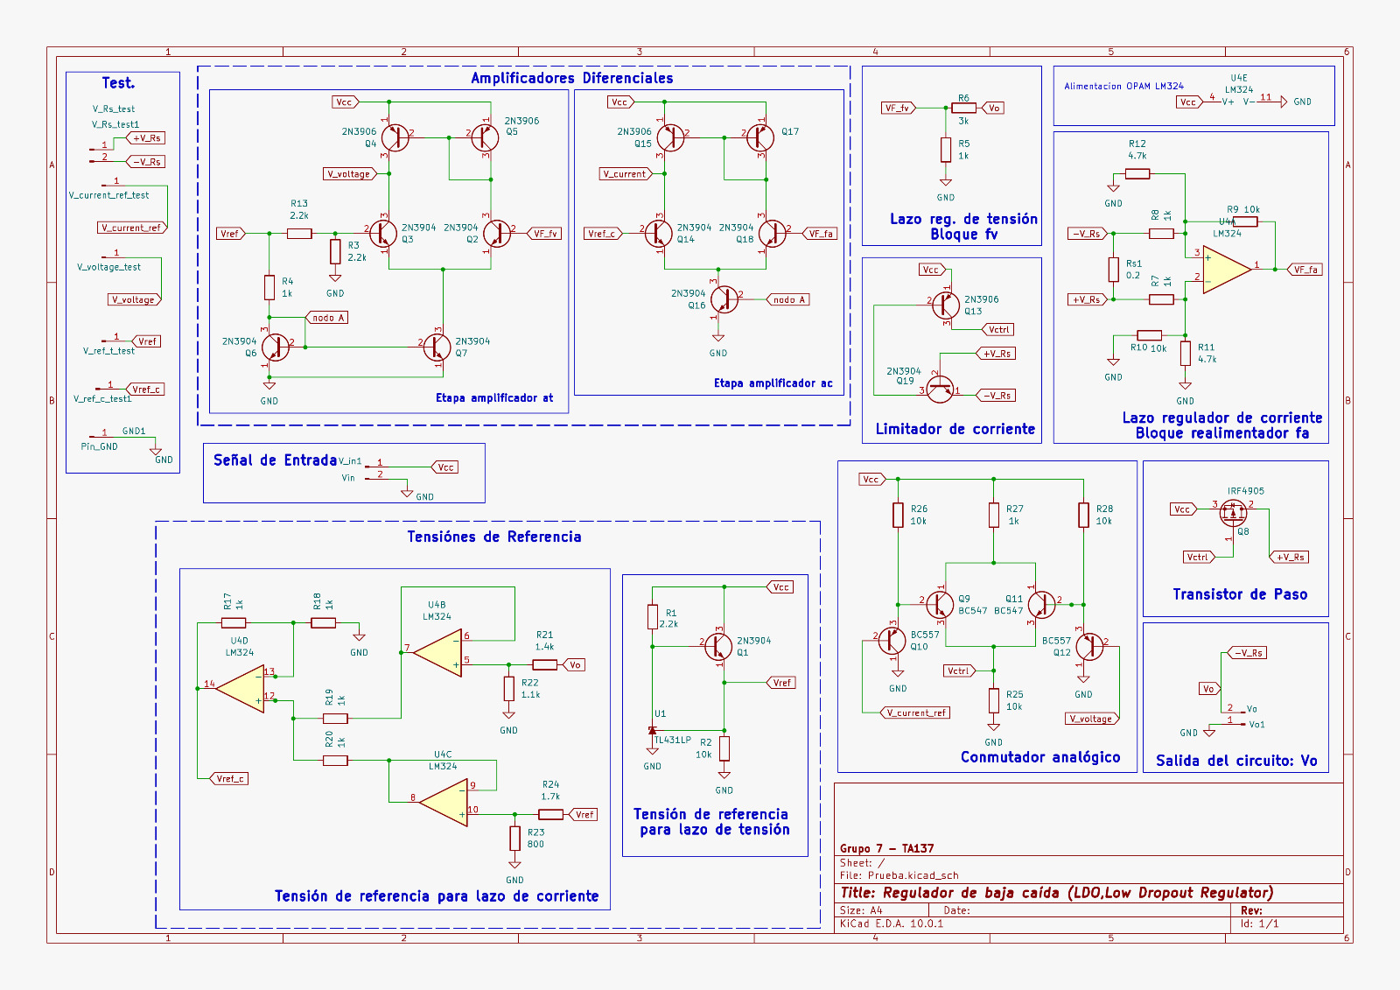
[picture p42: figure]

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
