Seba-SL/TP-Taller-de-Dise-o-de-Circuitos-Electr-nicos-TA138-/Checkpoints/Checkpoint 4/Informe CHK 4/img/LDO/Presupuesto.pdf

# Hoja1

PCB (LDO)

Componente | Detalle | Cantidad | Precio | Datasheet | Encapsulado | Proveedor
Bornera 2x1 | Vo y Vin | 2 | 550
Pines 2x1 | V_Rs_test | 2 | 181 | https://www.microelectronicash.com
Pines 2x1 | V_current_test | 3 | 182 | https://www.microelectronicash.com
Pines 2x1 | V_voltage_test | 4 | 183 | https://www.microelectronicash.com
Pines 2x1 | V_ref_test | 5 | 184 | https://www.microelectronicash.com
Pines 2x1 | V_ref_c_test | 6 | 185 | https://www.microelectronicash.com
Transistor npn | 2N3904 | 7 | 186 Ver datasheet | TO-92 | https://www.microelectronicash.com
Transistor pnp | 2N3906 | 8 | 187 Ver datasheet | TO-92
Transistor PMOS | IRF4905 | 9 | 188 Ver datasheet | TO-220
Transistor npn | BC547 | 10 | 189 | TO-92
Transistor pnp | BC557 | 11 | 190 | TO-92
Resistor | 2.2k | 10 | 191 | THT | https://www.microelectronicash.com
Resistor | 10k | 15 | 192 | THT | https://www.microelectronicash.com
Resistor | 1k | 10 | 193 | THT | https://www.microelectronicash.com
Resistor | 3k | 5 | 194 | THT | https://www.microelectronicash.com
Resistor | 4.7k | 10 | 195 | THT | https://www.microelectronicash.com
Resistor | 1.4k | 5 | 196 | THT | https://www.microelectronicash.com
Resistor | 1.1k | 5 | 197 | THT | https://www.microelectronicash.com
Resistor | 0.8k | 5 | 198 | THT | https://www.microelectronicash.com
Resistor | 1.7k | 5 | 199 | THT | https://www.microelectronicash.com
Preset ajust | 20 vueltas | 2 | 200
Alambre Resistor | 0.2 | 1 | 201 | THT | https://www.microelectronicash.com
Referencia Prog. | TL431LP | 1 | 202 Ver datasheet | TO-92 | https://www.microelectronicash.com
Amplificador Op. | LM324 | 1 | 203 Ver datasheet | PDIP-8 | https://www.microelectronicash.com
Disipador | 1 | 204 | TO-220
PCB virgen | 10x10 doble faz | 1 | 205
Total PCB | 28050

https://www.microelectronicash.com

https://www.microelectronicash.com

https://www.microelectronicash.com

https://www.microelectronicash.com

https://www.microelectronicash.com

https://www.ide-shop.com.ar/productos/disipador-to220-negro-aleteado-15x10x20mm-x5u/

https://www.ide-shop.com.ar/productos/placa-virgen-fr4-doble-faz/
