Seba-SL/TP-Taller-de-Dise-o-de-Circuitos-Electr-nicos-TA138-/Simulación/LDO/Graficos en Python/Capturas/LDO_Bode_lazo_corriente_shunt.png

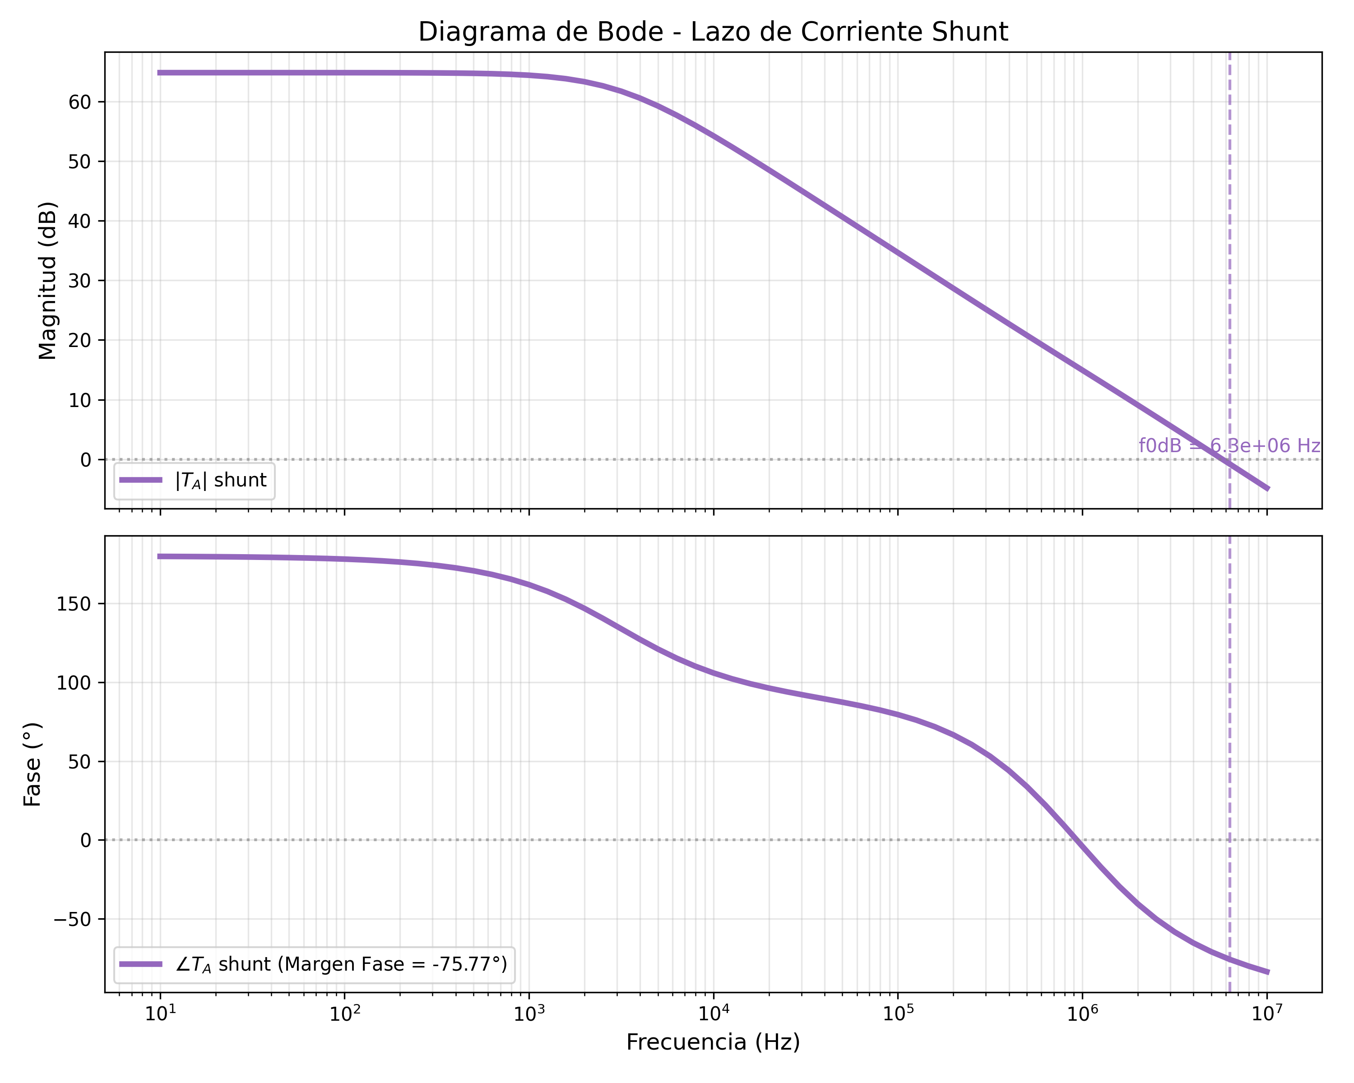
Simulación/LDO/Graficos en Python/Capturas/LDO_Bode_lazo_corriente_shunt.png
