Seba-SL/TP-Taller-de-Dise-o-de-Circuitos-Electr-nicos-TA138-/Documentación/Hoja de Calculo- Presupuesto/Presupuesto (copia).xlsx

PCB (LDO) |  |  |  |  |  |  | Gabinete
Componente | Detalle | Cantidad | Precio | Datasheet | Encapsulado | Proveedor | Componente | Cantidad | Precio | Datasheet | Proveedor
Pines 2x1 | Vo | 1 | 180 |  |  | https://www.microelectronicash.com
Pines 2x1 | V_Rs_test | 1 | 180 |  |  | https://www.microelectronicash.com
Pines 2x1 | V_current_test | 1 | 180 |  |  | https://www.microelectronicash.com
Pines 2x1 | V_voltage_test | 1 | 180 |  |  | https://www.microelectronicash.com
Pines 2x1 | V_ref_test | 1 | 180 |  |  | https://www.microelectronicash.com
Pines 2x1 | V_ref_c_test | 1 | 180 |  |  | https://www.microelectronicash.com
Transistor npn | 2N3904 | 9 | 246 | Ver datasheet | TO-92 | https://www.microelectronicash.com
Transistor pnp | 2N3906 | 5 | 203 | Ver datasheet | TO-92 | https://www.microelectronicash.com
Transistor PMOS | IRF4905 | 2 | 5352 | Ver datasheet | TO-220 | https://www.microelectronicash.com
Transistor npn | BC547 | 2 | 246 |  | TO-92 | https://www.microelectronicash.com
Transistor pnp | BC557 | 2 | 203 |  | TO-92 | https://www.microelectronicash.com
Resistor | 2.2k | 3 | 75 |  | THT | https://www.microelectronicash.com
Resistor | 10k | 6 | 75 |  | THT | https://www.microelectronicash.com
Resistor | 1k | 9 | 75 |  | THT | https://www.microelectronicash.com
Resistor | 3k | 1 | 75 |  | THT | https://www.microelectronicash.com
Resistor | 4.7k | 2 | 75 |  | THT | https://www.microelectronicash.com
Resistor | 1.4k | 1 | 75 |  | THT | https://www.microelectronicash.com
Resistor | 1.1k | 1 | 75 |  | THT | https://www.microelectronicash.com
Resistor | 0.8k | 1 | 75 |  | THT | https://www.microelectronicash.com
Resistor | 1.7k | 1 | 75 |  | THT | https://www.microelectronicash.com
Preset ajust | 10 | 2 | 3115
Alambre Resistor | 0.2 | 1 | 75 |  | THT | https://www.microelectronicash.com
Referencia Prog. | TL431LP | 2 | 2000 | Ver datasheet | TO-92 | https://www.microelectronicash.com
Amplificador Op. | LM324 | 1 | 942 | Ver datasheet | PDIP-8 | https://www.microelectronicash.com
Disipador |  | 5 | 866 |  | TO-220 | https://www.ide-shop.com.ar/productos/disipador-to220-negro-aleteado-15x10x20mm-x5u/
PCB virgen | 10x10 doble faz | 0 | 3798 |  |  | https://www.ide-shop.com.ar/productos/placa-virgen-fr4-doble-faz/
 |  | 0 | 0
 |  | 0 | 0
 |  | 0 | 0
 |  | 0 | 0
 |  | 0 | 0
Total PCB | 27133 |  |  |  |  |  | Total Gabinete | 0
Total | 27133
