Seba-SL/TP-Taller-de-Dise-o-de-Circuitos-Electr-nicos-TA138-/Simulación/BUCK/Modelos/infineon-ir2111-pspice-simulationmodels-en/Model/results/demo_testbench.png

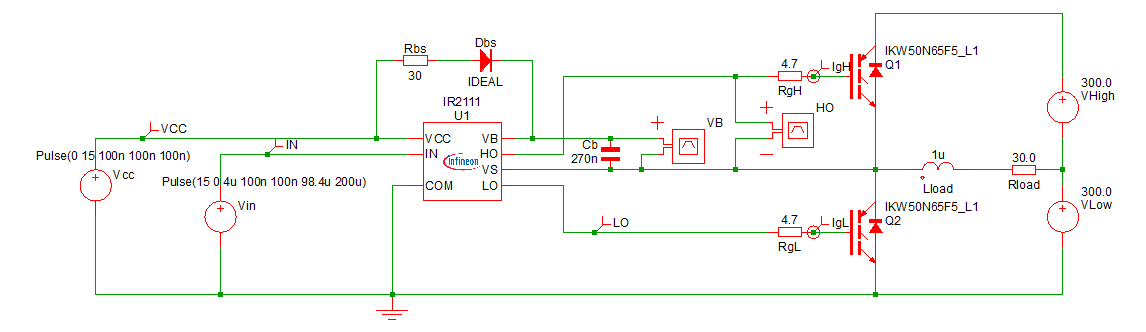
Simulación/BUCK/Modelos/infineon-ir2111-pspice-simulationmodels-en/Model/results/demo_testbench.png
