Seba-SL/TP-Taller-de-Dise-o-de-Circuitos-Electr-nicos-TA138-/Simulación/BUCK/Modelos/infineon-ir2111-pspice-simulationmodels-en/Model/results/waveforms.png

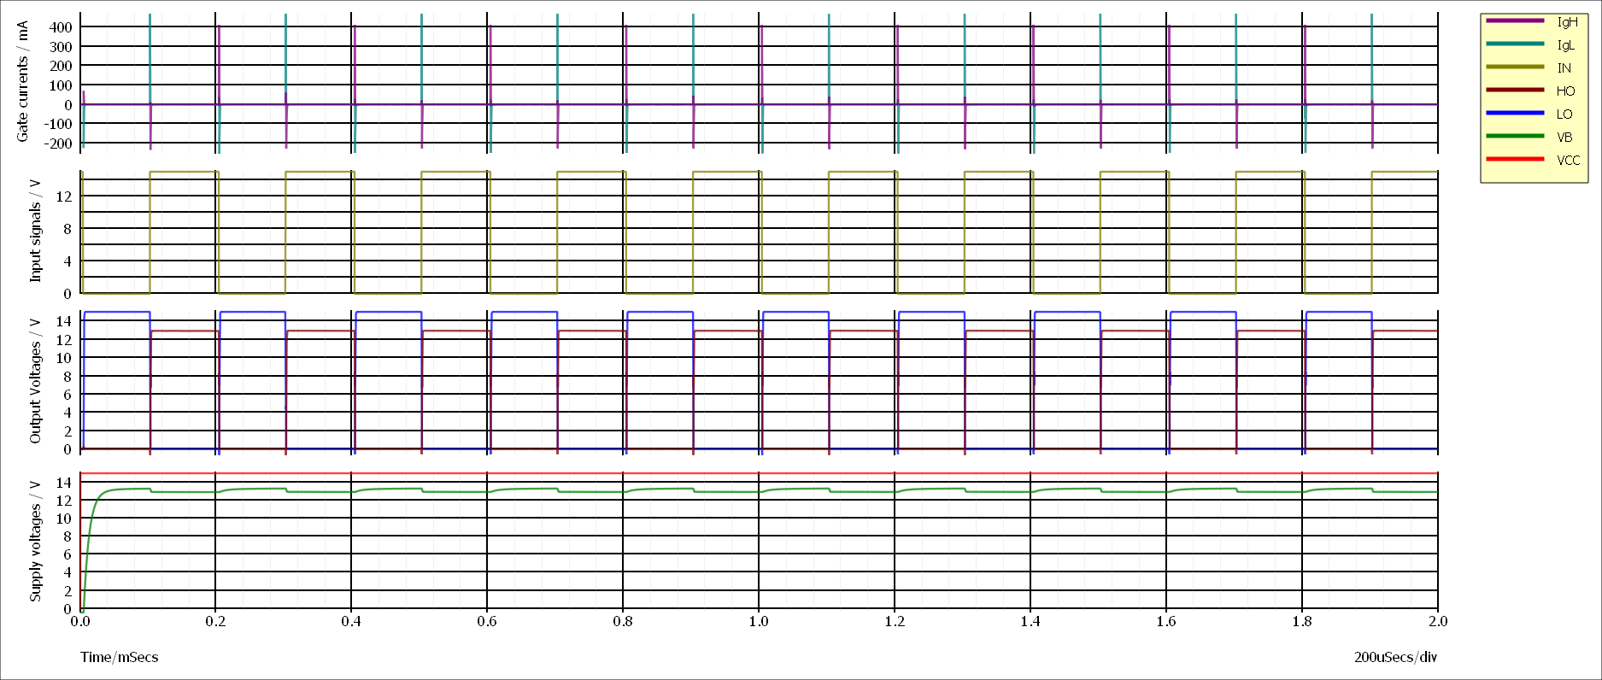
Simulación/BUCK/Modelos/infineon-ir2111-pspice-simulationmodels-en/Model/results/waveforms.png
