Seba-SL/TP-Taller-de-Dise-o-de-Circuitos-Electr-nicos-TA138-/Simulación/BUCK/pwm.asc

C1: cap; 1n
Q1: npn; BC547B
R1: res; 33k
R2: res; 100k
R3: res; 5k6
R4: res; 10k
R5: res; 33k
R6: res; 1k
R7: res; 1k
R8: res; 1k
R9: res; 1k
R10: res; 56k
R11: res; 10k
R12: res; 56k
R13: res; 10k
R14: res; 1k
R15: res; 100k
R16: res; 100k
R17: res; 1k
U1: opamp2; TL082
U2: TL431
U3: opamp2; LM319
U4: opamp2; TL082
U5: opamp2; LM319
V1: voltage; SINE(9.5 1.5 10k)
V2: voltage; 12
Named nets: 0, v_cuad, v_triag, vmed, Vee, vcc5, v_sense, Vo, PWM
.include Modelos/lm393.lib
.tran 0 1m 0 .1u startup
vo = 0   -> Vin_{switch} = Vcc/2 * (1 + R1/R2)
vo = vcc -> Vin_{switch} = Vcc/2 * (1 - R1/R2)
.include Modelos/TL082.txt
.include Modelos/lm358.txt
.options gmin=1e-10
.options abstol=1e-10
.options reltol=0.003
.include Modelos/TL431.spi
Directivas y comentarios
Generador de señal triangular
Alimentación y vref
Generador PWM
Vsense
.include LM319.txt
.include Modelos/irf3205.spi
.include Modelos/ir2111.lib
