Seba-SL/TP-Taller-de-Dise-o-de-Circuitos-Electr-nicos-TA138-/Simulación/BUCK/CircuitoCompleteo_buck_pwm.asc

1n: cap; 100p
C1: cap; 100µ
C2: cap; 100µ
D1: schottky; MBR735
L1: ind; 50µ
M1: nmos; irf3205
R1: res; 35k
R3: res; 10
R4: res; 2.5k
R5: res; 5k
R6: res; 1k
R7: res; 2k8
R8: res; 1k
R9: res; 33k
R10: res; 1k
R66: res; 10k
RL: res; 10k
U1: AD8039
U2: TL431
U3: AD8039
U4: AD8039
U5: LT1720
V1: voltage; PULSE(0 1 0 1u 1u 1m 100m)
V2: voltage; PULSE(24 0 0 1n 1n 3.7u 7.14u)
V3: voltage; 10
V4: voltage; -10
VEE: voltage; 24
Named nets: 0, Vo, Vs, Vee, Vcc, Vtriang, Vcuad, -Vcc, Vref, Vmuestra, Verror, Vpwm, Vctrl
Vref: Implementacion mediante TL341
.include Modelos/irf3205.spi
Modelos Agregados
BUCK ( Simulación a lazo abierto)
.include Modelos/TL431.spi
.include Modelos/LM358.txt
.include Modelos/LM324.txt
.tran 0 5m 1m 1u
Señal de control prueba
Simulaciónes
Oscilador
2.5 V +- error
Muestreo
PWM
Gate Driver
.include Modelos/IR2111.lib
