Seba-SL/TP-Taller-de-Dise-o-de-Circuitos-Electr-nicos-TA138-/Simulación/BUCK/Buck_lazo_abierto.asc

C2: cap; 100µ
C3: cap; 100µ
C4: cap; 10µ
D1: LED; NSPW500BS
D2: diode; MBR735
L1: ind; 50µ
M1: nmos; IRF1404
M2: nmos; IRF1404
RL1: res; 5k
U7: IR2111
VEE: voltage; 24
Vgenerador: voltage; PULSE(12 0 0 0 0 3u 7.5u)
Named nets: 0, Vo, Vs, Vee, Vctrl_H, Vctrl_L, vctrl_L, vctrl_H, PWM
.include Modelos/lm393.lib
.tran 0 10m 0 1u startup
.include Modelos/TL082.txt
.include Modelos/lm358.txt
.options gmin=1e-10
.options abstol=1e-10
.options reltol=0.003
.include Modelos/TL431.spi
Directivas y comentarios
.include LM319.txt
BUCK
.include Modelos/irf3205.spi
Gate Driver
.include Modelos/ir2111.lib
