Seba-SL/TP-Taller-de-Dise-o-de-Circuitos-Electr-nicos-TA138-/Simulación/BUCK/CircuitoCompleteo_buck_sincrono_pwm.asc

C1: cap; 1n
C2: cap; 100µ
C3: cap; 100µ
C4: cap; 10µ
D2: diode; MBR735
L1: ind; 50µ
M1: nmos; IRF1404
M2: nmos; IRF1404
Q1: npn; BC547B
R1: res; 33k
R2: res; 100k
R3: res; 5k6
R4: res; 10k
R5: res; 22k
R6: res; 1k
R7: res; 1k
R8: res; 100
R9: res; 1k
R10: res; 14k
R11: res; 5k
R12: res; 22
R14: res; 1k
R15: res; 100k
R16: res; 100k
RL1: res; 5k
U1: opamp2; TL082
U2: IR2111
U3: opamp2; LM319
U4: opamp2; TL082
U5: opamp2; LM319
U6: TL431
VEE: voltage; 24
Vgenerador: voltage; PULSE(0 12 0 0 0 2.83u 7.14u)
Named nets: 0, v_cuad, v_triag, vmed, Vee, vcc5, v_sense, Vo, Vs, Vctrl_H, Vctrl_L, vctrl_L, vctrl_H, vee, PWM, Vgenerador
.include Modelos/lm393.lib
.tran 0 10m 0 1u startup
vo = 0   -> Vin_{switch} = Vcc/2 * (1 + R1/R2)
vo = vcc -> Vin_{switch} = Vcc/2 * (1 - R1/R2)
.include Modelos/TL082.txt
.include Modelos/lm358.txt
.options gmin=1e-10
.options abstol=1e-10
.options reltol=0.003
.include Modelos/TL431.spi
Directivas y comentarios
Generador de señal triangular
T = 4 * (R1/R2) * R3 * C1
Alimentación y vref
Generador PWM
Vsense
.include LM319.txt
BUCK
.include Modelos/irf3205.spi
Gate Driver
.include Modelos/ir2111.lib
