Seba-SL/TP-Taller-de-Dise-o-de-Circuitos-Electr-nicos-TA138-/Simulación/BUCK/buck.asc

1n: cap; 100p
C1: cap; 100µ
C2: cap; 100µ
D2: LED; NSPW500BS
L1: ind; 500µ
M1: pmos; irf4905
M2: pmos; irf4905
R1: res; 35k
R2: res; 10k
R3: res; 10k
R4: res; 2.5k
R5: res; 5k
R6: res; 1k
R7: res; 2k8
R8: res; 1k
R9: res
R66: res; 10k
RL: res; 10k
U1: AD8039
U2: TL431
U4: AD8039
V1: voltage; PULSE(0 1 0 1u 1u 1m 100m)
V2: voltage; PULSE(24 0 0 1n 1n 2.8u 7.14u)
V3: voltage; 10
V4: voltage; -10
VEE: voltage; 24
Named nets: 0, Vctrl, Vo, Vs, vmed, Vee, Vcc, Vtriang, Vcuad, -Vcc, Vref, Vmuestra
Vref: Implementacion mediante TL341
.include Modelos/irf4905.spi
Modelos Agregados
BUCK
.include Modelos/TL431.spi
.include Modelos/LM358.txt
.include Modelos/LM324.txt
.tran 0 100m 0 1m
Señal de control prueba
Simulaciónes
Oscilador
2.5 V +- error
