Seba-SL/TP-Taller-de-Dise-o-de-Circuitos-Electr-nicos-TA138-/Simulación/LDO/simulacion_LDO_compensado.asc

C1: cap; 100p
C2: cap; 2.2n
C3: cap; 400n
C4: cap; 30p
IRL: current; {IRL}
M1: pmos; irf4905
Q1: npn; BC547B
Q2: npn; BC547B
Q3: pnp; BC557B
Q4: pnp; BC557B
Q5: npn; BC547B
Q6: npn; BC547B
Q7: npn; BC547B
Q8: npn; BC547B
Q9: npn; BC547B
Q10: pnp; BC557B
Q11: pnp; BC557B
Q12: npn; BC547B
Q13: npn; BC547B
Q14: pnp; BC557B
Q15: pnp; BC557B
Q16: npn; BC547B
Q17: npn; BC547B
Q18: pnp; BC557B
R1: res; 1k
R2: res; 1k
R3: res; 1k
R4: res; 3k
R5: res; 1k
R6: res; 2k2
R7: res; 10k
R8: res; 10k
R9: res; 10k
R10: res; 1k
R11: res; 4k7
R12: res; 1k
R13: res; 4k7
R14: res; 2.2k
R15: res; 0.2
R16: res; 2.2k
R17: res; 6k8
R18: res; 6k8
R20: res; 3
R21: res; 1.5
R23: res; 1k
R24: res; 1k
R25: res; 1k
R26: res; 1k
R27: res; 2k2
R28: res; 1k
R29: res; 3k3
R30: res; 910
R31: res; {RL}
R66: res; 10k
S1: sw
U3: TL431
U4: opamp3; LM358
U5: opamp3; LM358
U6: opamp3; LM358
U7: opamp3; LM358
V1: voltage; SINE(0 0.2 100k); AC 0
V2: voltage; {Vin_dc}; AC {Vin_ac}
V3: voltage; {VRL}
V4: voltage; PULSE(0 1 5u 0.1u 0.1u 60u 120u)
Named nets: 0, Vo, Vcc, vref, v_voltage, vcc, vo, vref_current, v_ctrl, +V_Rs, -V_Rs, v_current, vs, nodoA
Alimentación Recibida, sin estabiizar.
9.5 V con variacion de 0.2 V
Frecuencia 100kHz
Vref: Implementacion mediante TL341
.include Modelos/irf4905.spi
Modelos Agregados
ruido
9.5 V
Implementación: Fuente de regulación de tensión mediante amplificador operacional y transistor PMOS de paso.
.include Modelos/TL431.spi
.dc IRL 0 4 0.2
 
.param I1_rl=0
.param I2_rl=1
 
.meas DC Vo1_rl FIND V(Vo) AT={I1_rl}
.meas DC Vo2_rl FIND V(Vo) AT={I2_rl}
 
.meas DC RegLine PARAM (Vo1_rl - Vo2_rl)/(I1_rl - I2_rl)
Mido Regulacion de Linea
Mido Regulacion de Carga
Mido la Eficiencia
-100*((V(vo)*I(R31))/(V(Vcc)*I(V2)))
Parametros
.param Vin_dc=9.5
.param Vin_ac=0
.param RL=100
.param IRL=1.5
.dc V2 0.5 24 0.3
 
.param Vin1_rl=10
.param Vin2_rl=20
 
.meas DC Vo1_rl FIND V(Vo) AT={Vin1_rl}
.meas DC Vo2_rl FIND V(Vo) AT={Vin2_rl}
 
.meas DC RegLine PARAM (Vo2_rl - Vo1_rl)/(Vin2_rl - Vin1_rl)
.include Modelos/LM358.txt
.step param RL list 0.5 1 2 3 3.1 3.2 3.3 3.4 3.5 4 5 6 7 8 9 10 20 50 100 1000
.tran 0 200u 0 0.1u
.param VRL=5
Tensión de referencia para lazo de corriente
Conmutador analógico
Lazo regulador de corriente
.op
Cargas de prueba
.include Modelos/LM324.txt
.model SW SW(Ron=1m Roff=1Meg Vt=0.5 Vh=0.1)
