Seba-SL/TP-Taller-de-Dise-o-de-Circuitos-Electr-nicos-TA138-/(list of files, drawings)

Other design files:
Hardware/Diseño PCB/LDO/freerouting.dsn
Hardware/Diseño PCB/PWM/freerouting.dsn
Hardware/Diseño PCB/PWM/temp-freerouting.dsn
Simulación/BUCK/Modelos/lm311.dsn
Simulación/BUCK/Modelos/lm311.opj
