Seba-SL/TP-Taller-de-Dise-o-de-Circuitos-Electr-nicos-TA138-/Simulación/BUCK/Datos/alternas_VE_VO_lazoabiertobuck.py

import numpy as np
import matplotlib.pyplot as plt

# Cargar datos
datos = np.loadtxt(
    "buck_lazoabierto_ve_vo.txt",
    skiprows=1
)

# Extraer columnas
t = datos[:, 0]      # tiempo [s]
ve = datos[:, 1]     # tensión de entrada
vo = datos[:, 2]     # tensión de salida

# Convertir tiempo a microsegundos
t_us = t * 1e6

# Graficar
plt.figure(figsize=(10, 5))


# Línea horizontal en 9.5 V
plt.axhline(
    y=9.5,
    linestyle='--',
    linewidth=2,
    color ="black",
    label='Referencia 9.5 V'
)


plt.plot(t_us, vo, label=r'$V_o$', linewidth=3)

plt.xlabel('Tiempo [$\mu$s]')
plt.ylabel('Tensión [V]')
plt.title('Convertidor Buck en Lazo Abierto')
plt.grid(True)
plt.legend()

plt.tight_layout()
plt.show()
