Seba-SL/TP-Taller-de-Dise-o-de-Circuitos-Electr-nicos-TA138-/(commit log)

2026-05-05 CHK3 : Creación de latex para CHK3 individual
    [Prueba.kicad_pcb]
2026-05-05 Informe CHK3 en Checkpoints>CHK3 , agregue pistas en blanco y negro, y presupuesto
    [Prueba.kicad_sch]
2026-05-07 Placa auxiliar
    [Prueba.kicad_pcb, Prueba.kicad_sch, listaComponentes.csv]
2026-05-08 CHK3: Agregue emergency version , pistas y esquematico al informe
    [Prueba.kicad_pcb, Prueba.kicad_sch, freerouting.dsn]
2026-05-08 Correcciones menores en emergency version
    [Prueba.kicad_pcb, Prueba.kicad_sch]
2026-05-08 CHK3 : Informe
    [Prueba.kicad_sch]
2026-05-08 CHK3: Informe, regulacion de carga estatica
2026-05-08 CHK3: Informe, regulacion de linea
2026-05-09 Nueva medicion regulacion de carga
2026-05-09 CHK3: Diagrama de medición carga
2026-05-10 CHK3: Informe , limitacion de corriente
2026-05-10 CHK3: Carga activa, imagen de respuesta dinamica en osciloscopio
2026-05-10 Cambios menores a informe y actualización de placa
    [Prueba.kicad_pcb, Prueba.kicad_sch]
2026-05-11 Cambios al informe CHK3
    [Prueba.kicad_pcb, Prueba.kicad_sch]
2026-05-11 Circuito compensado
2026-05-22 CHK4: Informe y simulacion buck simple
2026-05-23 Avances cirucito pwm
    [Prueba-B_Cu.gbl, Prueba-B_Mask.gbs, Prueba-B_Paste.gbp, Prueba-Edge_Cuts.gm1, Prueba-F_Mask.gts, Prueba-F_Paste.gtp, Prueba-F_Silkscreen.gto, Prueba-NPTH.drl]
2026-05-23 Circuito PWM resuelto
    [lm311.dsn, lm311.opj]
2026-05-23 Circuito pwm
2026-05-24 CH4: buck simulacion
2026-05-24 Mejoras al circuito PWM
2026-05-26 CHK 4: Simulacion Buck
2026-05-26 CHK 4: Simulacion circuito completo
2026-05-26 CHK4: Circuito completo
2026-05-27 Intento de Gate Driver y Realimentación
2026-05-27 Correcciones al lazo de realimentación
2026-05-27 CHK4: Informe + pcb
    [Buck.kicad_pcb, Buck.kicad_sch]
2026-05-27 Avances pwm
2026-05-27 CHK4: PWM esquematico en Kicad
    [pwm.kicad_pcb, pwm.kicad_sch]
2026-05-28 CHK4: PCB pistas
    [freerouting.dsn, pwm.kicad_pcb, pwm.kicad_sch, temp-freerouting.dsn]
2026-05-28 CHK4: Correccion pcb NMOS
    [pwm.kicad_pcb, pwm.kicad_sch]
2026-05-28 CHK4: Informe
    [pwm.kicad_pcb]
2026-05-29 Placa BuckV1
    [Buck.kicad_sch, pwm.kicad_pcb, pwm.kicad_sch]
2026-05-29 Diseño de L
2026-05-30 CHK4 : Informe verificacion de tiempo de conmutacion del NMOS
2026-06-01 Agregada la conclusión
